AlexWortega/Sweetybot2/designs/sensor-v03/cad/src/README.md

# v03 native CAD parts

Quantities and masses are recorded in `../../reports/cad_parts.json` relative to this folder. Camera, sensor and servo envelopes are purchased-part keepouts; appearance-only screen graphics and pigment are not printed parts.

| Part | Quantity | Material |
|---|---:|---|
| deck | 1 | PETG |
| rail | 2 | PETG |
| body_shell | 1 | PETG |
| servo_cradle | 10 | PETG |
| servo_strap | 20 | PETG |
| roll_yoke | 4 | PETG |
| thigh_plate | 8 | PETG |
| shin_plate | 8 | PETG |
| hoof | 4 | PETG |
| head_shell | 1 | PETG |
| head_hatch | 1 | PETG |
| ear | 2 | PETG |
| mane | 1 | PETG |
| axle_adapter | 4 | PETG |
| knee_fork | 4 | PETG |
| head_yoke | 1 | PETG |
| tail | 1 | PETG |
| fit_coupon | 0 | PETG |
| horn | 1 | PETG |
| mane_stripe | 1 | PETG |
| neck_collar | 1 | PETG |
| thigh_fairing | 4 | PETG |
| shin_fairing | 4 | PETG |
| camera_carrier | 1 | PETG |
| sensor_tray | 1 | PETG |
| depth_pod | 1 | PETG |
| hoof_sole_plate | 4 | PETG |
| hoof_tpu_pad | 4 | TPU |
| hoof_actuator | 4 | TPU |
| eye_bezel | 2 | PETG |

Use `scripts.build_cad` from the candidate root to regenerate individual exports and assemblies. Vendor STS3250 geometry is retained under its existing notices. Print fits, strength and loaded sensor mechanisms remain unvalidated.
