AlexWortega/Sweetybot2/reports/legacy-v02/README.md

# Historical v02 engineering simulations

These files describe the old STS3250 chassis and controller, not the v04 hardware or policy. See ../v04_validation.json for current checks.
