AlexWortega/Sweetybot2/designs/sensor-v03/renders/studio/02-portrait.jpg

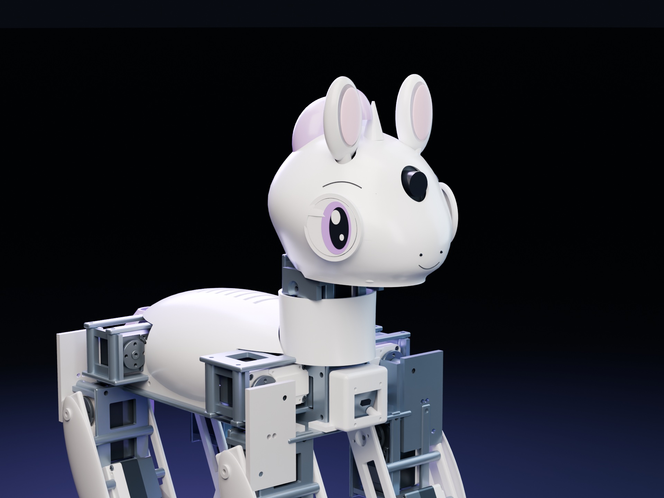
designs/sensor-v03/renders/studio/02-portrait.jpg
