AlexWortega/Sweetybot2/references/appearance/sweetie-official.jpg

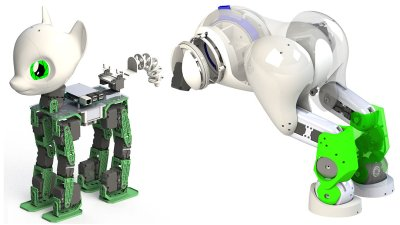
references/appearance/sweetie-official.jpg
