AlexWortega/Sweetybot2/references/appearance/sweetie-proto3-body.jpg

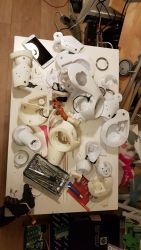
references/appearance/sweetie-proto3-body.jpg
