AlexWortega/Sweetybot2/renders/exploded.png

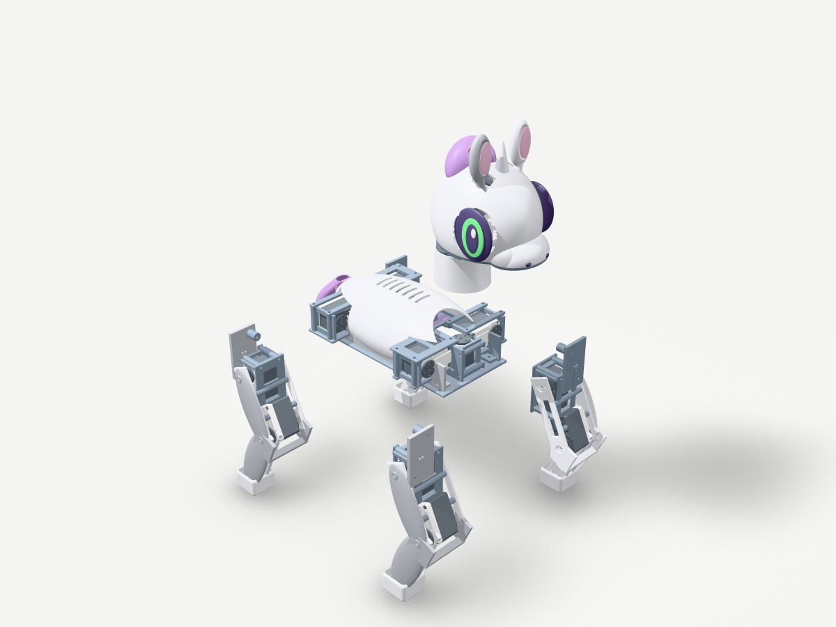
renders/exploded.png
