AlexWortega/Sweetybot2/renders/eyes_demo.gif

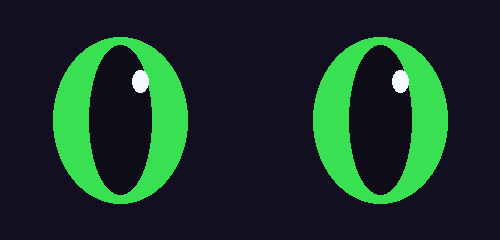
renders/eyes_demo.gif
