AlexWortega/Sweetybot2/renders/internal.png

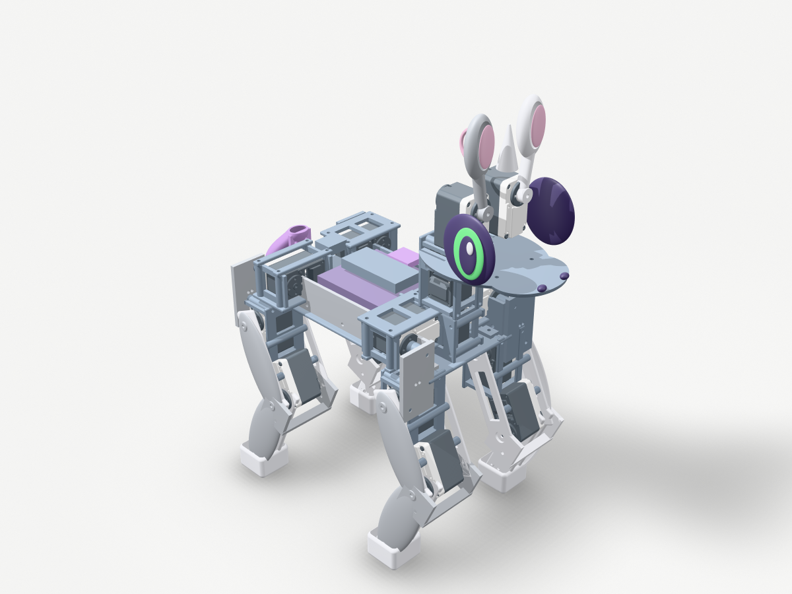
renders/internal.png
