AlexWortega/Sweetybot2/renders/v05/preview.png

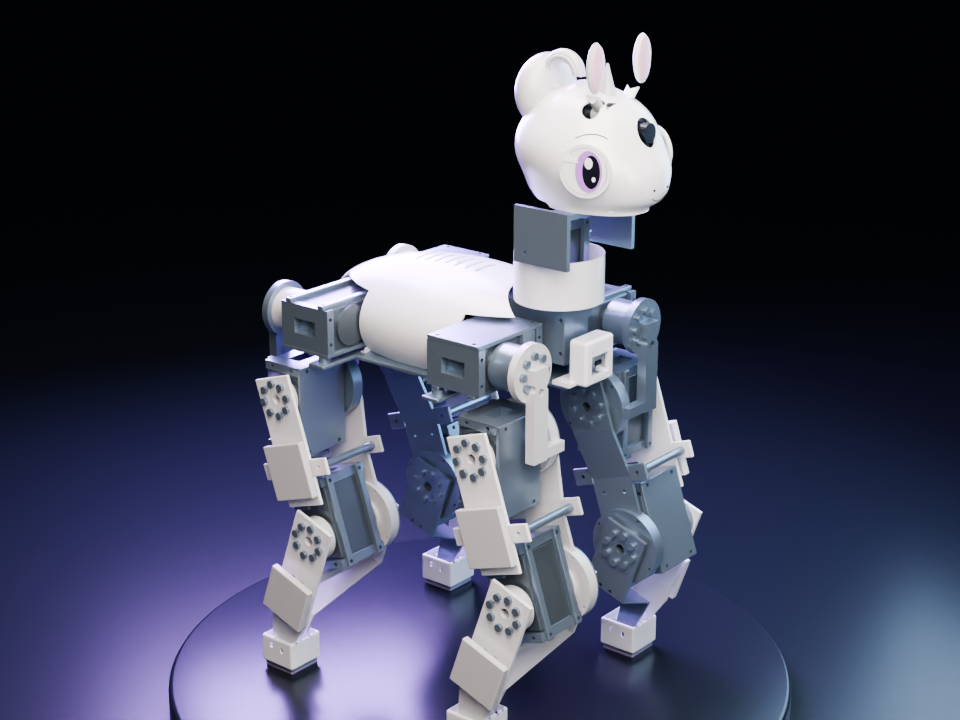
renders/v05/preview.png
