AlexWortega/Sweetybot2/renders/v05/turntable/001.png

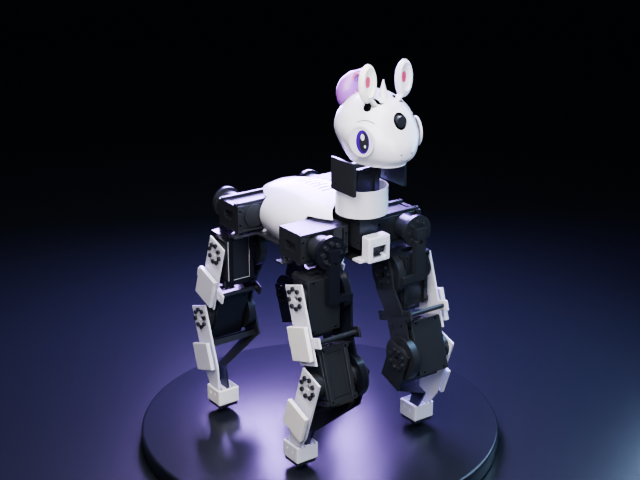
renders/v05/turntable/001.png
