AlexWortega/Sweetybot2/renders/v05/turntable/002.png

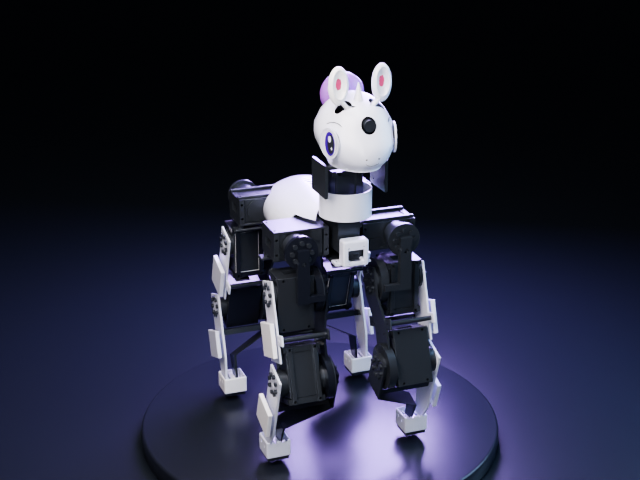
renders/v05/turntable/002.png
