AlexWortega/Sweetybot2/renders/v05/turntable/003.png

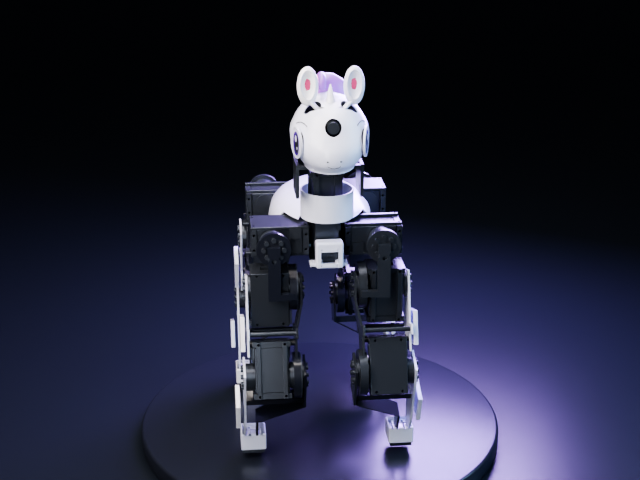
renders/v05/turntable/003.png
