AlexWortega/Sweetybot2/renders/v05/turntable/004.png

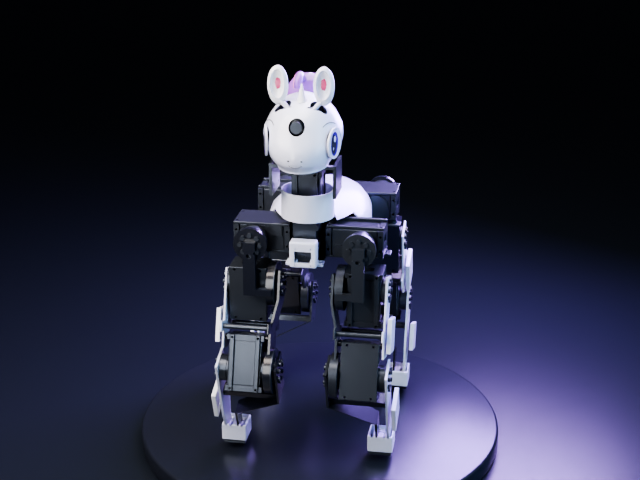
renders/v05/turntable/004.png
