AlexWortega/Sweetybot2/renders/v05/turntable/005.png

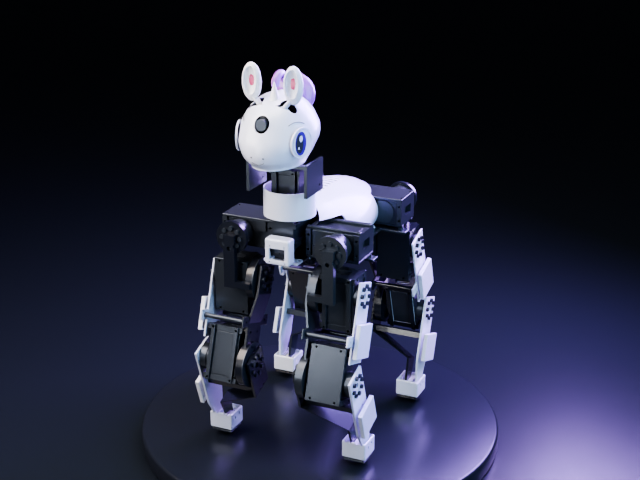
renders/v05/turntable/005.png
