AlexWortega/Sweetybot2/renders/v05/turntable/006.png

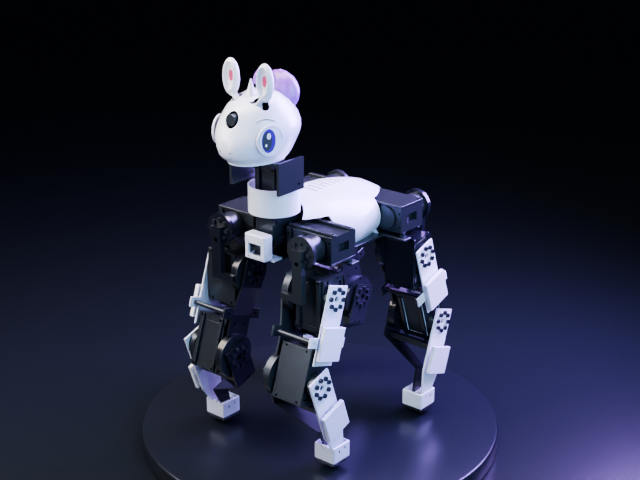
renders/v05/turntable/006.png
