AlexWortega/Sweetybot2/renders/v05/turntable/007.png

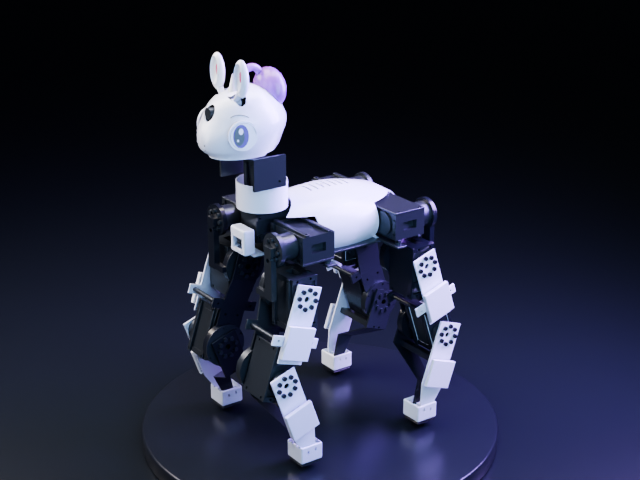
renders/v05/turntable/007.png
