AlexWortega/Sweetybot2/renders/v05/turntable/008.png

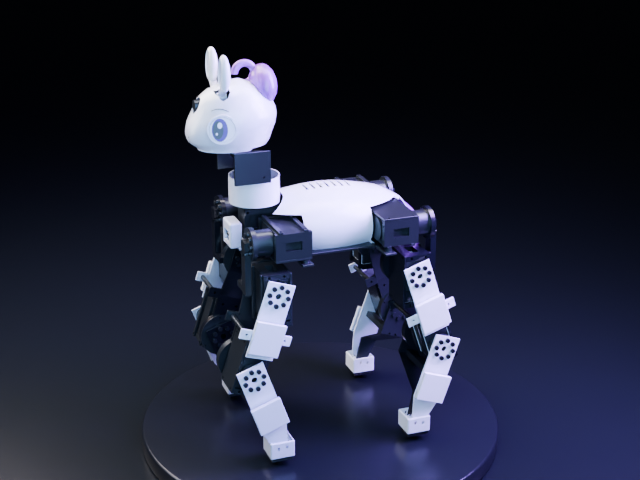
renders/v05/turntable/008.png
