AlexWortega/Sweetybot2/renders/v05/turntable/009.png

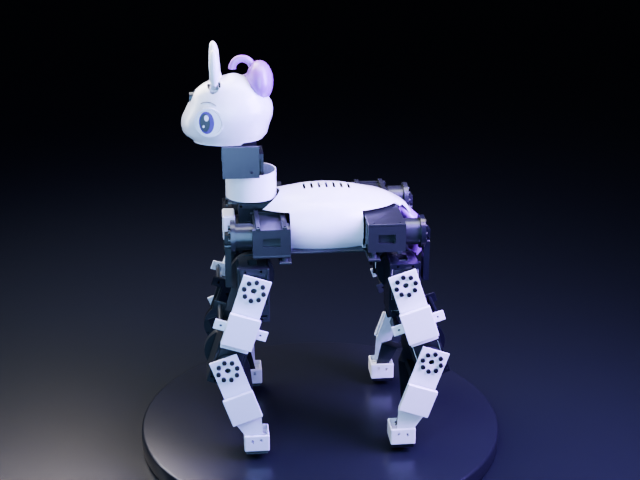
renders/v05/turntable/009.png
