AlexWortega/Sweetybot2/renders/v05/turntable/010.png

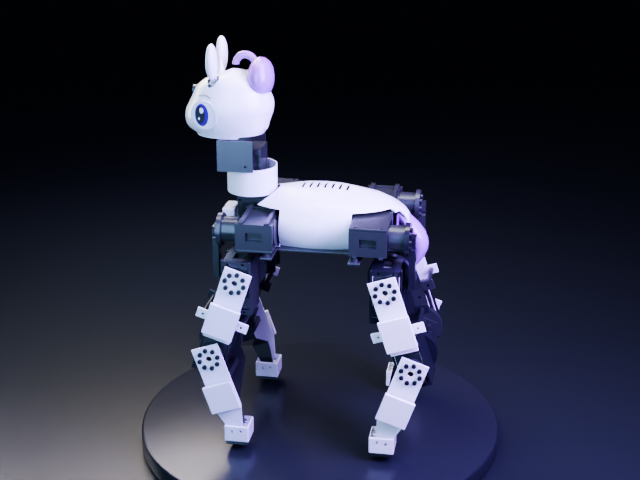
renders/v05/turntable/010.png
