AlexWortega/Sweetybot2/renders/v05/turntable/011.png

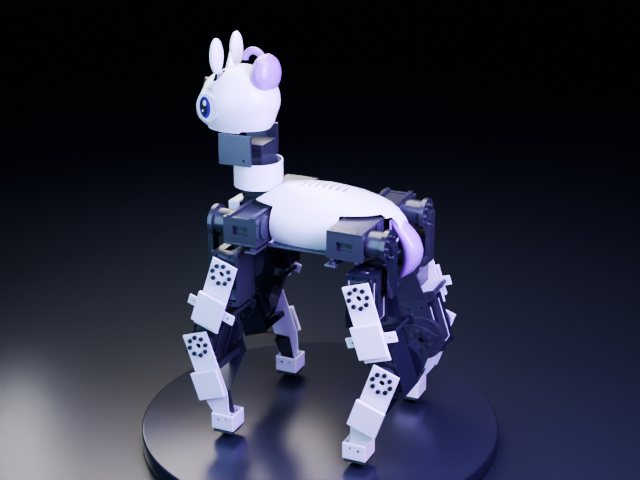
renders/v05/turntable/011.png
