AlexWortega/Sweetybot2/renders/v05/turntable/012.png

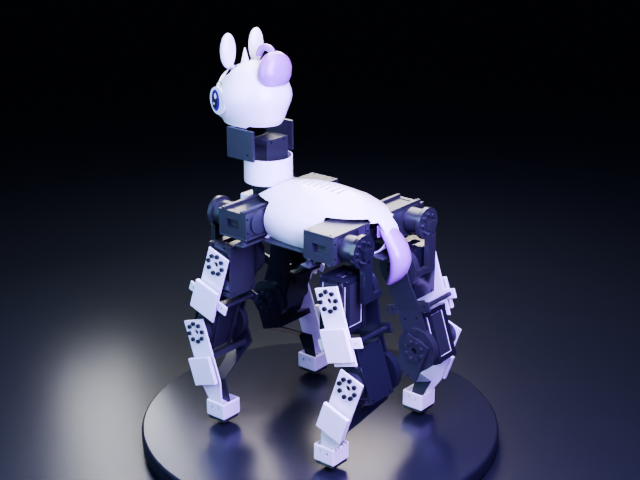
renders/v05/turntable/012.png
