AlexWortega/Sweetybot2/renders/v05/turntable/013.png

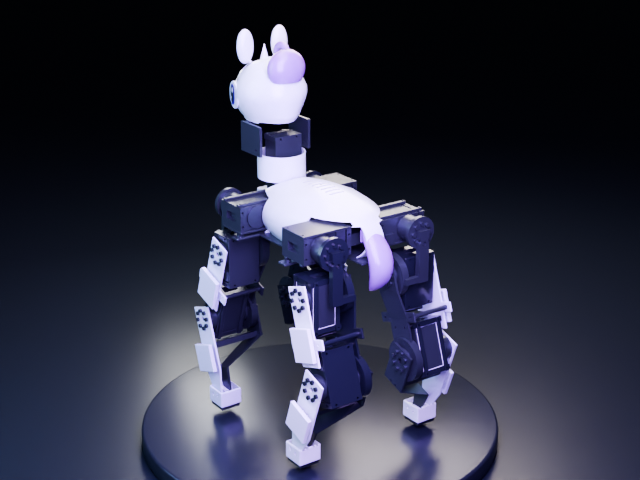
renders/v05/turntable/013.png
