AlexWortega/Sweetybot2/renders/v05/turntable/014.png

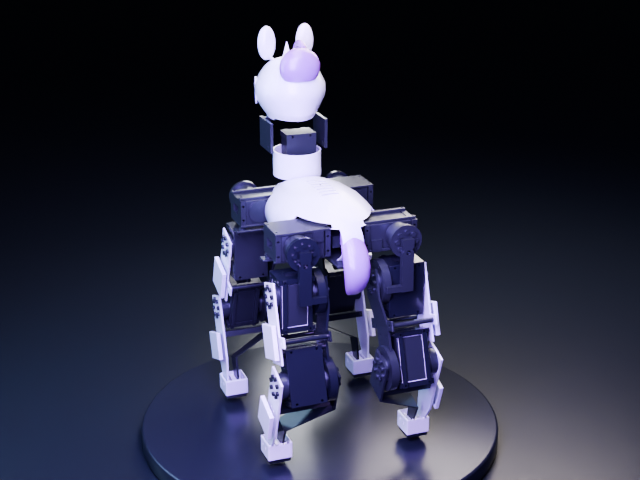
renders/v05/turntable/014.png
