AlexWortega/Sweetybot2/renders/v05/turntable/015.png

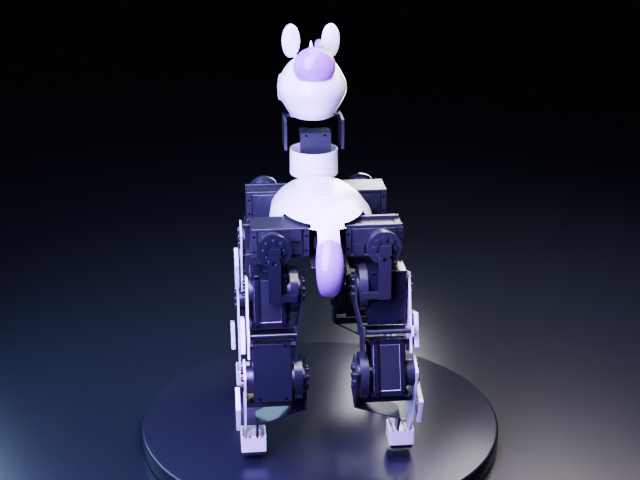
renders/v05/turntable/015.png
