AlexWortega/Sweetybot2/renders/v05/turntable/016.png

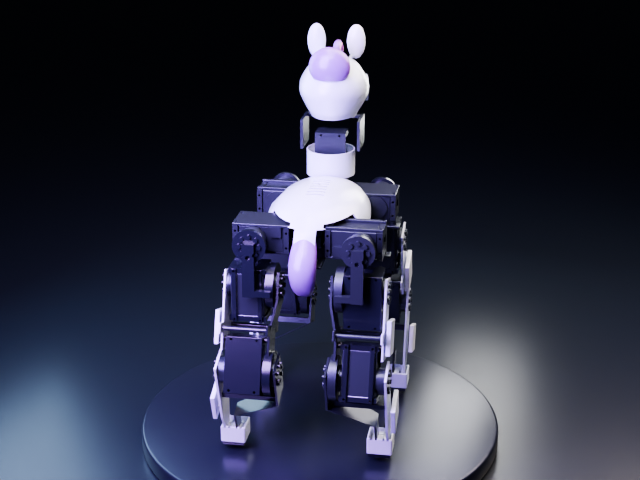
renders/v05/turntable/016.png
