AlexWortega/Sweetybot2/renders/v05/turntable/017.png

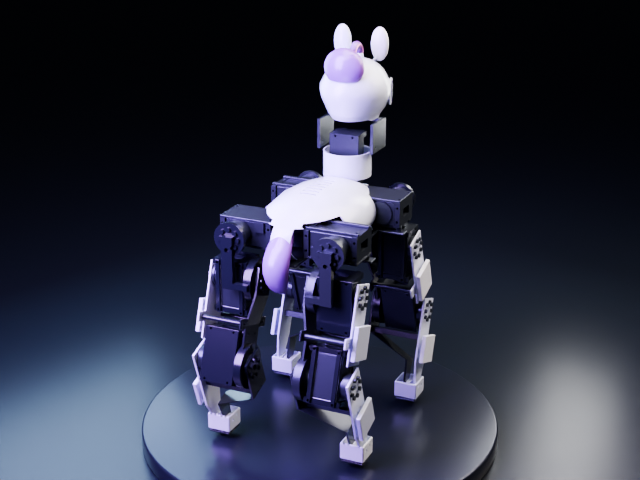
renders/v05/turntable/017.png
