AlexWortega/Sweetybot2/renders/v05/turntable/018.png

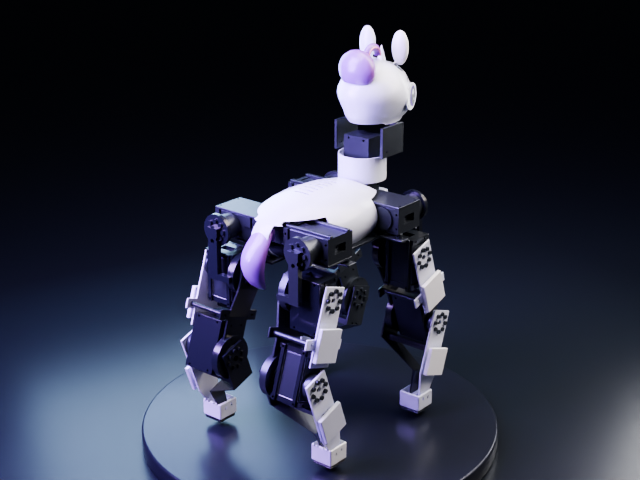
renders/v05/turntable/018.png
