AlexWortega/Sweetybot2/renders/v05/turntable/019.png

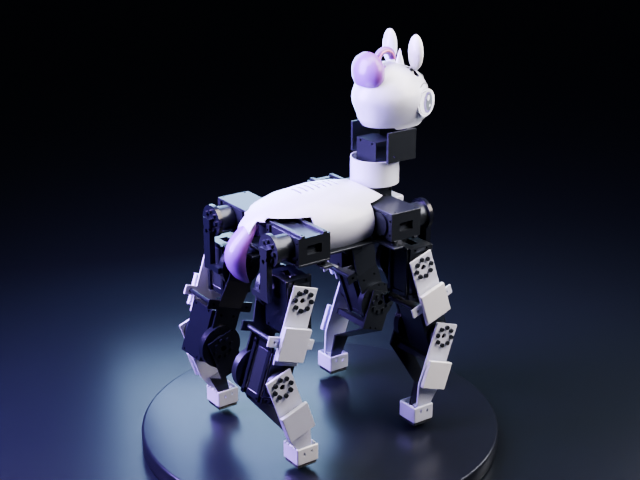
renders/v05/turntable/019.png
