AlexWortega/Sweetybot2/renders/v05/turntable/020.png

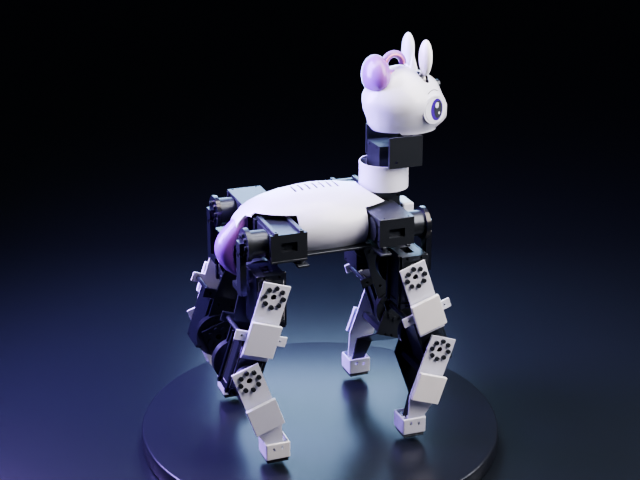
renders/v05/turntable/020.png
