AlexWortega/Sweetybot2/renders/v05/turntable/021.png

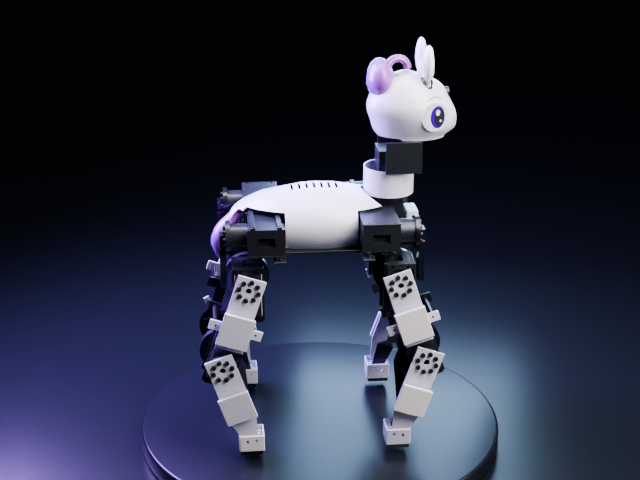
renders/v05/turntable/021.png
