AlexWortega/Sweetybot2/renders/v05/turntable/022.png

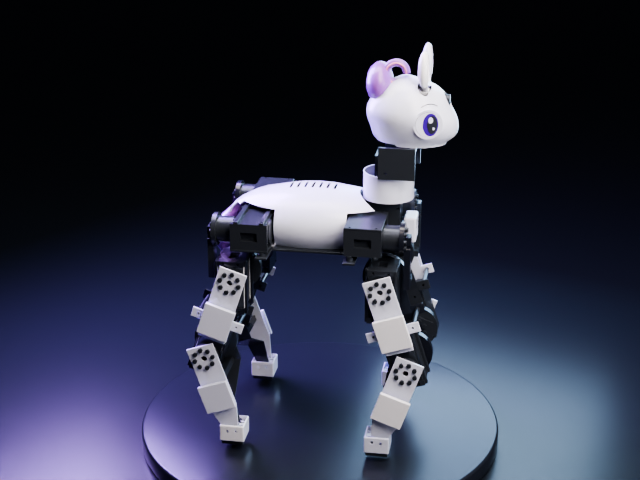
renders/v05/turntable/022.png
