AlexWortega/Sweetybot2/renders/v05/turntable/023.png

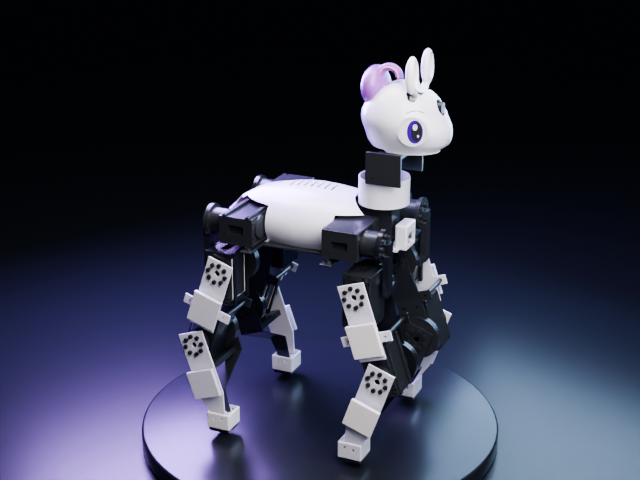
renders/v05/turntable/023.png
