AlexWortega/Sweetybot2/docs/bom-v05.csv

item | quantity | status | notes | url | unit_usd
SM105BL-C001 | 12 | candidate; not purchased | RS485 | https://ftservo.github.io/ftservo-wiki/products/models/sm-105b-c001/main/ | 120.0
STS3250-12V | 2 | candidate; not purchased | TTL SMS/STS; confirm firmware protocol | https://www.feetechrc.com/sts_ttl_series%20servo.html | 44.99
STS3032-C001-6V | 2 | candidate; not purchased | TTL SMS/STS; confirm firmware protocol | https://www.feetechrc.com/Data/feetechrc/upload/file/20200611/6372749220559698399729459.pdf | 12.0
Pololu D30V30F6 6V regulator | 1 | candidate | validate current and temperature at 3S LiFePO4 input
Dedicated 3V3 >=0.5A regulator | 1 | selection allowance | depth module supply; 13x10x5mm envelope provisional
Raspberry Pi Camera Module 3 Wide visible-light | 1 | candidate | 25x24 PCB and 12.4mm optical keepout
Pi Zero 22-pin to camera 15-pin CSI FPC | 1 | candidate | 300mm allowance; check motion loop and bending
SparkFun SEN-18642 VL53L5CX | 1 | candidate | chest 8x8 depth 15Hz target
SparkFun SEN-21325 LSM6DSV16X | 1 | candidate | rigid torso IMU
Seeed XIAO RP2040 | 1 | candidate | ADC contacts and IMU collector; firmware pending
Waveshare 1.28inch GC9A01 LCD Module | 2 | candidate | 240x240 round active area; exact module depth pending
Omron B3SE-1002P | 4 | candidate | contact switch only; no force measurement
Contact cassette PCB 12x12mm | 4 | proposed custom | layout not fabricated; include 10k EOL and series 1k
10k 1% pull-up resistor at collector | 4 | candidate | one per ADC contact signal
10k 1% EOL resistor at hoof | 4 | candidate | must sit beyond foot connector
1k 1% series contact resistor at hoof | 4 | candidate | switch branch parallel to EOL
M2 guide/shoulder hardware sets | 16 | fit selection pending | verify stroke and captive retention in single hoof prototype
Return spring OD3.5mm ID>=2.2mm free4mm | 16 | selection pending | low preload target <=0.1N per spring at installed length
Adjustable M2 actuator screw/shims | 4 | fit selection pending | compliant TPU tip and hard stop calibrated on bench
Strain relief and foot connectors | 4 sets | selection pending | seal exposed PCB and wire exits
Sensor tray | 1 | printed PETG | rigid IMU mounting
Chest depth pod | 1 | printed PETG | open optics aperture; protective window not specified
Camera carrier | 1 | printed PETG | edge clip fit coupon required
LCD bezel | 2 | printed PETG | cosmetic rim; positive PCB retention requires exact module revision
Contact hoof carrier | 4 | printed PETG | replace v02 hoof
Floating sole plate | 4 | printed PETG | hard stop carries load
Hoof tread | 4 | printed TPU | verify friction and fatigue
Actuator tip | 4 | printed TPU | verify switch actuation and overtravel
Raspberry Pi Zero 2 W + microSD | 1 | procurement specification | logic compute
USB RS485 adapter, 3.3V-safe USB logic, SMS protocol support | 1 | procurement specification | 12 leg motors only; differential A/B and common reference
Waveshare Bus Servo Adapter A (TTL only), 42x33mm | 1 | procurement specification | 2 neck and 2 ear motors; TTL signal bus separate from RS485
Adafruit CH334F USB hub 5999 + OTG and adapter cables | 1 | procurement specification | Pi Zero has one USB data port; envelope and cable routing provisional
3S LiFePO4 >=2.5Ah pack with >=40A continuous BMS | 1 | procurement specification | 9.9V nominal, 10.8V max, loaded cutoff 9.3V; real pack sag unmeasured
40A main fuse, four 10A leg, 5A head and 5A logic fuses | 1 | procurement specification | DC disconnect and fuse coordination require loaded tests
12AWG main, 16AWG leg branches, rated connectors | 1 | procurement specification | short feeds; fused parallel power; do not daisy-chain motor load current
5V >=3A logic buck + motor-only disconnect | 1 | procurement specification | logic survives motor emergency stop
6061 CNC load parts | 1 | procurement specification | deck, rails, clamps, yokes, cheek plates, forks, adapters and spacers; not FDM load parts
6807 bearings, 35x47x7mm | 8 | procurement specification | catalogue envelope; fits, retention and external load rating require bench checks
0.75 and 0.80mm rigid shim stock for 14 motor clamps | 70 | procurement specification | case and strap seating pads, gauge against purchased cases
M3 low socket heads, <=6mm diameter and <=3mm height | 160 | procurement specification | 8 per driven flange, heads included in CAD; confirm screw lengths and engagement
M2 bearing retainers and neck/ear horns | 1 | procurement specification | shaft spline datum, screw lengths, shoulder fits and loaded joints remain physical gates
