AlexWortega/Sweetybot2/renders/parts_review.jpg

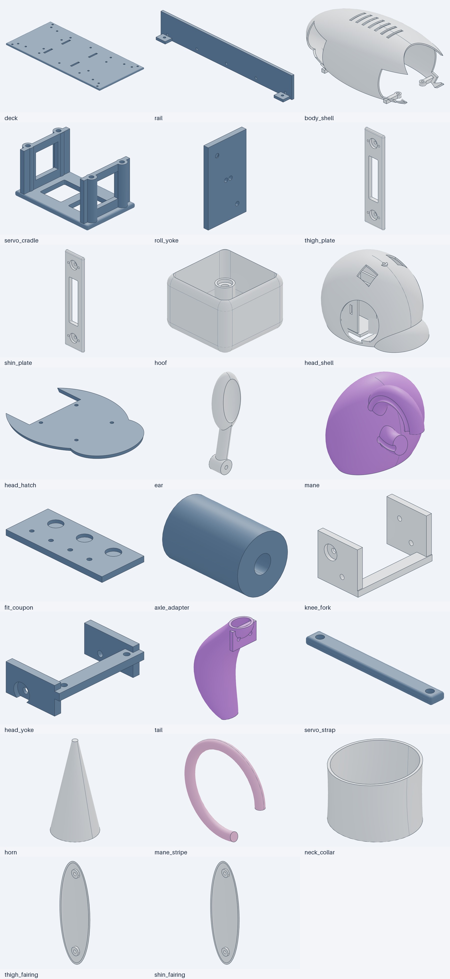
renders/parts_review.jpg
