AlexWortega/Sweetybot2/cad/collision/convex/torso__body_cowl__568.stl

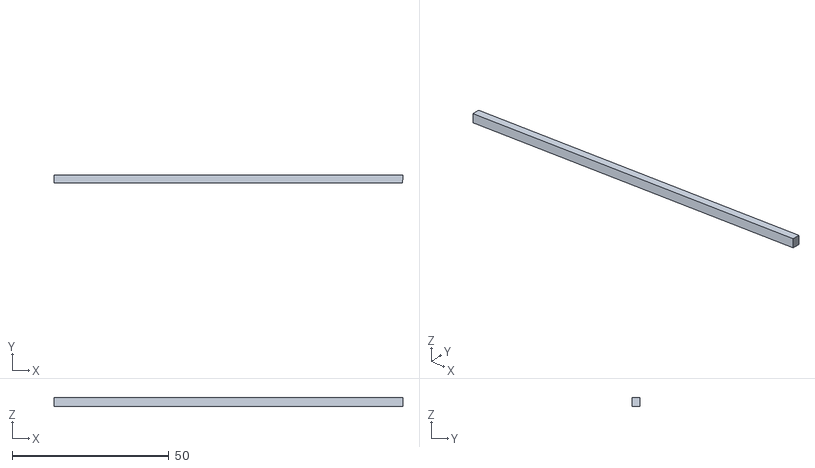
[picture p46: CAD file, 2026-10-18]
cad/collision/convex/torso__body_cowl__568.stl
111.4 x 2.44 x 2.88
