AlexWortega/Sweetybot2/cad/collision/source/ear_right__ear_output_adapter_-1.step

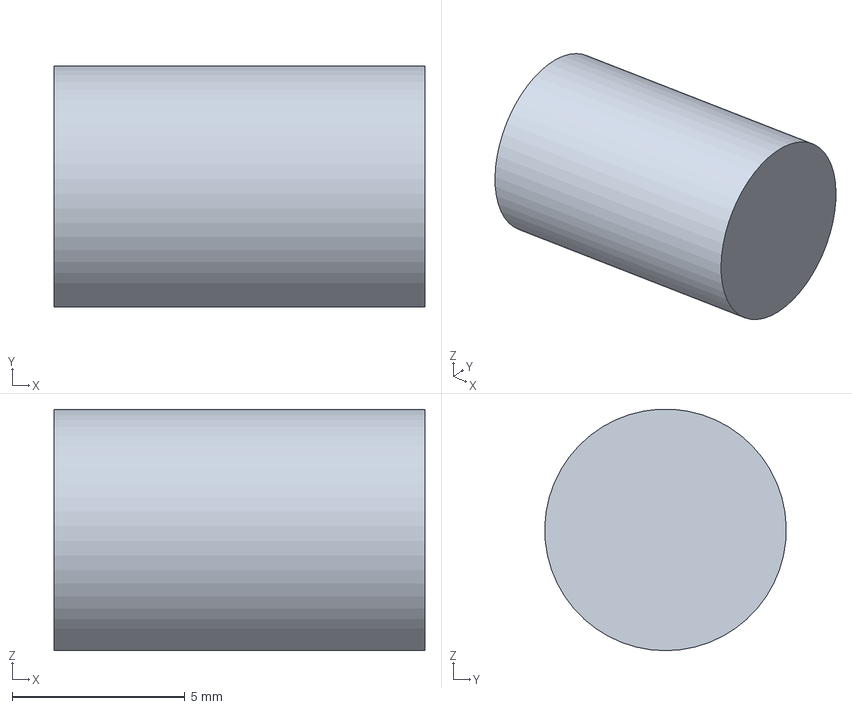
[picture p47: CAD file, 2026-10-21]
cad/collision/source/ear_right__ear_output_adapter_-1.step
10.8 x 7.00 x 6.99 mm
