AlexWortega/Sweetybot2/cad/manufacturing/torso__rl_roll_clamp_shims.step

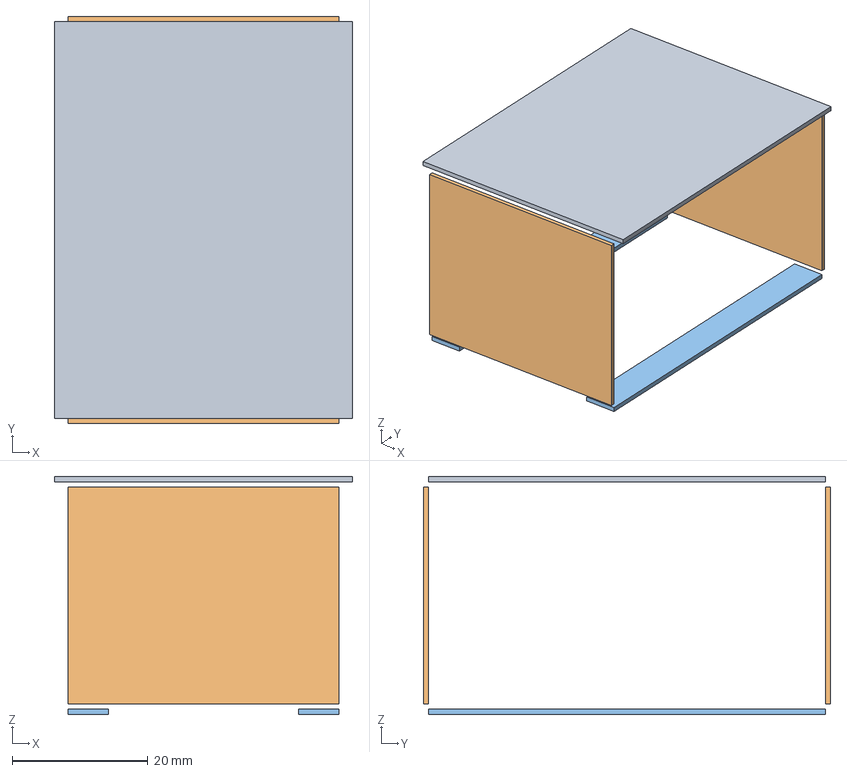
[picture p48: CAD file, 2026-10-21]
cad/manufacturing/torso__rl_roll_clamp_shims.step
44.0 x 60.0 x 35.1 mm
