AlexWortega/Sweetybot2/cad/STEP/exploded.step

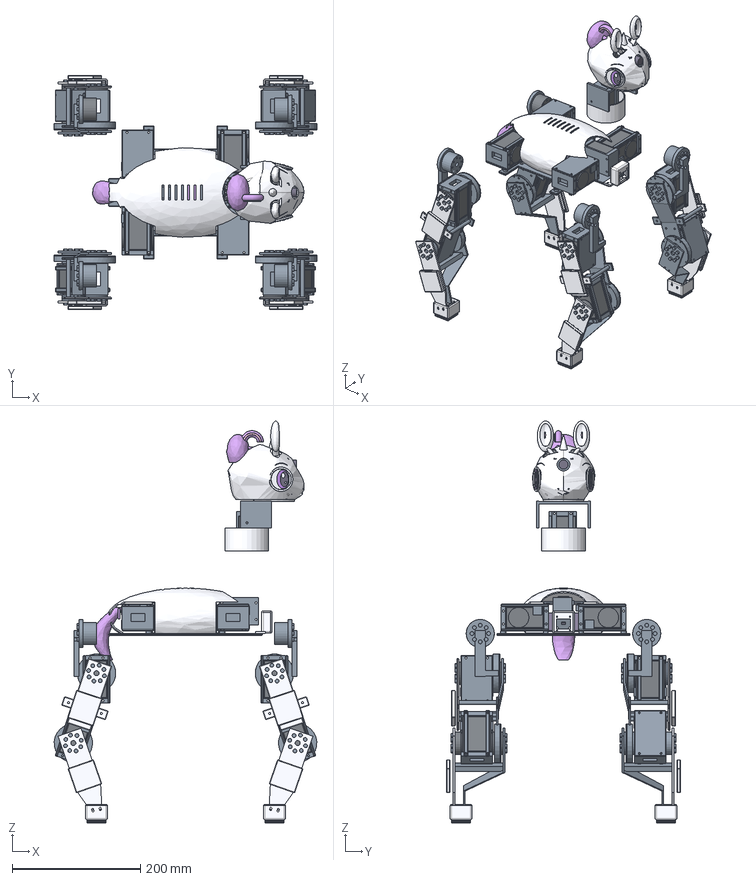
[picture p49: CAD file, 2026-10-21]
cad/STEP/exploded.step
410.3 x 366.0 x 628.0 mm
chassis_deck
rail_-1
rail_1
body_cowl
passive_tail
battery_envelope
compute_envelope
regulator_envelope
head_yaw_servo
head_yaw_cradle
head_yaw_cradle_strap_-7
head_yaw_cradle_strap_-33
sensor_tray
imu_board
collector
chest_tof_pod
depth_board
depth_optic
ear_6V_buck
depth_3V3_buck
adapter_envelope
fl_roll_servo
fl_roll_cradle
fl_roll_strap_-41_55
fl_roll_strap_-7_55
fr_roll_servo
fr_roll_cradle
fr_roll_strap_-41_55
fr_roll_strap_-7_55
rl_roll_servo
rl_roll_cradle
rl_roll_strap_-41_55
rl_roll_strap_-7_55
rr_roll_servo
rr_roll_cradle
rr_roll_strap_-41_55
rr_roll_strap_-7_55
rs485_adapter
usb_hub
fl_pitch_servo
fl_pitch_cradle
fl_pitch_strap_-41_55
fl_pitch_strap_-7_55
fl_roll_yoke
fl_roll_axle
fl_hip_passive_bearing
fl_hip_bearing_retainer
fl_pitch_mount_spacer_-10
fl_pitch_mount_spacer_10
fl_knee_servo
fl_knee_cradle
fl_knee_strap_-41_55
fl_knee_strap_-7_55
fl_thigh_cheek_front
fl_thigh_cheek_rear
fl_hip_front_rotor_spacer
fl_hip_rear_rotor_hub
fl_knee_passive_bearing
fl_knee_bearing_retainer
fl_thigh_spacer_-27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
