AlexWortega/Sweetybot2/cad/STEP/imported/feetech_sts3250.step

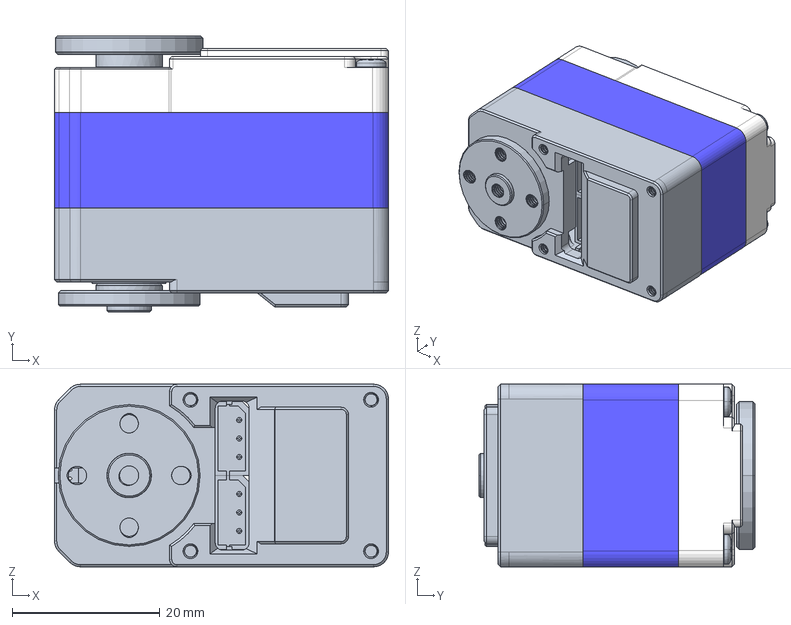
[picture p50: CAD file, 2026-10-17]
cad/STEP/imported/feetech_sts3250.step
45.2 x 37.4 x 24.7 mm
PRT0001
PRT0002
PRT0003
PRT0004 x 4
PRT0005 x 2
PRT0006
PRT0007
FK-AP-019-20210309
WJ-DP00-0002-FK-AP-020_1
