AlexWortega/Sweetybot2/cad/STL/links/fr_shin.stl

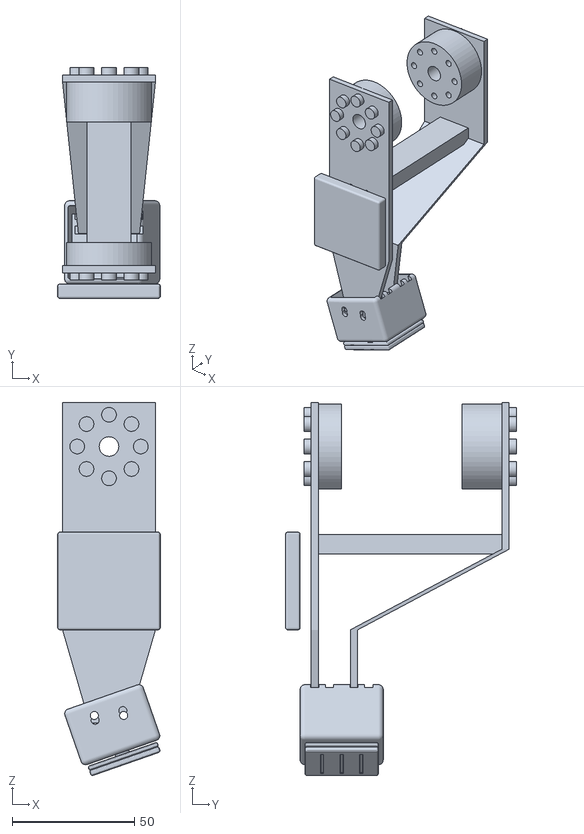
[picture p51: CAD file, 2026-10-18]
cad/STL/links/fr_shin.stl
42.0 x 94.5 x 152.6
