AlexWortega/Sweetybot2/cad/STL/tail.stl

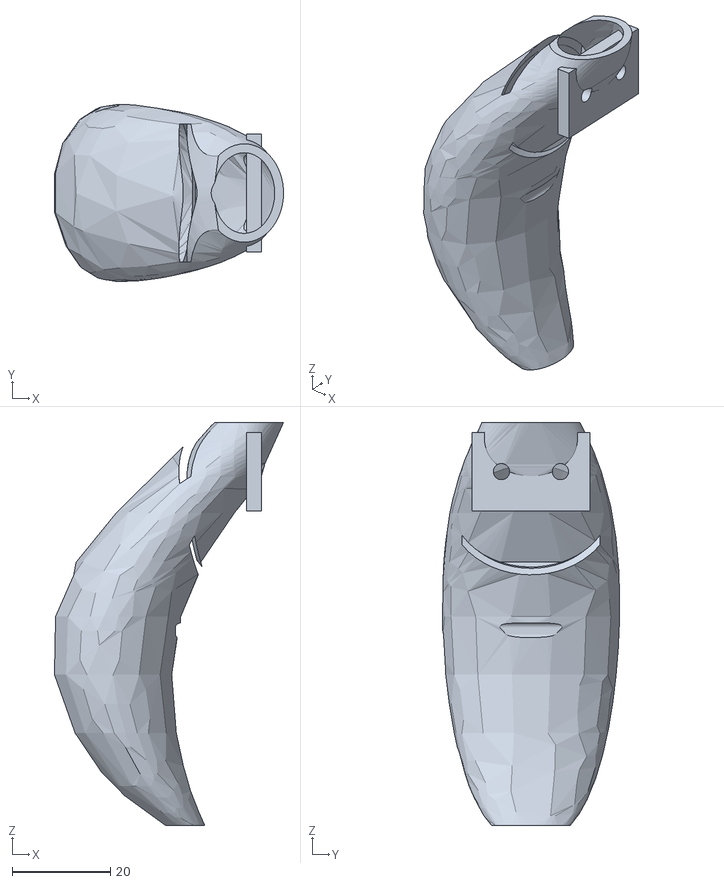
[picture p52: CAD file, 2026-10-18]
cad/STL/tail.stl
46.6 x 36.1 x 82.0
