AlexWortega/Sweetybot2/designs/sensor-v03/cad/STEP/imported/bearing_623zz.step

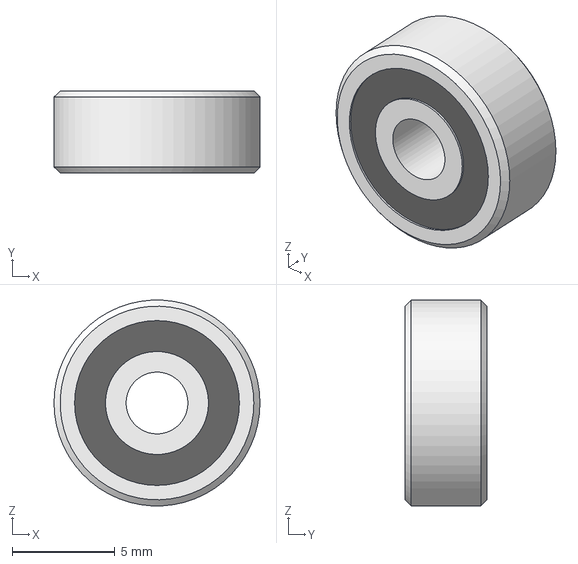
[picture p53: CAD file, 2026-10-17]
designs/sensor-v03/cad/STEP/imported/bearing_623zz.step
10.0 x 4.00 x 9.99 mm
