AlexWortega/Sweetybot2/designs/sensor-v03/cad/STEP/mane.step

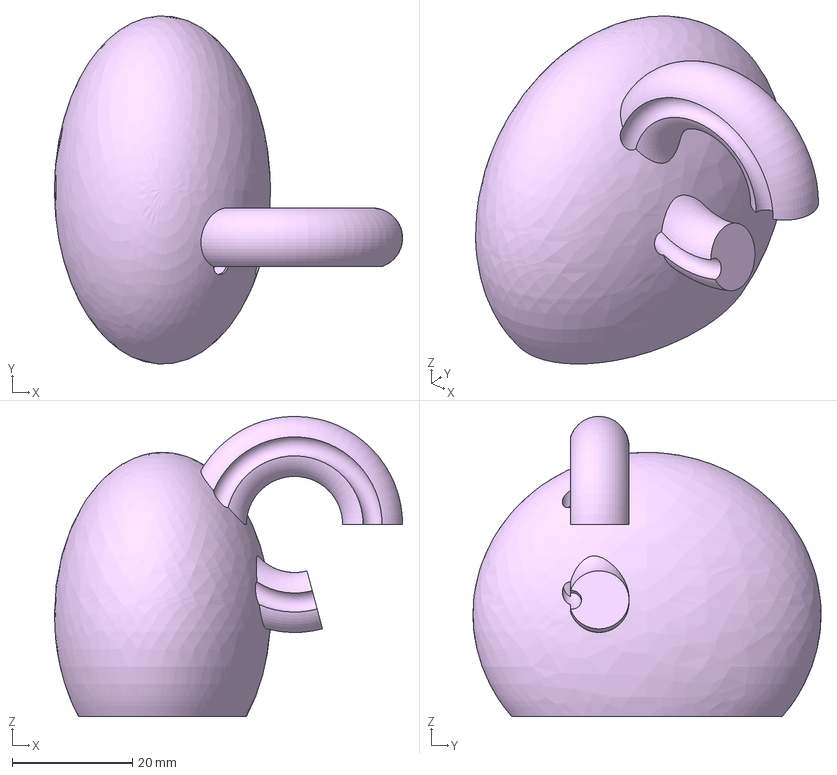
[picture p54: CAD file, 2026-10-17]
designs/sensor-v03/cad/STEP/mane.step
58.0 x 58.0 x 50.0 mm
