AlexWortega/Sweetybot2/designs/sensor-v03/cad/STL/thigh_plate.stl

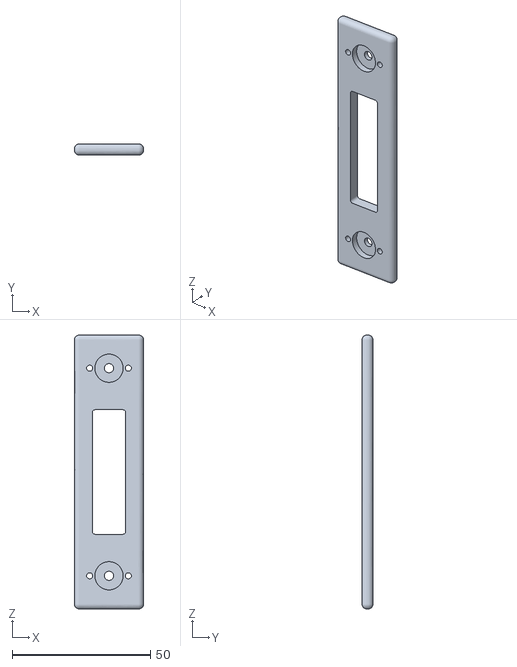
[picture p55: CAD file, 2026-10-17]
designs/sensor-v03/cad/STL/thigh_plate.stl
25.0 x 4.00 x 99.0
