AlexWortega/Sweetybot2/cad/collision/convex/head__pony_head_shell__190.stl

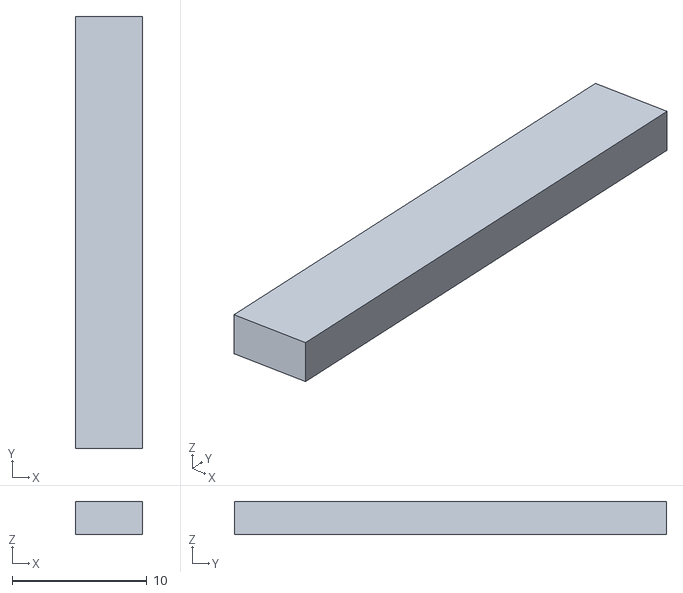
[picture p56: CAD file, 2026-10-18]
cad/collision/convex/head__pony_head_shell__190.stl
4.96 x 32.1 x 2.46
