AlexWortega/Sweetybot2/cad/collision/source/fl_thigh__fl_knee_strap_-41.55.step

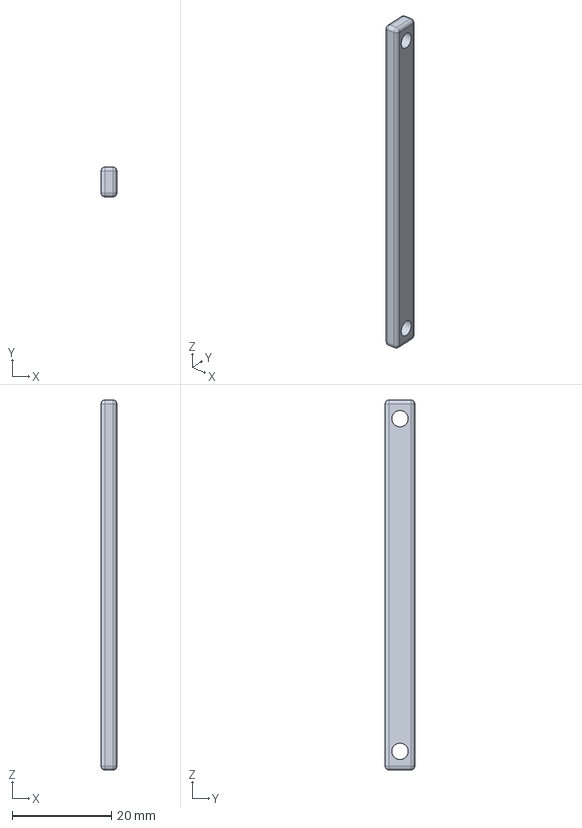
[picture p57: CAD file, 2026-10-21]
cad/collision/source/fl_thigh__fl_knee_strap_-41.55.step
3.20 x 6.00 x 74.5 mm
