AlexWortega/Sweetybot2/cad/manufacturing/rl_thigh__rl_knee_mount_spacer_-10_1.725.step

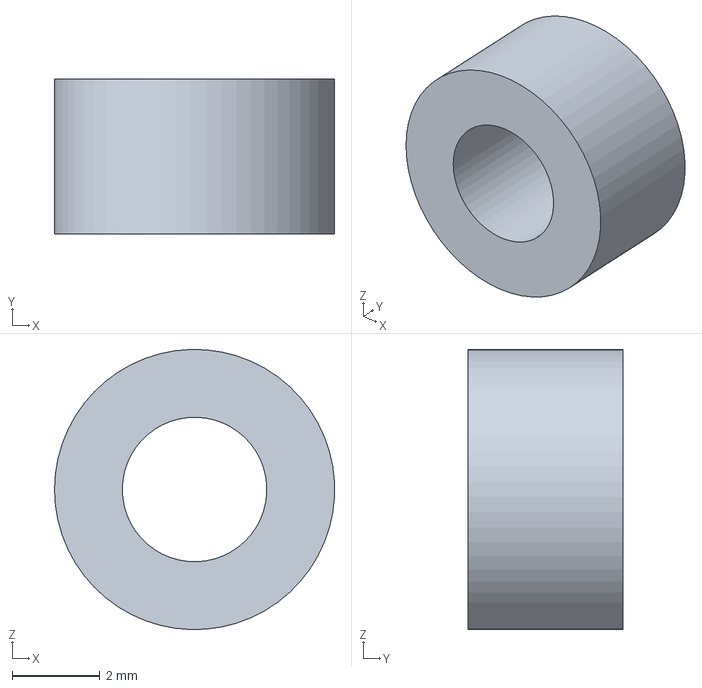
[picture p58: CAD file, 2026-10-21]
cad/manufacturing/rl_thigh__rl_knee_mount_spacer_-10_1.725.step
6.40 x 3.55 x 6.40 mm
