AlexWortega/Sweetybot2/cad/STEP/imported/waveshare_feetech_st3215_servo.step

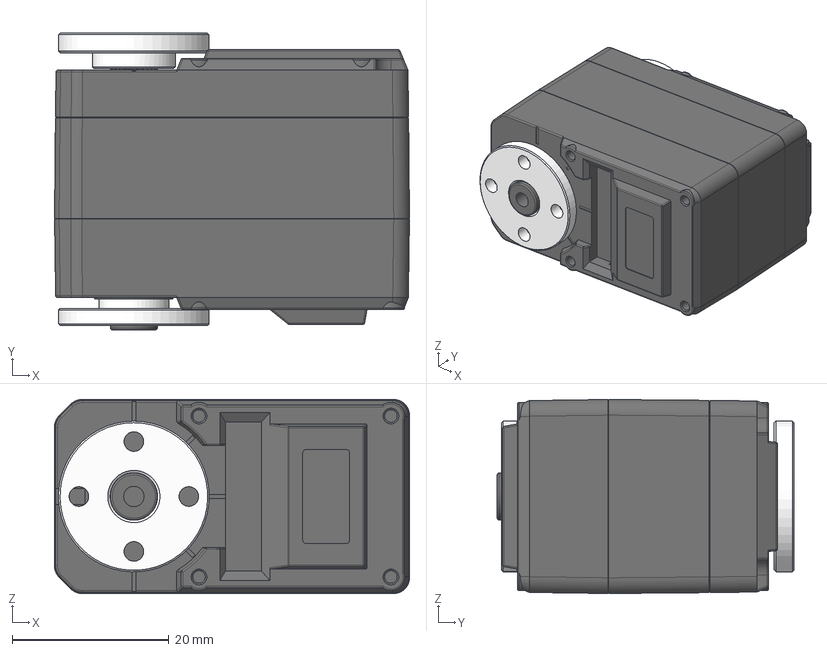
[picture p59: CAD file, 2026-10-17]
cad/STEP/imported/waveshare_feetech_st3215_servo.step
45.2 x 37.8 x 24.7 mm
ZK_122
SG-ZIJI_15
XG-ZIJI_16
MOTOR-1723_3
PCB-CHAZUO_92
GE_27
金属舵盘（驱动）
金属舵盘（从动）
