AlexWortega/Sweetybot2/cad/STL/fit_coupon.stl

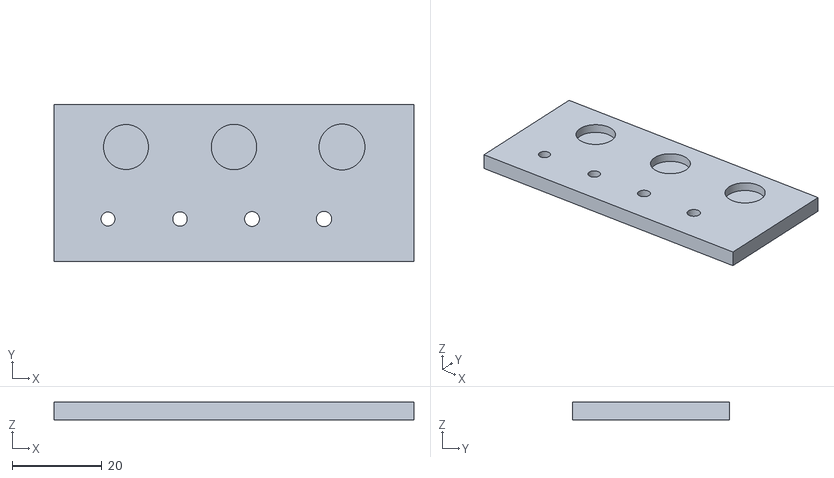
[picture p61: CAD file, 2026-10-17]
cad/STL/fit_coupon.stl
80.0 x 35.0 x 4.00
