AlexWortega/Sweetybot2/cad/STL/links/fr_roll.stl

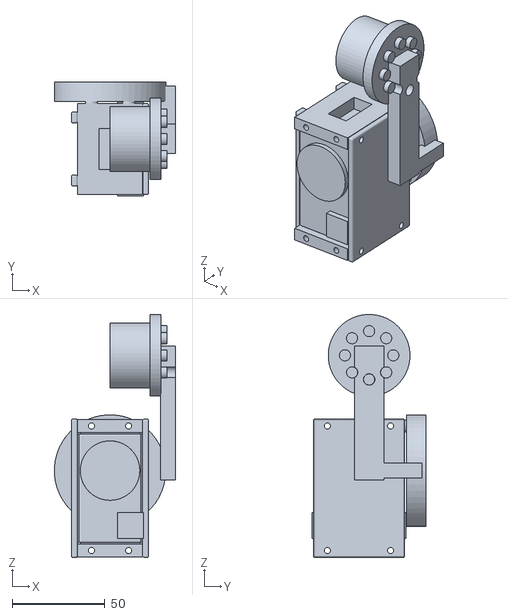
[picture p62: CAD file, 2026-10-18]
cad/STL/links/fr_roll.stl
65.2 x 61.1 x 130.7
