AlexWortega/Sweetybot2/designs/sensor-v03/cad/STEP/neck_collar.step

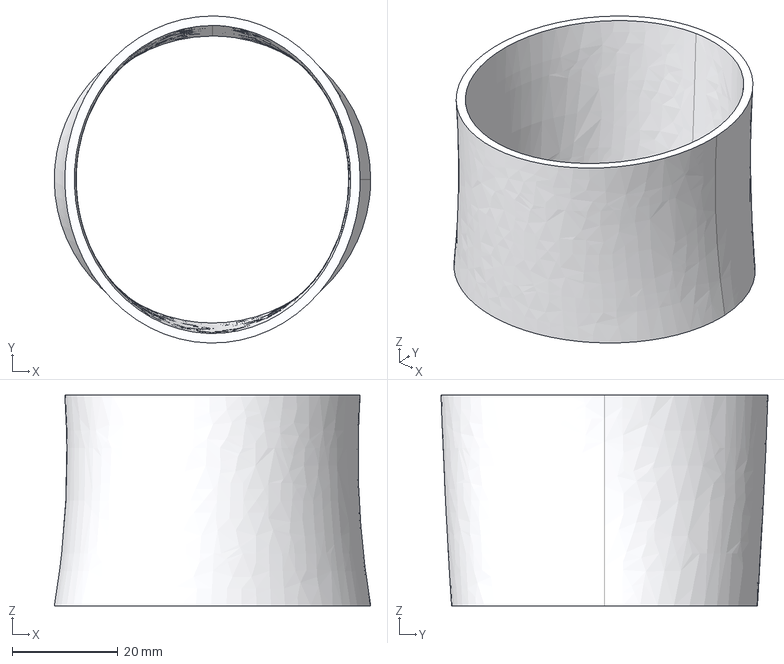
[picture p63: CAD file, 2026-10-17]
designs/sensor-v03/cad/STEP/neck_collar.step
60.0 x 62.0 x 40.0 mm
