AlexWortega/Sweetybot2/designs/sensor-v03/cad/STL/head_yoke.stl

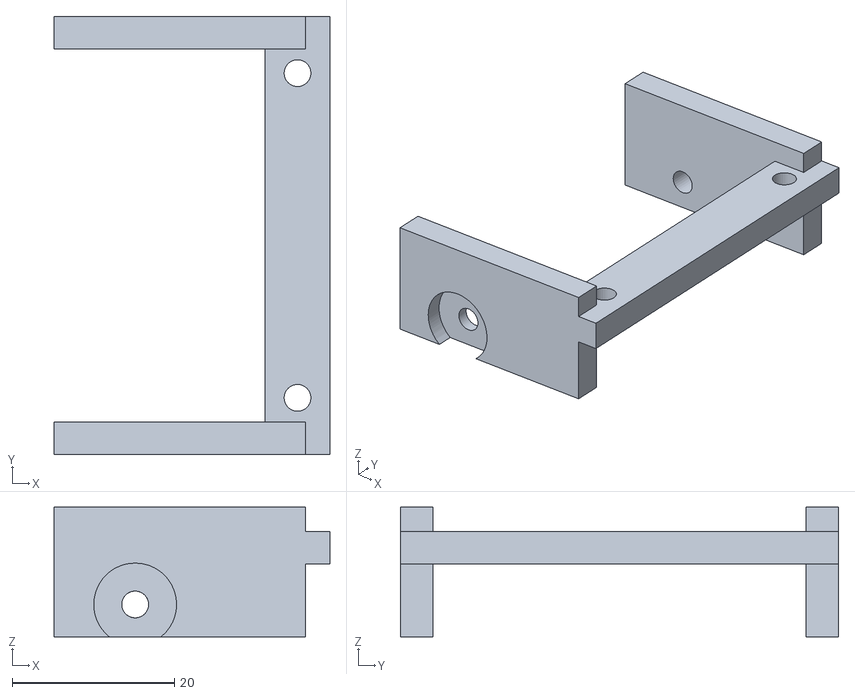
[picture p64: CAD file, 2026-10-17]
designs/sensor-v03/cad/STL/head_yoke.stl
34.0 x 54.0 x 16.0
