AlexWortega/Sweetybot2/cad/collision/convex/head__pony_head_shell__112.stl

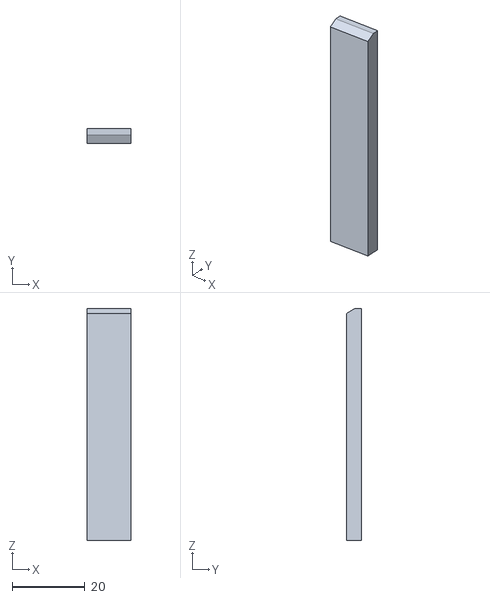
[picture p65: CAD file, 2026-10-18]
cad/collision/convex/head__pony_head_shell__112.stl
12.0 x 4.03 x 63.8
