AlexWortega/Sweetybot2/cad/collision/source/fr_thigh__fr_thigh_spacer_-27.step

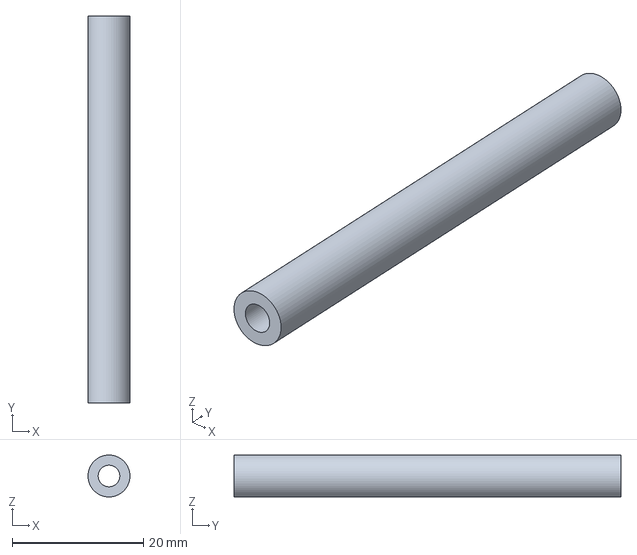
[picture p66: CAD file, 2026-10-21]
cad/collision/source/fr_thigh__fr_thigh_spacer_-27.step
6.39 x 59.0 x 6.40 mm
