AlexWortega/Sweetybot2/cad/manufacturing/rl_shin__rl_shin_fairing.step

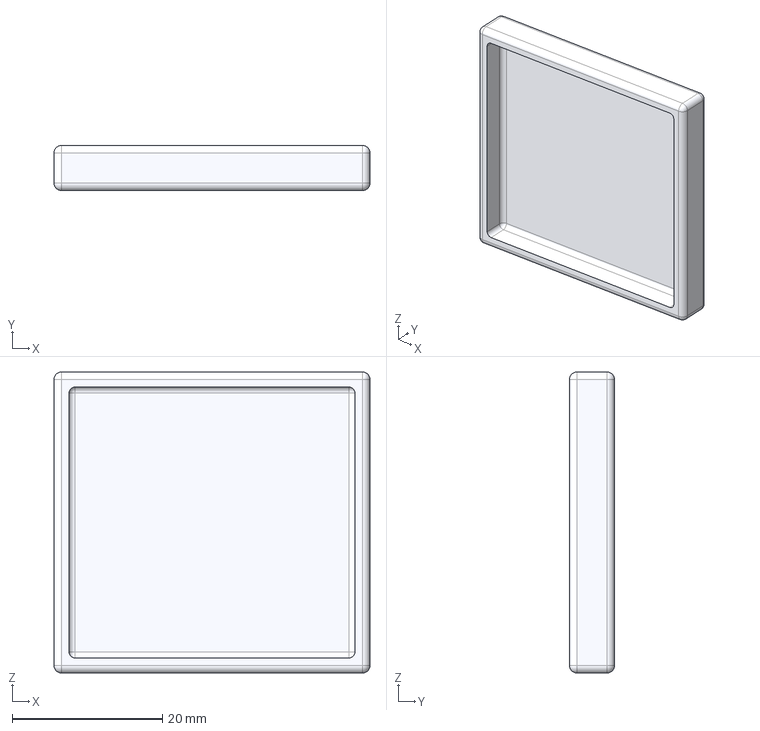
[picture p67: CAD file, 2026-10-21]
cad/manufacturing/rl_shin__rl_shin_fairing.step
42.0 x 6.00 x 40.0 mm
