AlexWortega/Sweetybot2/cad/STL/links/ear_right.stl

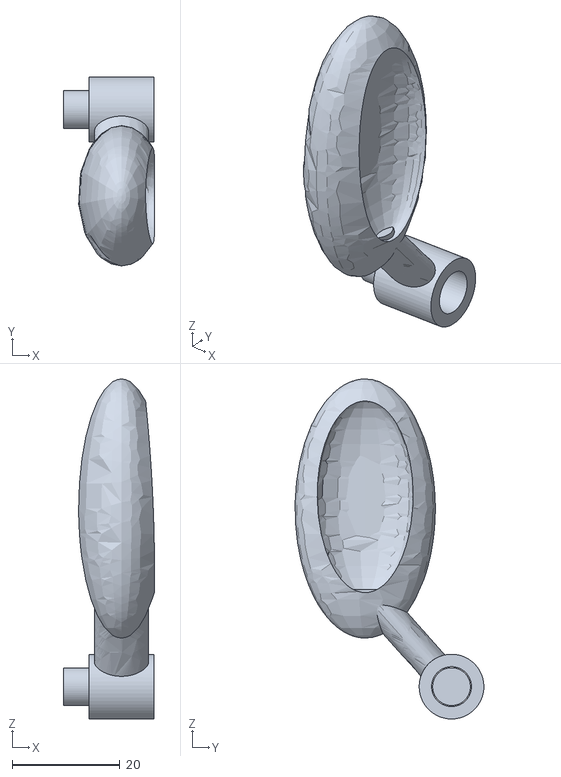
[picture p68: CAD file, 2026-10-18]
cad/STL/links/ear_right.stl
16.9 x 35.0 x 63.0
