AlexWortega/Sweetybot2/designs/sensor-v03/cad/STEP/camera_carrier.step

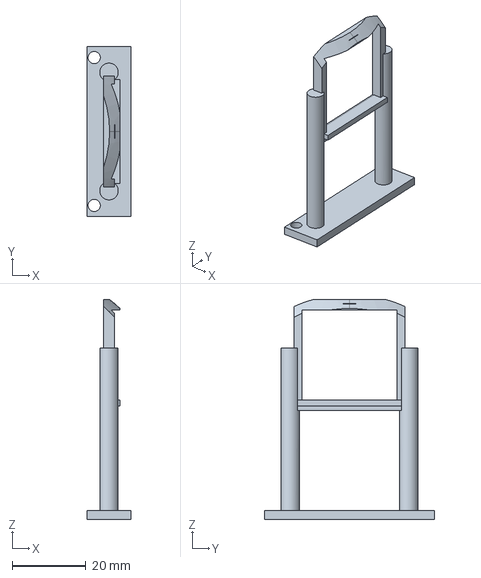
[picture p69: CAD file, 2026-10-17]
designs/sensor-v03/cad/STEP/camera_carrier.step
12.0 x 46.0 x 59.5 mm
