AlexWortega/Sweetybot2/designs/sensor-v03/cad/STL/knee_fork.stl

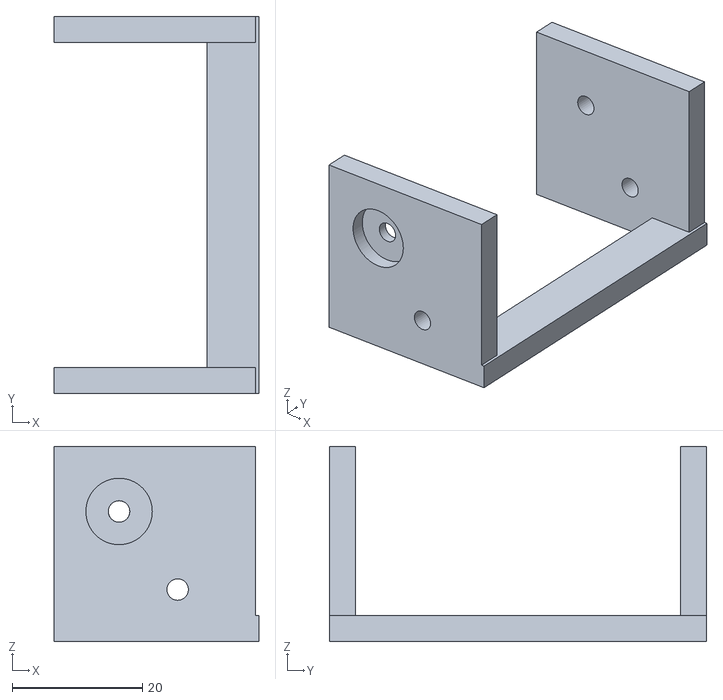
[picture p70: CAD file, 2026-10-17]
designs/sensor-v03/cad/STL/knee_fork.stl
31.5 x 58.0 x 30.0
