AlexWortega/Sweetybot2/cad/collision/convex/torso__body_cowl__240.stl

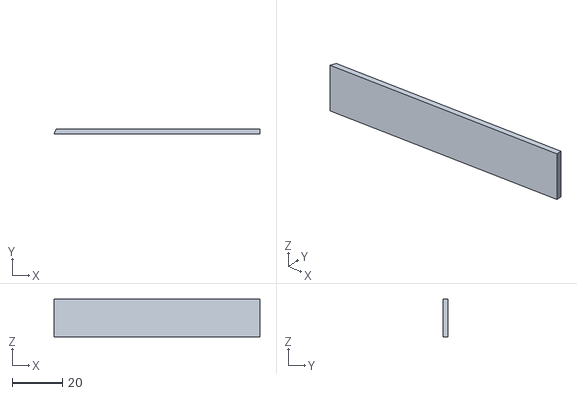
[picture p71: CAD file, 2026-10-18]
cad/collision/convex/torso__body_cowl__240.stl
81.6 x 1.89 x 14.9
