AlexWortega/Sweetybot2/cad/collision/source/head__display_sclera_-1.step

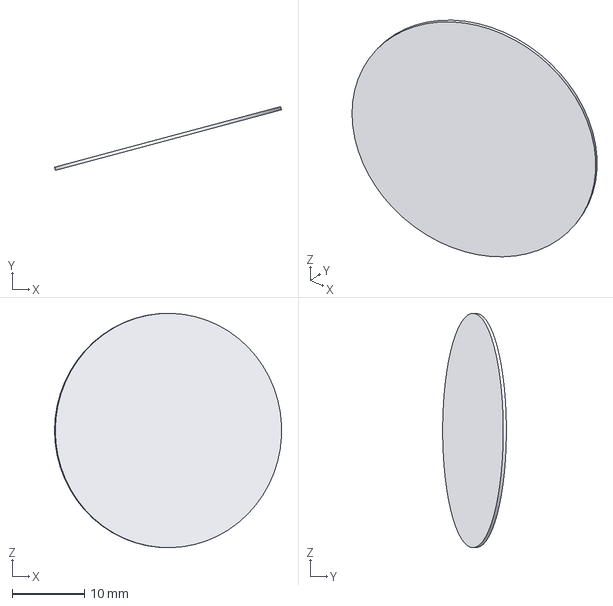
[picture p72: CAD file, 2026-10-21]
cad/collision/source/head__display_sclera_-1.step
31.4 x 8.81 x 32.4 mm
