AlexWortega/Sweetybot2/cad/manufacturing/rr_shin__rr_floating_sole.step

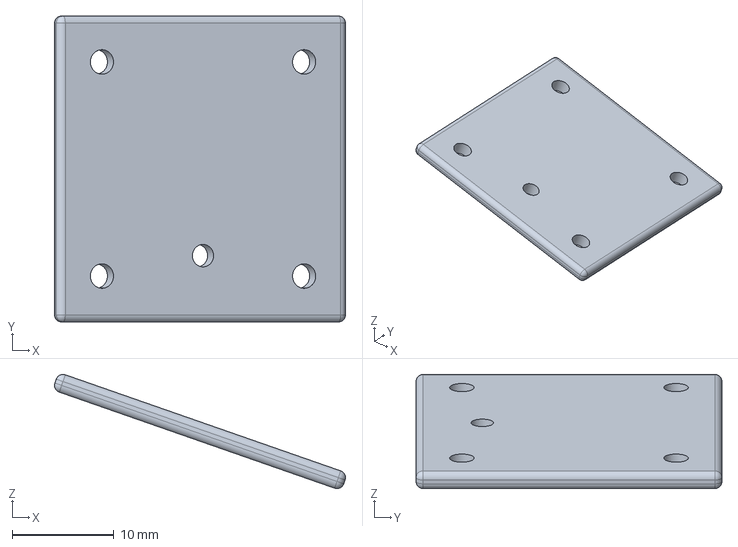
[picture p73: CAD file, 2026-10-21]
cad/manufacturing/rr_shin__rr_floating_sole.step
28.5 x 30.0 x 11.2 mm
