AlexWortega/Sweetybot2/cad/STEP/hoof.step

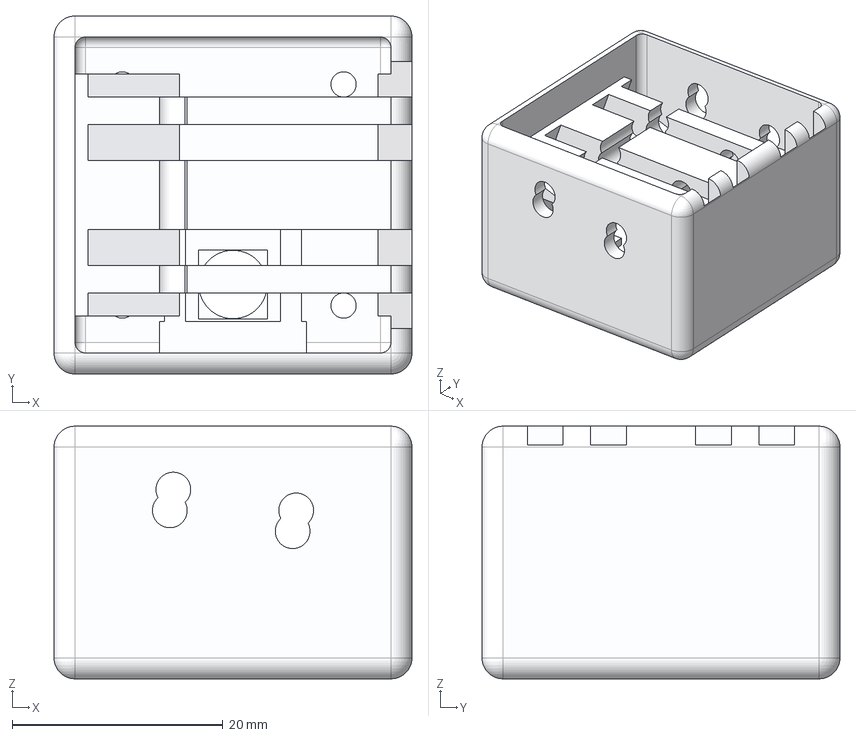
[picture p74: CAD file, 2026-10-18]
cad/STEP/hoof.step
34.0 x 34.0 x 24.0 mm
