AlexWortega/Sweetybot2/designs/sensor-v03/cad/STEP/servo_cradle.step

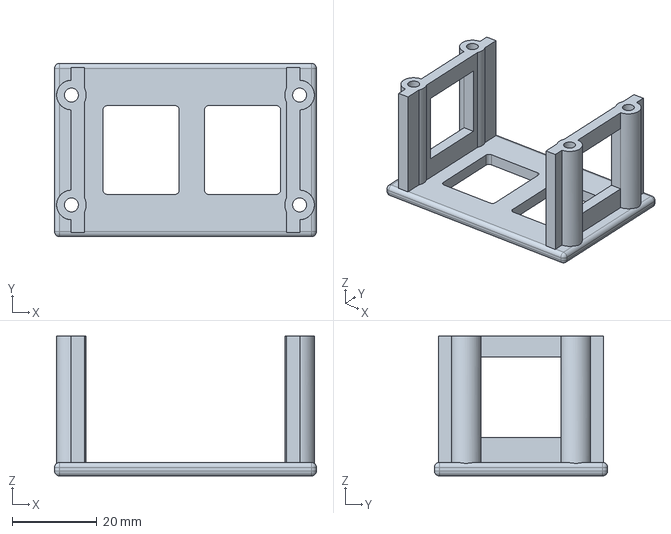
[picture p75: CAD file, 2026-10-17]
designs/sensor-v03/cad/STEP/servo_cradle.step
62.0 x 41.0 x 33.1 mm
