AlexWortega/Sweetybot2/cad/collision/convex/head__pony_head_shell__55.stl

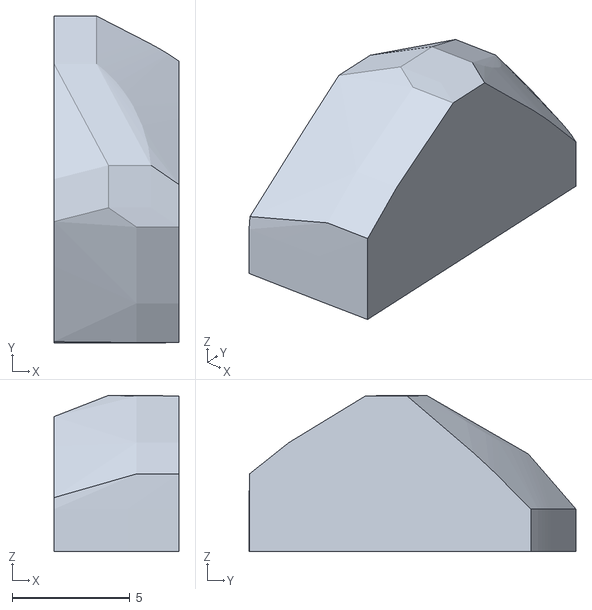
[picture p77: CAD file, 2026-10-18]
cad/collision/convex/head__pony_head_shell__55.stl
5.30 x 13.9 x 6.62
