AlexWortega/Sweetybot2/cad/collision/source/rl_shin__rl_knee_front_rotor_hub.step

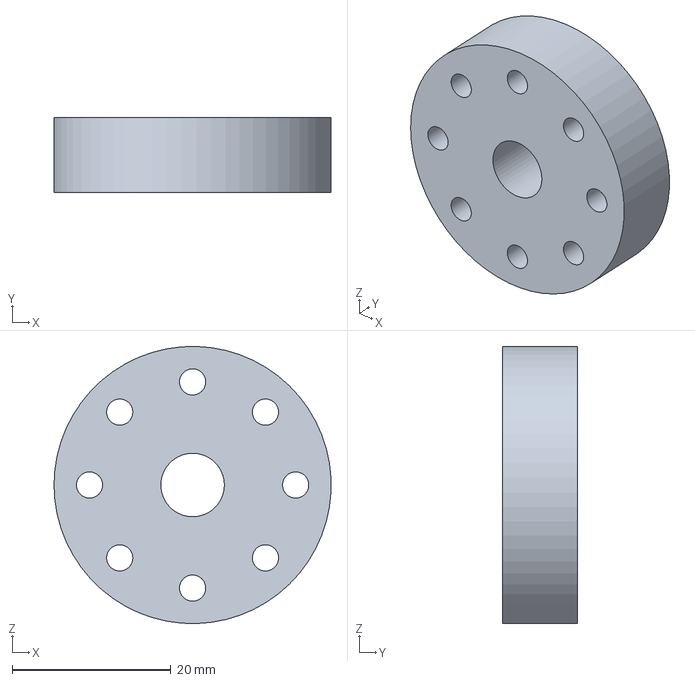
[picture p78: CAD file, 2026-10-21]
cad/collision/source/rl_shin__rl_knee_front_rotor_hub.step
34.9 x 9.50 x 34.9 mm
