AlexWortega/Sweetybot2/cad/manufacturing/fl_shin__fl_TPU_actuator.step

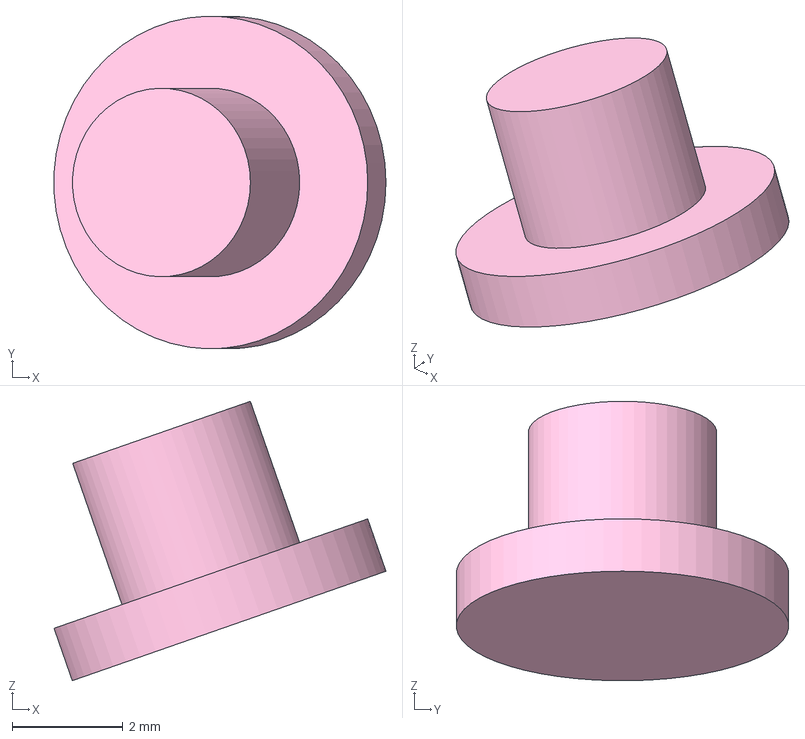
[picture p79: CAD file, 2026-10-21]
cad/manufacturing/fl_shin__fl_TPU_actuator.step
5.99 x 6.00 x 5.04 mm
