AlexWortega/Sweetybot2/cad/STEP/rear_hip_hub.step

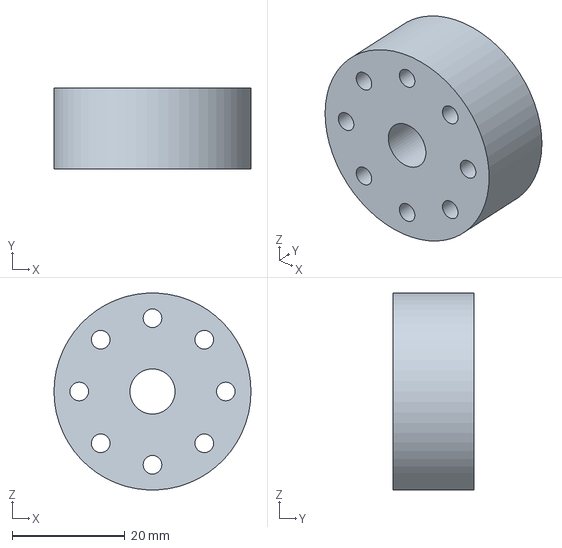
[picture p80: CAD file, 2026-10-18]
cad/STEP/rear_hip_hub.step
35.0 x 14.4 x 34.9 mm
