AlexWortega/Sweetybot2/designs/sensor-v03/cad/STEP/hoof_sole_plate.step

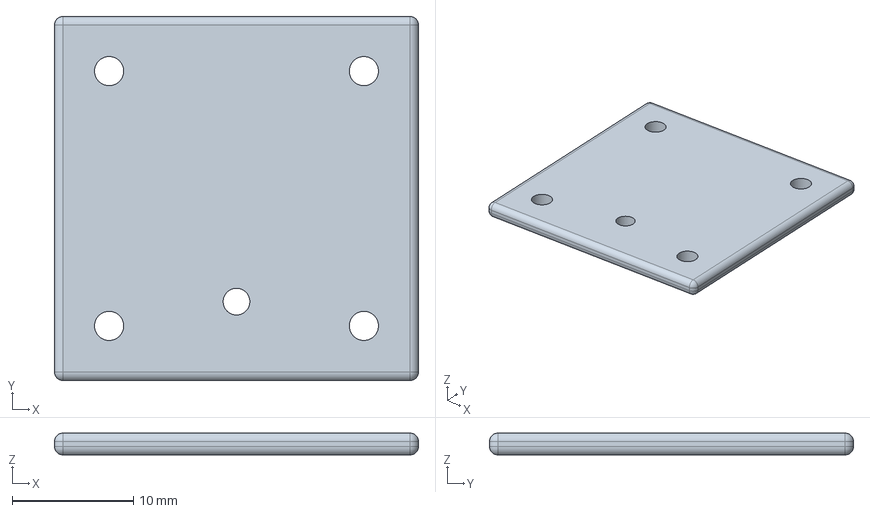
[picture p81: CAD file, 2026-10-17]
designs/sensor-v03/cad/STEP/hoof_sole_plate.step
30.0 x 30.0 x 1.80 mm
