AlexWortega/Sweetybot2/cad/collision/convex/torso__body_cowl__989.stl

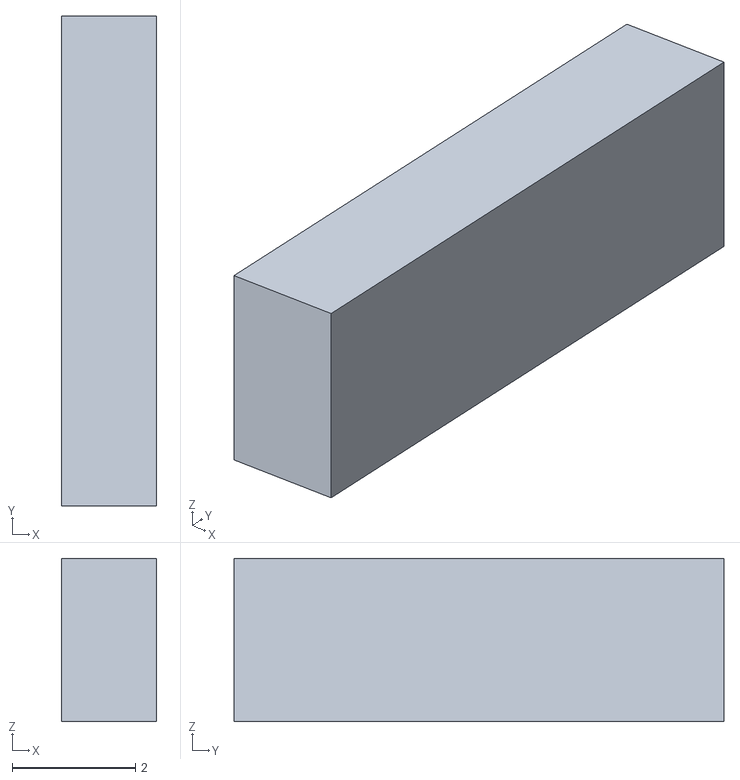
[picture p82: CAD file, 2026-10-18]
cad/collision/convex/torso__body_cowl__989.stl
1.53 x 7.94 x 2.65
