AlexWortega/Sweetybot2/cad/collision/source/rl_roll__rl_hip_passive_bearing.step

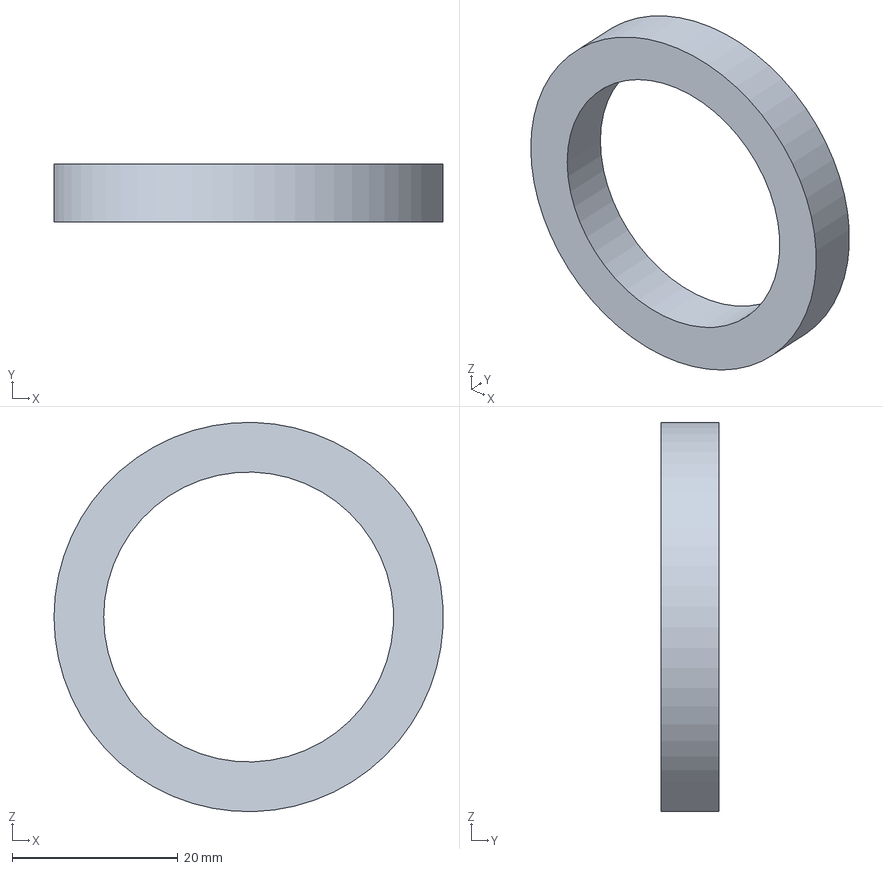
[picture p83: CAD file, 2026-10-21]
cad/collision/source/rl_roll__rl_hip_passive_bearing.step
47.0 x 7.00 x 47.0 mm
