AlexWortega/Sweetybot2/cad/STEP/deck.step

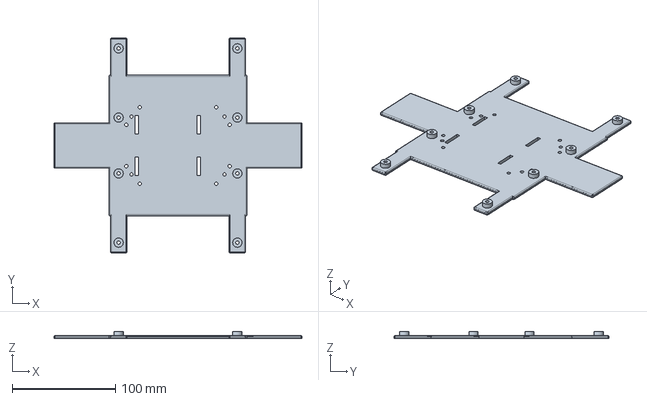
[picture p84: CAD file, 2026-10-18]
cad/STEP/deck.step
240.0 x 208.0 x 7.25 mm
