AlexWortega/Sweetybot2/cad/STL/links/head.stl

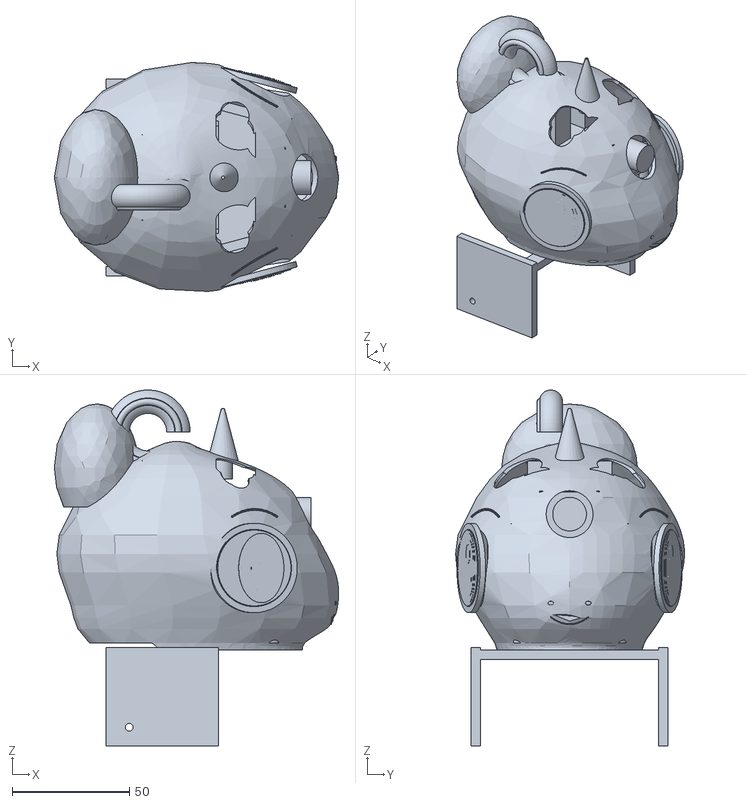
[picture p85: CAD file, 2026-10-18]
cad/STL/links/head.stl
121.4 x 97.7 x 152.0
