AlexWortega/Sweetybot2/designs/sensor-v03/cad/STEP/head_shell.step

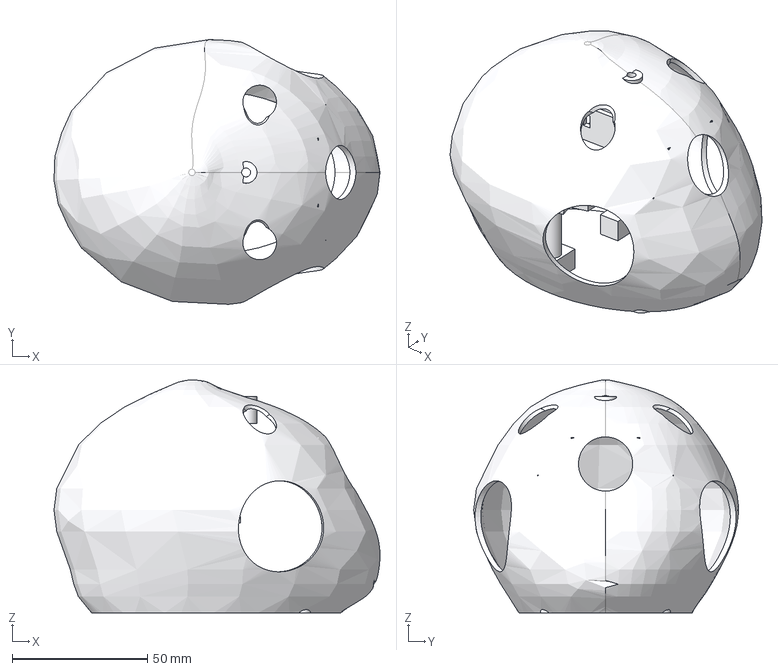
[picture p86: CAD file, 2026-10-17]
designs/sensor-v03/cad/STEP/head_shell.step
120.3 x 97.7 x 86.0 mm
