AlexWortega/Sweetybot2/cad/collision/convex/torso__body_cowl__805.stl

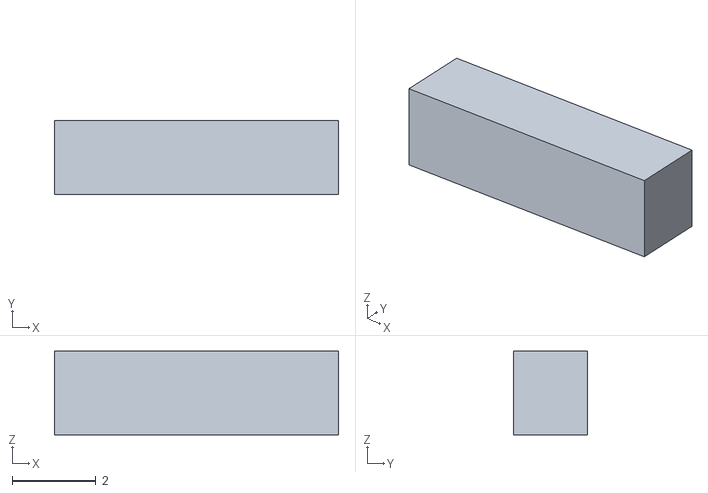
[picture p87: CAD file, 2026-10-18]
cad/collision/convex/torso__body_cowl__805.stl
6.80 x 1.76 x 2.00
