AlexWortega/Sweetybot2/cad/collision/source/head__camera_board.step

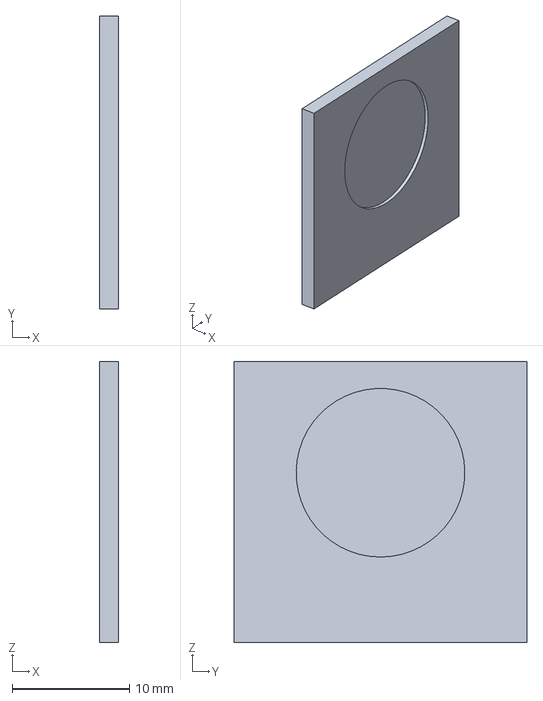
[picture p88: CAD file, 2026-10-21]
cad/collision/source/head__camera_board.step
1.60 x 25.0 x 24.0 mm
