AlexWortega/Sweetybot2/cad/STEP/shin_rear_plate.step

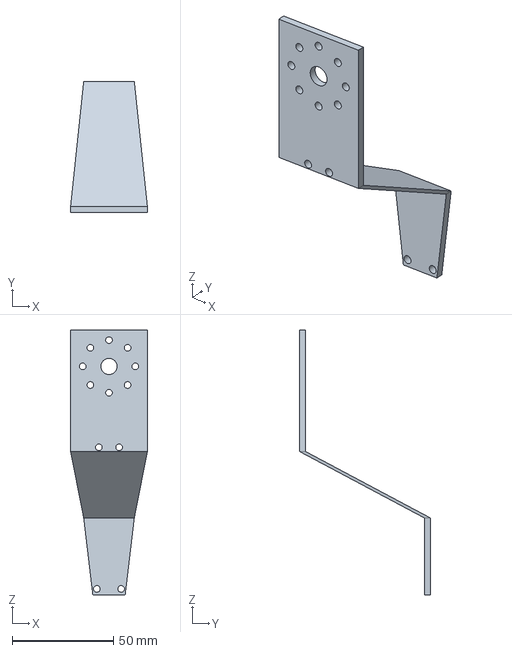
[picture p89: CAD file, 2026-10-18]
cad/STEP/shin_rear_plate.step
38.0 x 65.0 x 131.0 mm
