AlexWortega/Sweetybot2/designs/sensor-v03/cad/STEP/depth_pod.step

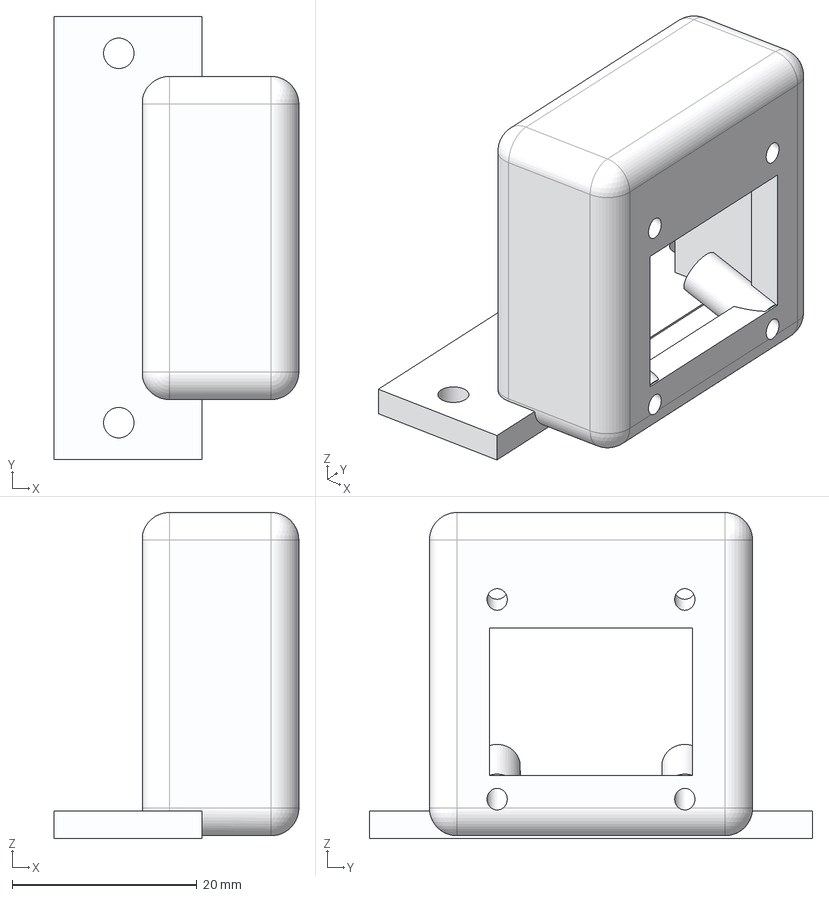
[picture p90: CAD file, 2026-10-17]
designs/sensor-v03/cad/STEP/depth_pod.step
26.5 x 48.0 x 35.3 mm
