AlexWortega/Sweetybot2/cad/collision/convex/torso__body_cowl__914.stl

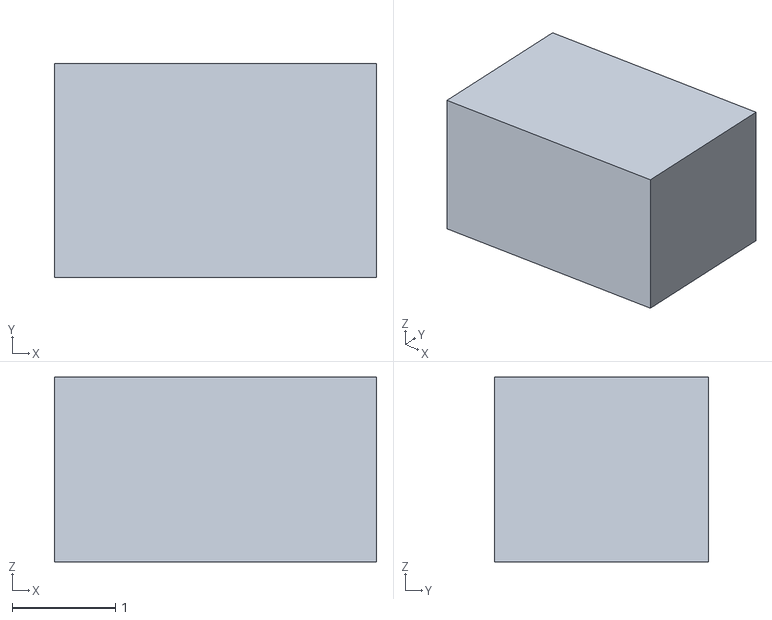
[picture p91: CAD file, 2026-10-18]
cad/collision/convex/torso__body_cowl__914.stl
3.12 x 2.07 x 1.79
