AlexWortega/Sweetybot2/cad/collision/source/fl_shin__fl_knee_M3_heads_-70.0.step

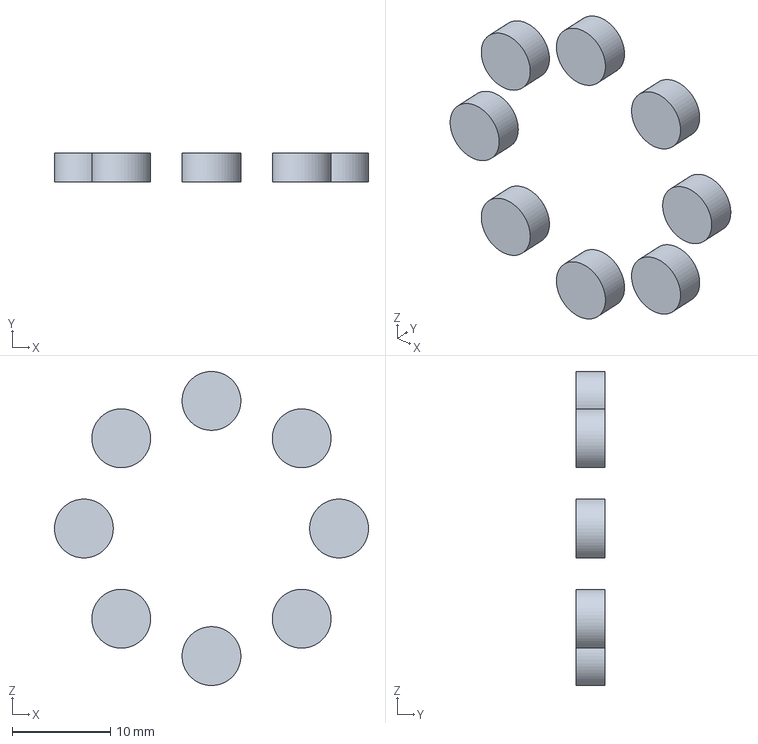
[picture p92: CAD file, 2026-10-21]
cad/collision/source/fl_shin__fl_knee_M3_heads_-70.0.step
32.0 x 3.00 x 32.0 mm
