AlexWortega/Sweetybot2/cad/manufacturing/torso__fr_roll_cradle.step

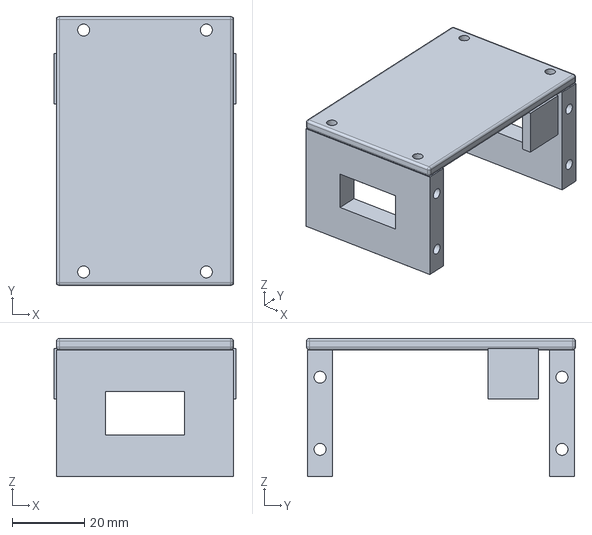
[picture p93: CAD file, 2026-10-21]
cad/manufacturing/torso__fr_roll_cradle.step
50.4 x 74.5 x 38.3 mm
