AlexWortega/Sweetybot2/cad/STEP/rotor_spacer.step

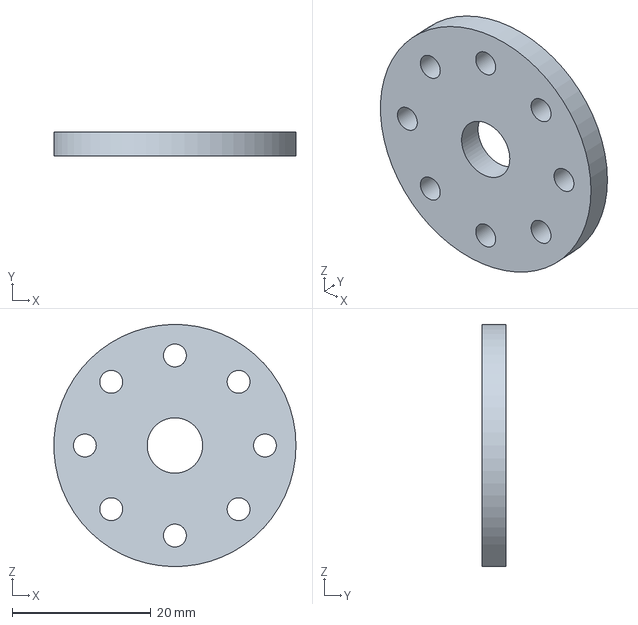
[picture p94: CAD file, 2026-10-18]
cad/STEP/rotor_spacer.step
34.9 x 3.50 x 34.9 mm
