AlexWortega/Sweetybot2/cad/STL/links/neck_yaw.stl

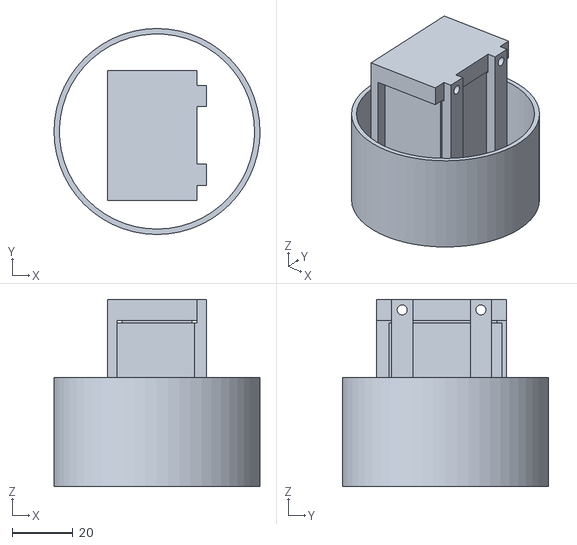
[picture p95: CAD file, 2026-10-18]
cad/STL/links/neck_yaw.stl
68.0 x 68.0 x 61.9
