AlexWortega/Sweetybot2/designs/sensor-v03/cad/STEP/rail.step

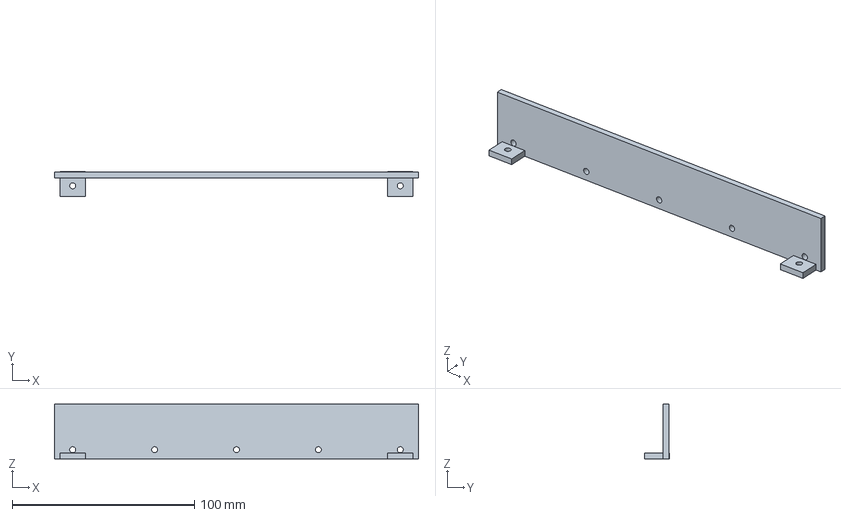
[picture p96: CAD file, 2026-10-17]
designs/sensor-v03/cad/STEP/rail.step
200.0 x 14.0 x 30.0 mm
