AlexWortega/Sweetybot2/cad/collision/convex/rr_roll__rr_roll_yoke__2.stl

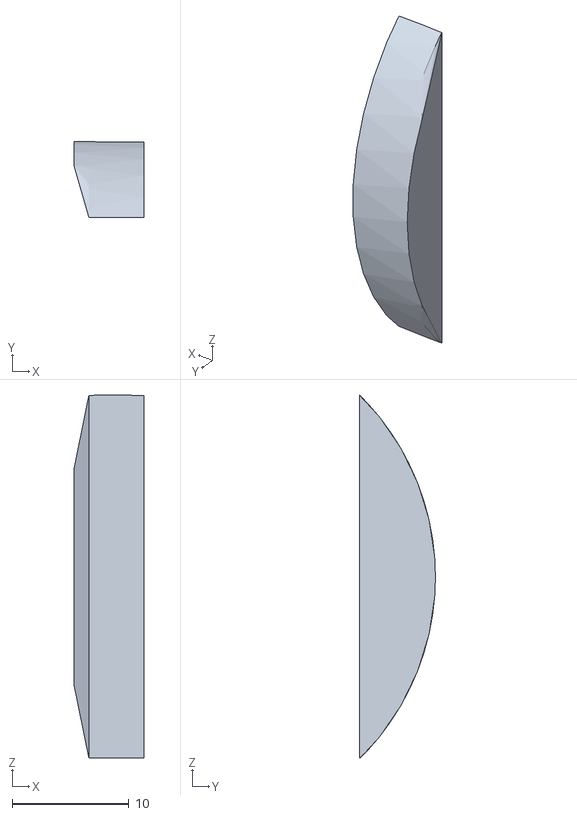
[picture p97: CAD file, 2026-10-18]
cad/collision/convex/rr_roll__rr_roll_yoke__2.stl
6.00 x 6.51 x 31.1
