AlexWortega/Sweetybot2/cad/collision/source/fl_shin__fl_knee_cross_spacer.step

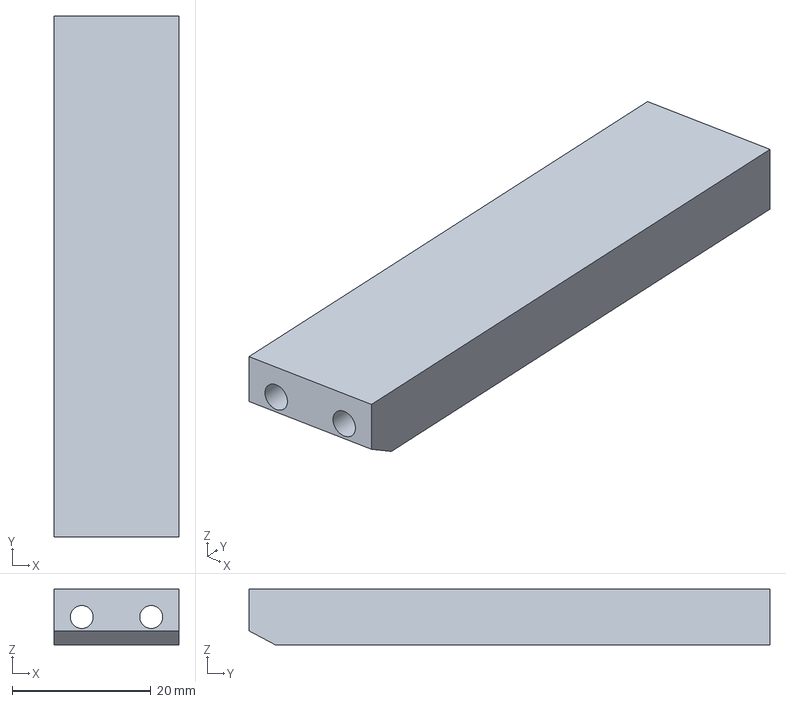
[picture p98: CAD file, 2026-10-21]
cad/collision/source/fl_shin__fl_knee_cross_spacer.step
18.0 x 75.0 x 8.00 mm
