AlexWortega/Sweetybot2/cad/STL/links/fr_thigh.stl

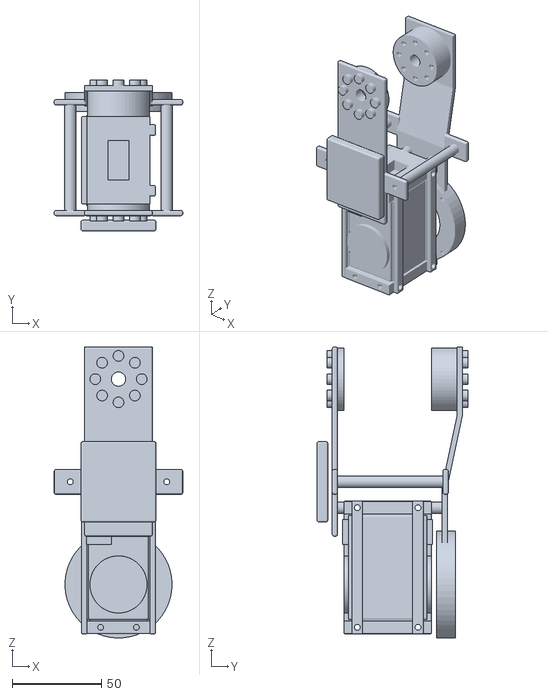
[picture p99: CAD file, 2026-10-18]
cad/STL/links/fr_thigh.stl
72.0 x 84.5 x 163.0
