AlexWortega/Sweetybot2/designs/sensor-v03/cad/STEP/shin_fairing.step

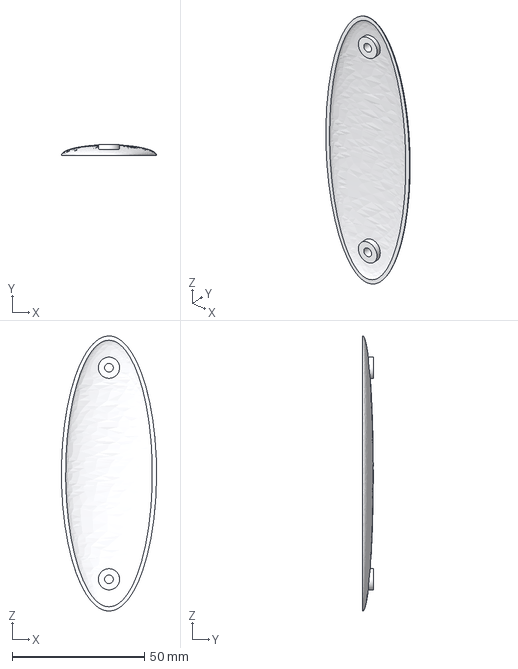
[picture p100: CAD file, 2026-10-17]
designs/sensor-v03/cad/STEP/shin_fairing.step
36.0 x 4.00 x 104.0 mm
