AlexWortega/Sweetybot2/cad/collision/convex/rl_thigh__rl_knee_bearing_retainer__1.stl

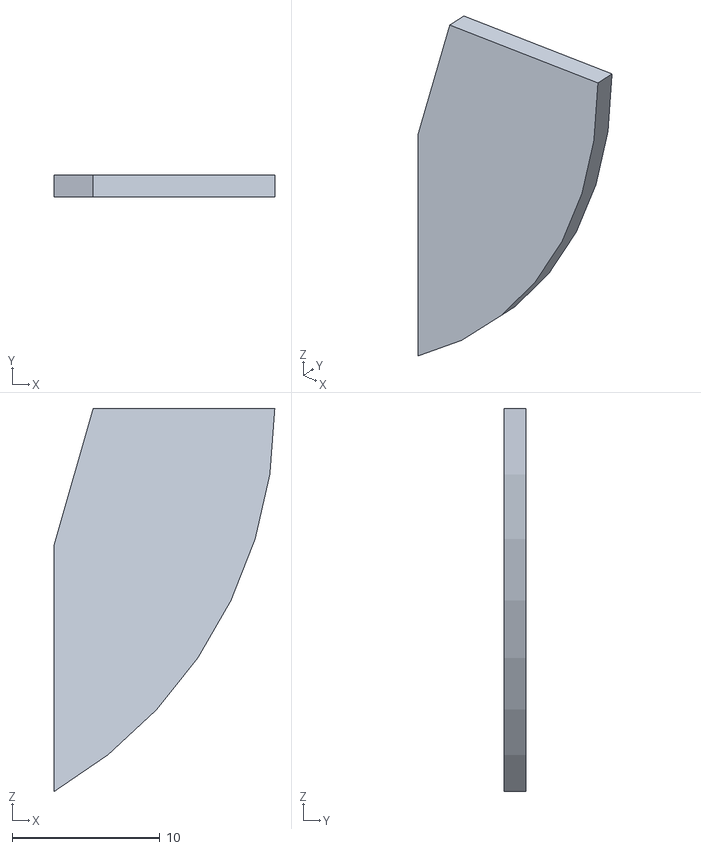
[picture p101: CAD file, 2026-10-18]
cad/collision/convex/rl_thigh__rl_knee_bearing_retainer__1.stl
14.9 x 1.50 x 25.9
