AlexWortega/Sweetybot2/cad/collision/source/rl_shin__rl_switch.step

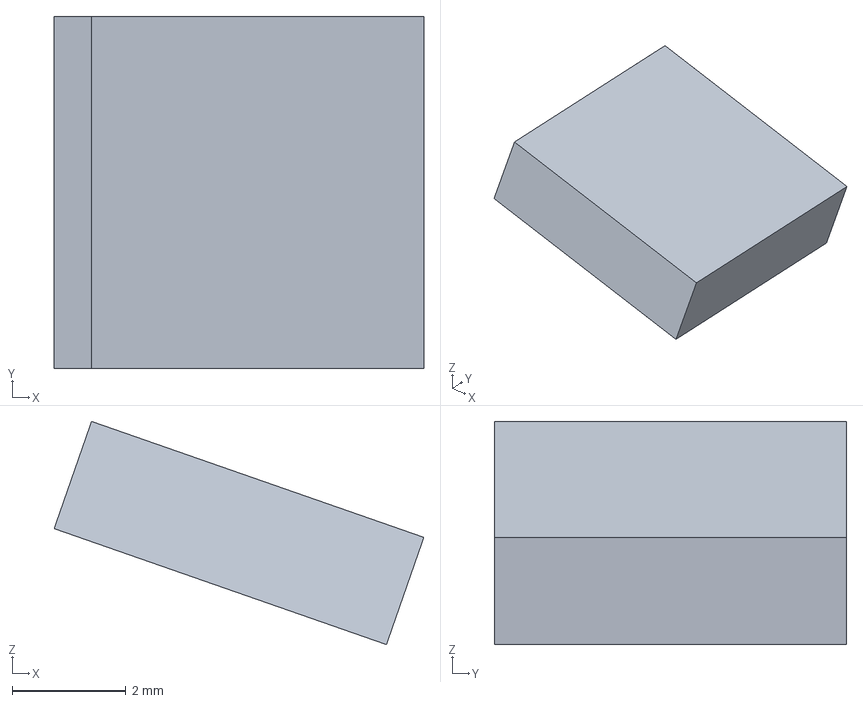
[picture p102: CAD file, 2026-10-21]
cad/collision/source/rl_shin__rl_switch.step
6.51 x 6.20 x 3.93 mm
