AlexWortega/Sweetybot2/cad/STL/links/torso.stl

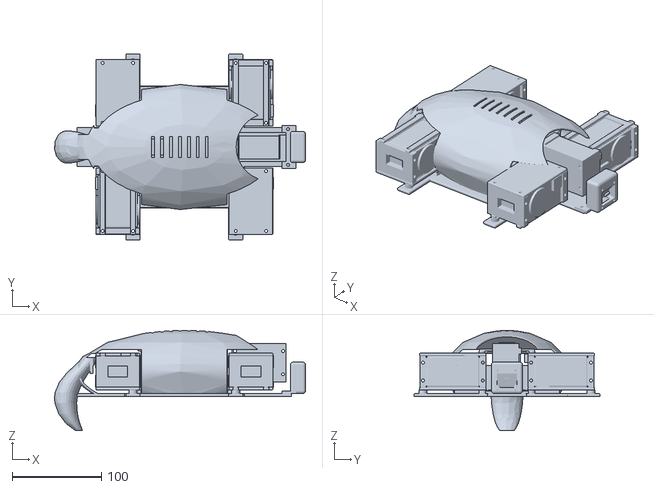
[picture p103: CAD file, 2026-10-18]
cad/STL/links/torso.stl
280.8 x 208.0 x 112.0
