AlexWortega/Sweetybot2/designs/sensor-v03/cad/STEP/horn.step

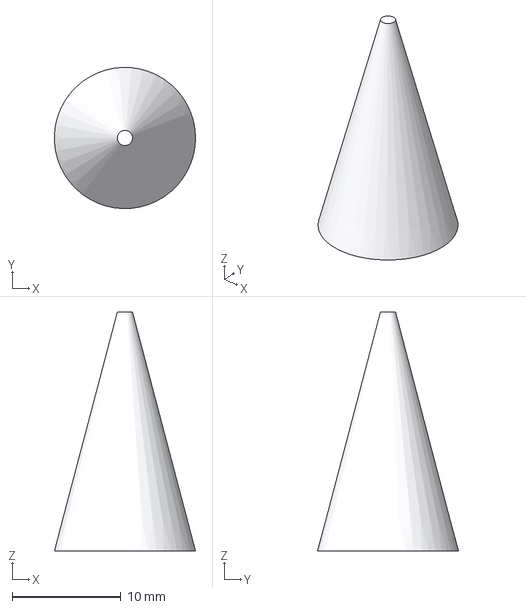
[picture p104: CAD file, 2026-10-17]
designs/sensor-v03/cad/STEP/horn.step
13.0 x 13.0 x 22.0 mm
