AlexWortega/Sweetybot2/cad/collision/convex/head__pony_head_shell__2.stl

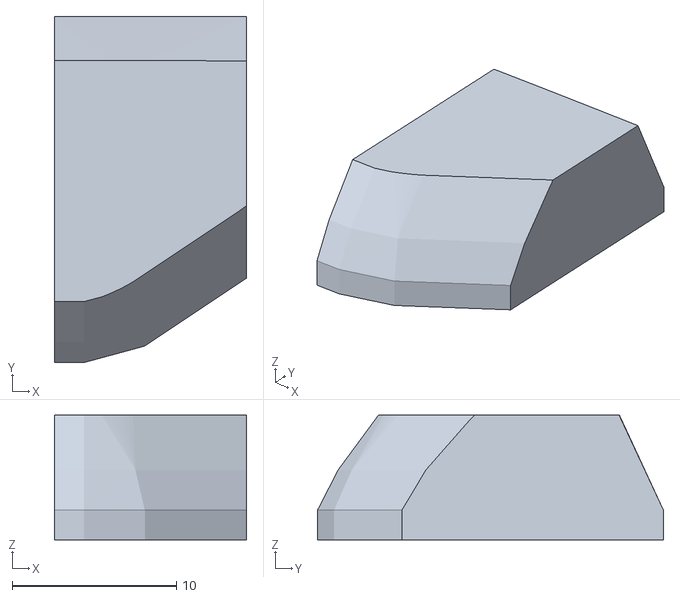
[picture p105: CAD file, 2026-10-18]
cad/collision/convex/head__pony_head_shell__2.stl
11.7 x 21.0 x 7.58
