AlexWortega/Sweetybot2/cad/manufacturing/rr_shin__rr_shin_cheek_front.step

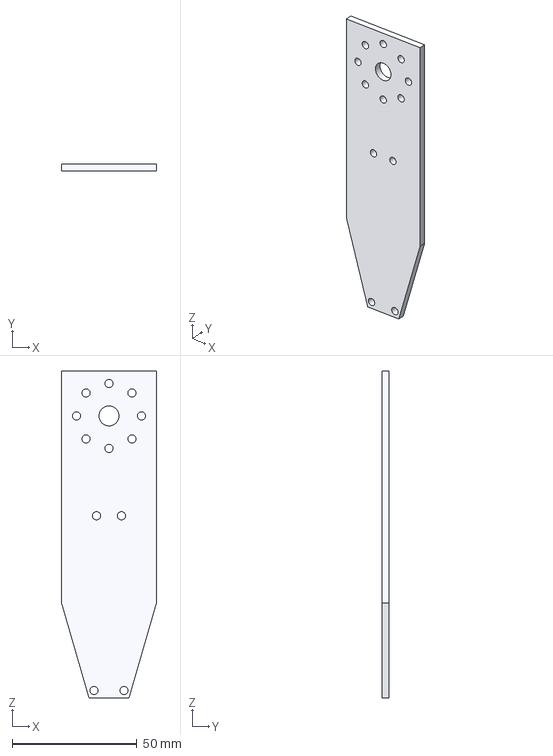
[picture p106: CAD file, 2026-10-21]
cad/manufacturing/rr_shin__rr_shin_cheek_front.step
38.0 x 3.00 x 131.0 mm
