AlexWortega/Sweetybot2/cad/STEP/roll_yoke.step

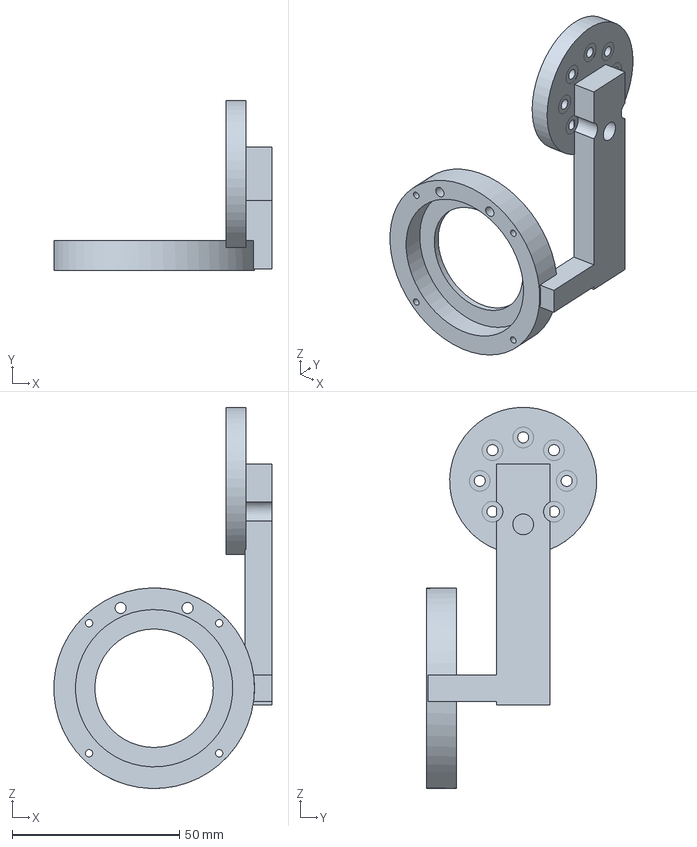
[picture p107: CAD file, 2026-10-18]
cad/STEP/roll_yoke.step
65.2 x 51.0 x 113.9 mm
