AlexWortega/Sweetybot2/designs/sensor-v03/cad/STEP/roll_yoke.step

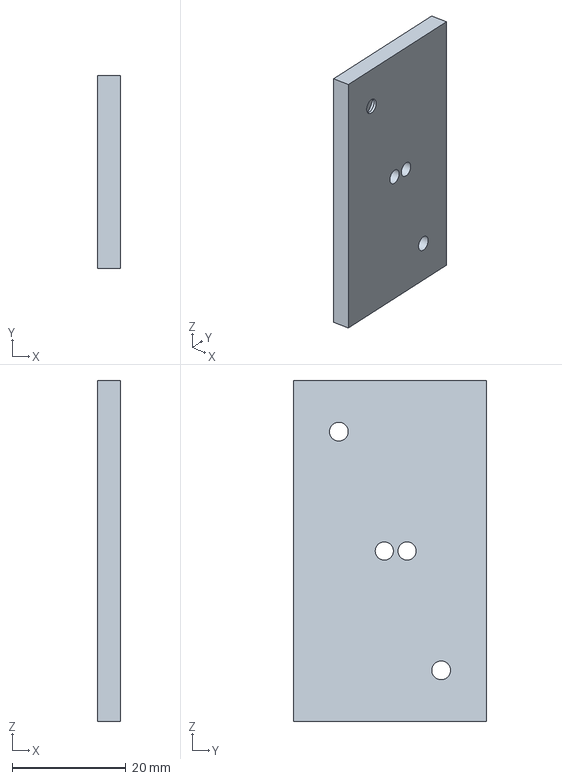
[picture p108: CAD file, 2026-10-17]
designs/sensor-v03/cad/STEP/roll_yoke.step
4.00 x 34.0 x 60.0 mm
