AlexWortega/Sweetybot2/cad/collision/convex/head__pony_head_shell__297.stl

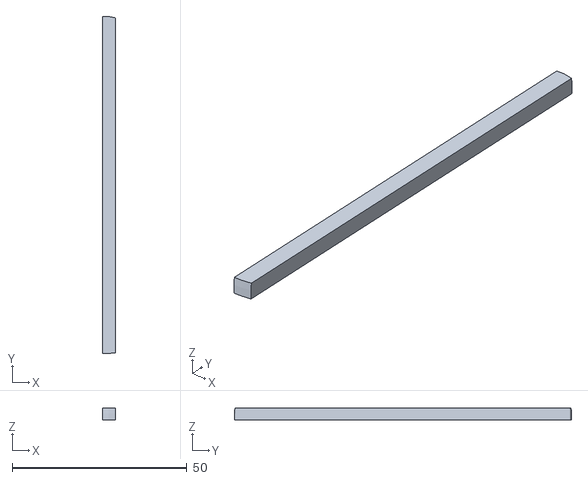
[picture p109: CAD file, 2026-10-18]
cad/collision/convex/head__pony_head_shell__297.stl
3.80 x 96.5 x 3.30
