AlexWortega/Sweetybot2/cad/STEP/sensor_tray.step

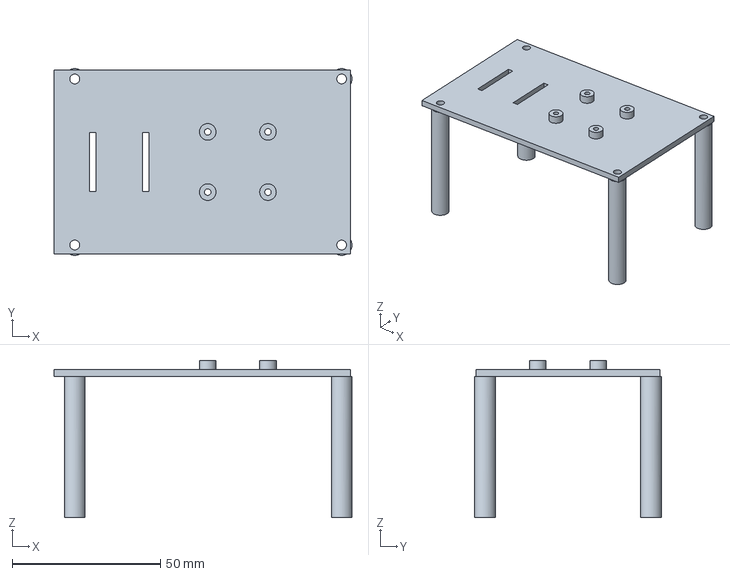
[picture p110: CAD file, 2026-10-18]
cad/STEP/sensor_tray.step
100.5 x 63.0 x 53.0 mm
