AlexWortega/Sweetybot2/designs/sensor-v03/cad/STEP/head_hatch.step

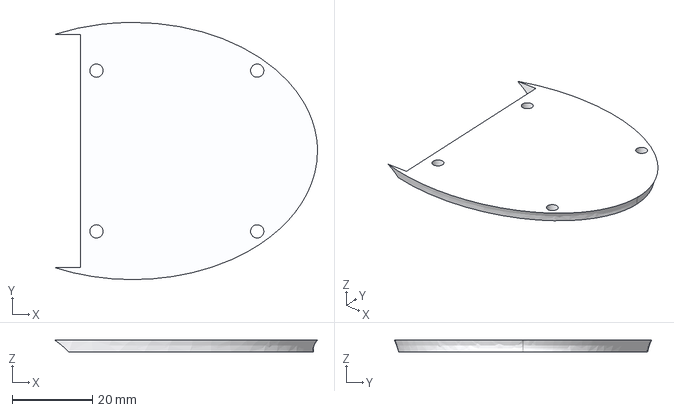
[picture p111: CAD file, 2026-10-17]
designs/sensor-v03/cad/STEP/head_hatch.step
65.4 x 64.0 x 3.00 mm
