AlexWortega/Sweetybot2/cad/collision/convex/head__pony_head_shell__495.stl

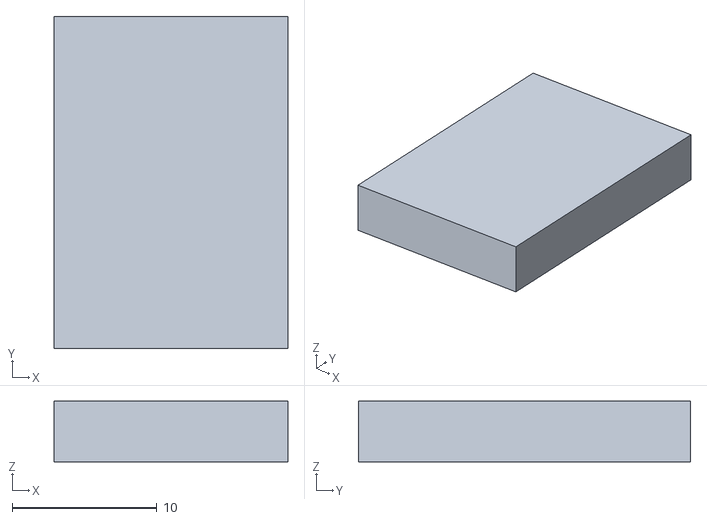
[picture p112: CAD file, 2026-10-18]
cad/collision/convex/head__pony_head_shell__495.stl
16.2 x 23.0 x 4.20
