AlexWortega/Sweetybot2/cad/STEP/axle_adapter.step

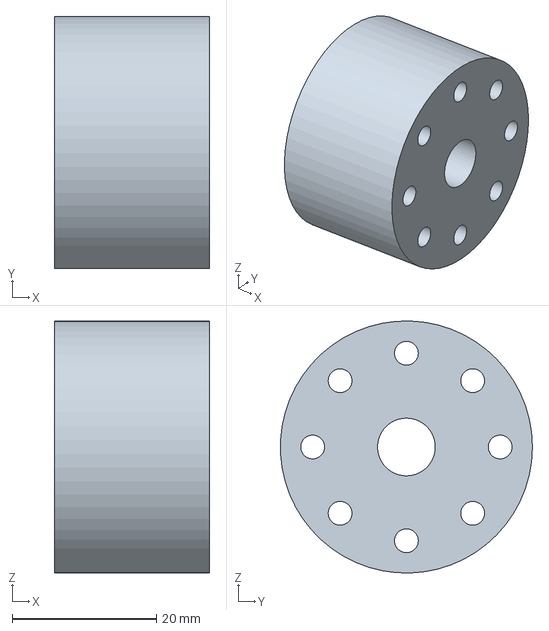
[picture p113: CAD file, 2026-10-18]
cad/STEP/axle_adapter.step
21.5 x 34.9 x 34.9 mm
