AlexWortega/Sweetybot2/cad/collision/convex/fr_shin__fr_shin_cheek_rear__0.stl

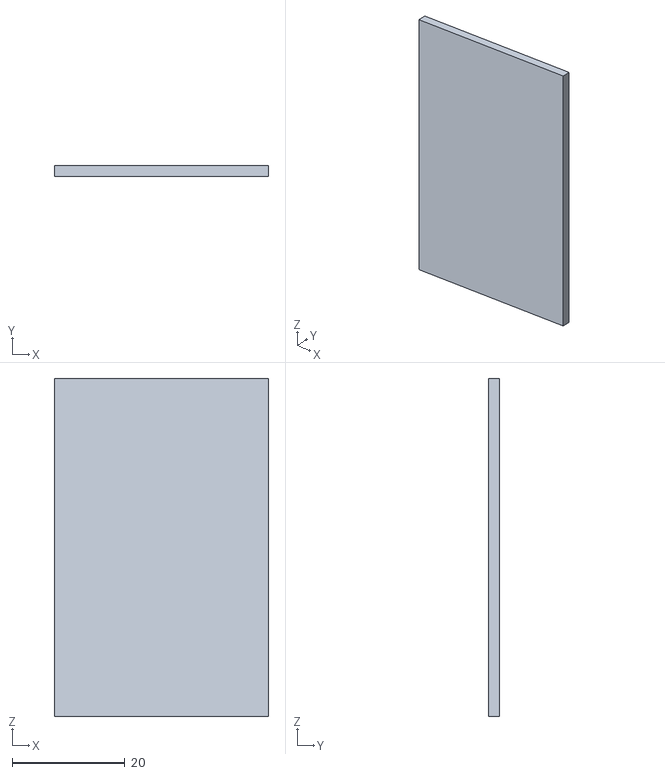
[picture p114: CAD file, 2026-10-18]
cad/collision/convex/fr_shin__fr_shin_cheek_rear__0.stl
38.0 x 1.95 x 59.9
