AlexWortega/Sweetybot2/cad/STEP/mane_stripe.step

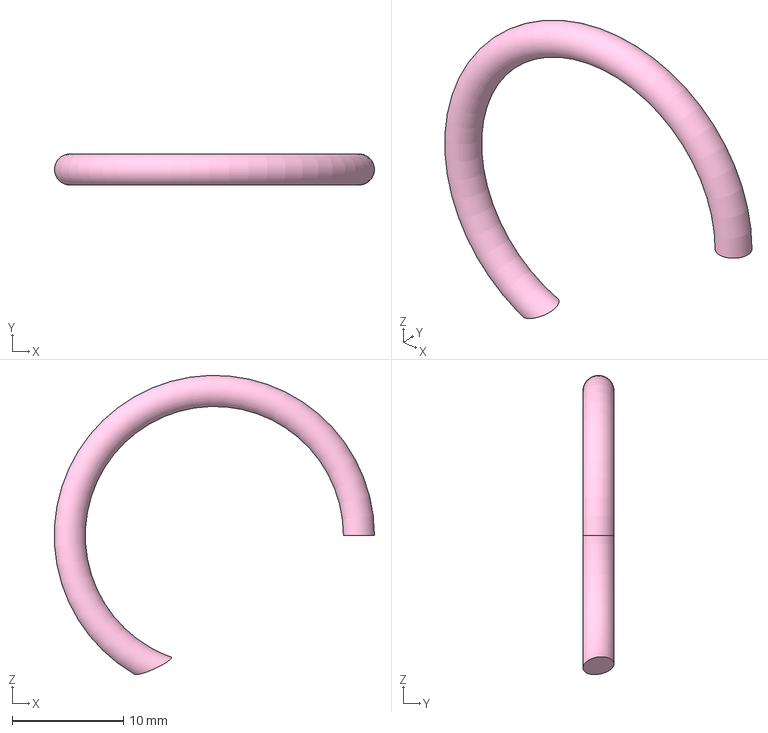
[picture p115: CAD file, 2026-10-18]
cad/STEP/mane_stripe.step
28.8 x 2.80 x 26.9 mm
