AlexWortega/Sweetybot2/designs/sensor-v03/cad/STEP/axle_adapter.step

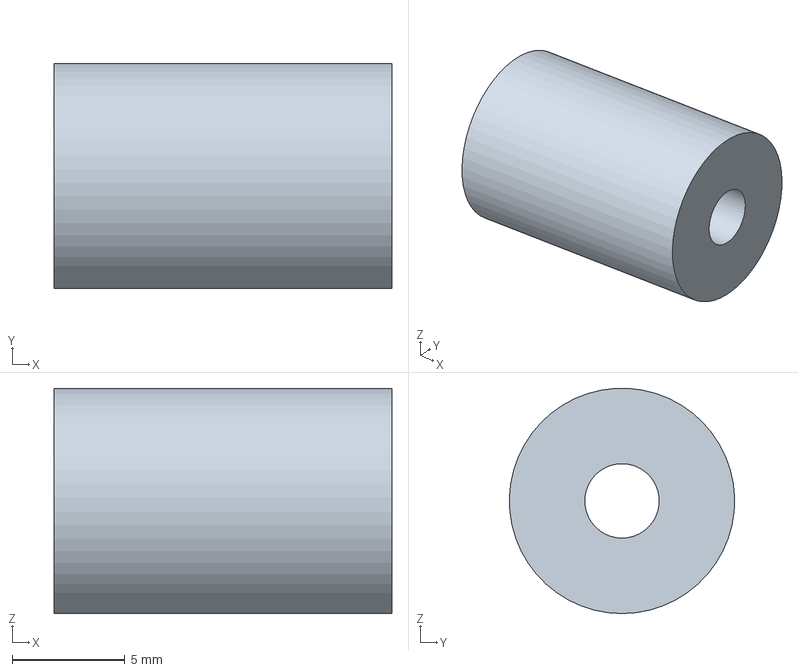
[picture p116: CAD file, 2026-10-17]
designs/sensor-v03/cad/STEP/axle_adapter.step
15.0 x 10.00 x 9.99 mm
