AlexWortega/Sweetybot2/cad/collision/convex/torso__fr_roll_cradle__8.stl

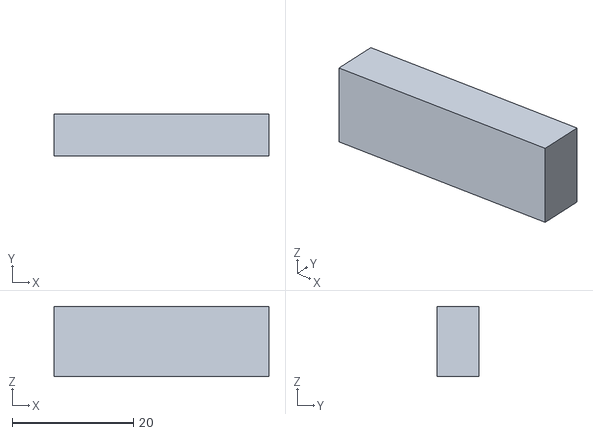
[picture p117: CAD file, 2026-10-18]
cad/collision/convex/torso__fr_roll_cradle__8.stl
35.4 x 7.00 x 11.6
