AlexWortega/Sweetybot2/designs/sensor-v03/cad/STEP/hoof.step

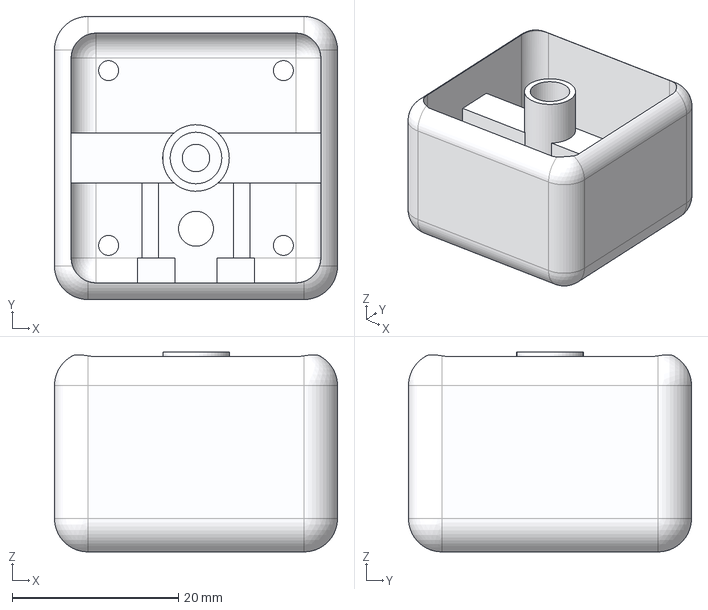
[picture p118: CAD file, 2026-10-17]
designs/sensor-v03/cad/STEP/hoof.step
34.0 x 34.0 x 24.0 mm
