AlexWortega/Sweetybot2/cad/collision/convex/rr_shin__rr_shin_fairing__2.stl

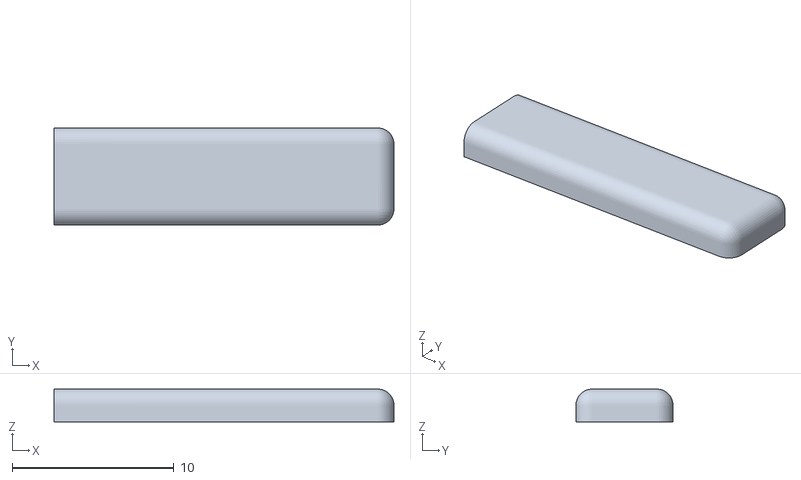
[picture p119: CAD file, 2026-10-18]
cad/collision/convex/rr_shin__rr_shin_fairing__2.stl
21.0 x 6.00 x 2.03
