AlexWortega/Sweetybot2/cad/collision/source/ear_left__ear_inner_1.step

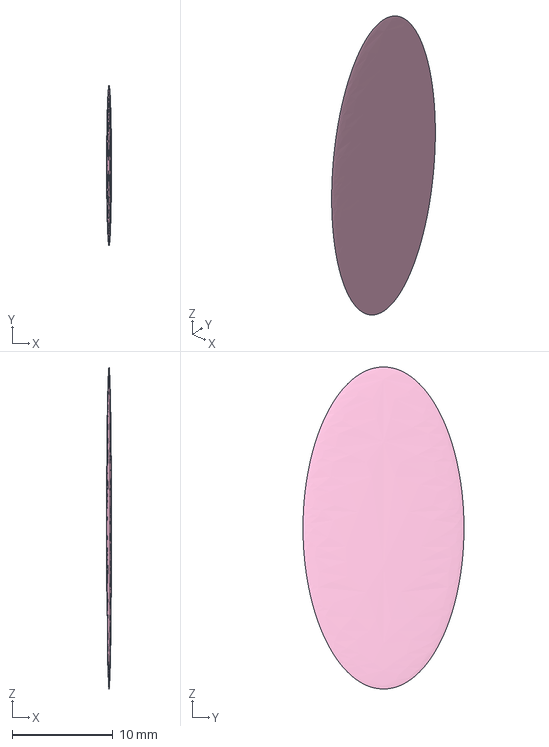
[picture p120: CAD file, 2026-10-21]
cad/collision/source/ear_left__ear_inner_1.step
0.493 x 16.0 x 32.0 mm
