AlexWortega/Sweetybot2/cad/STEP/thigh_fairing.step

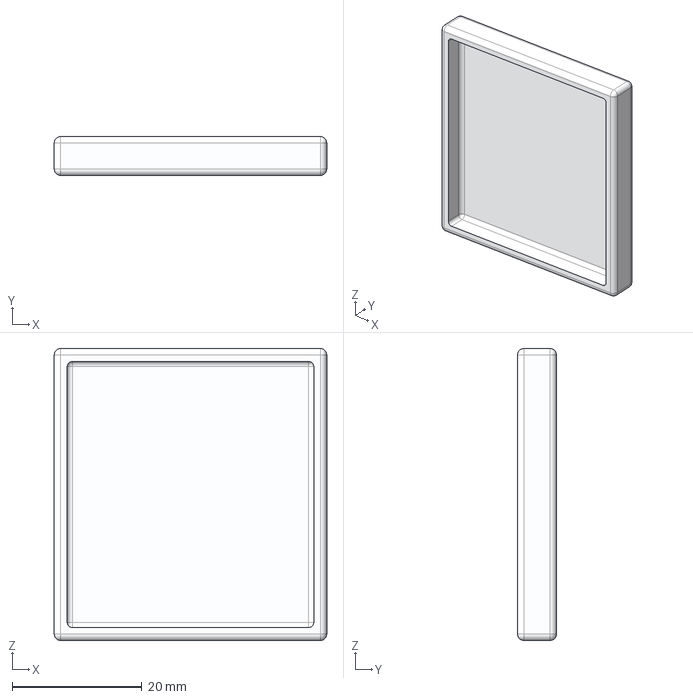
[picture p121: CAD file, 2026-10-18]
cad/STEP/thigh_fairing.step
42.0 x 6.00 x 45.0 mm
