AlexWortega/Sweetybot2/designs/sensor-v03/cad/STEP/ear.step

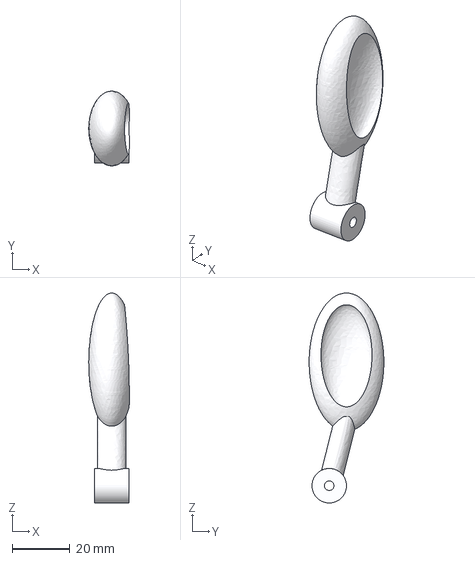
[picture p122: CAD file, 2026-10-17]
designs/sensor-v03/cad/STEP/ear.step
14.1 x 26.0 x 73.0 mm
