AlexWortega/Sweetybot2/cad/collision/convex/torso__body_cowl__630.stl

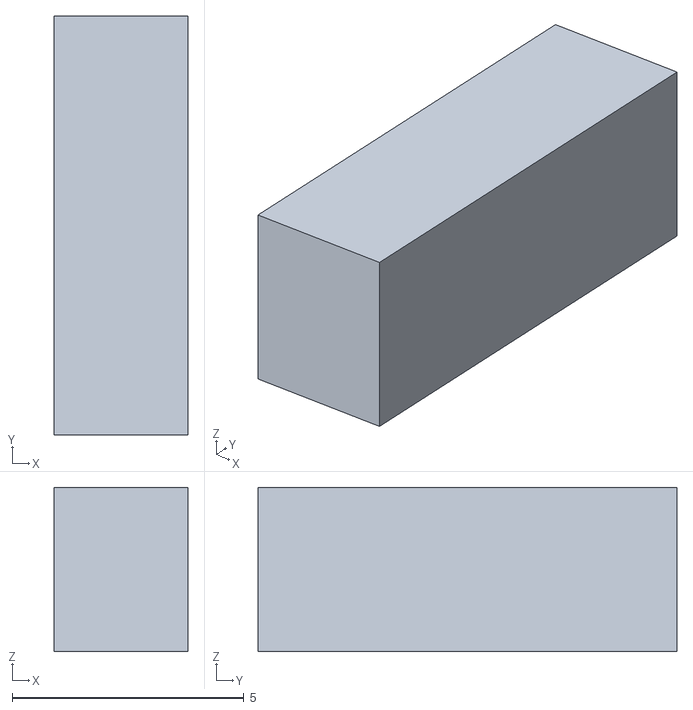
[picture p123: CAD file, 2026-10-18]
cad/collision/convex/torso__body_cowl__630.stl
2.88 x 9.03 x 3.54
