AlexWortega/Sweetybot2/cad/collision/source/fl_roll__fl_pitch_mount_spacer_-10.step

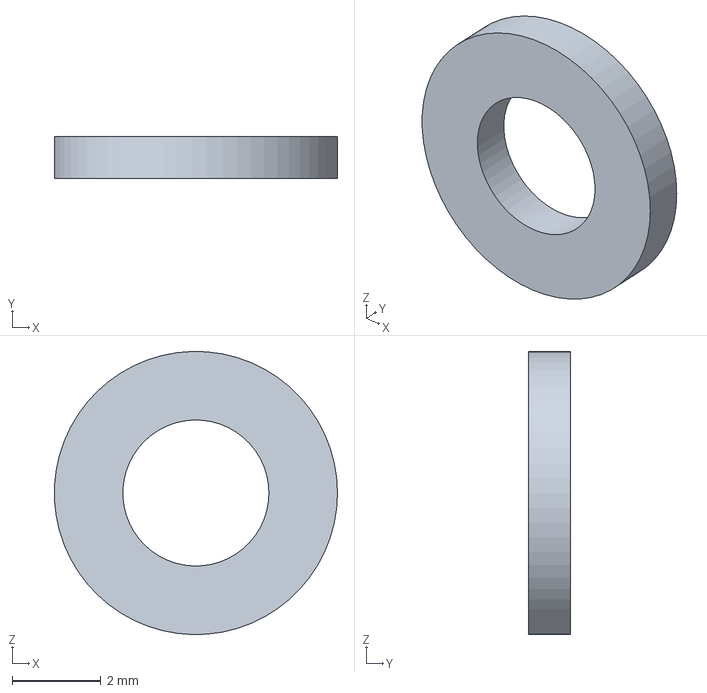
[picture p124: CAD file, 2026-10-21]
cad/collision/source/fl_roll__fl_pitch_mount_spacer_-10.step
6.40 x 0.95 x 6.40 mm
