AlexWortega/Sweetybot2/cad/STEP/bearing_retainer.step

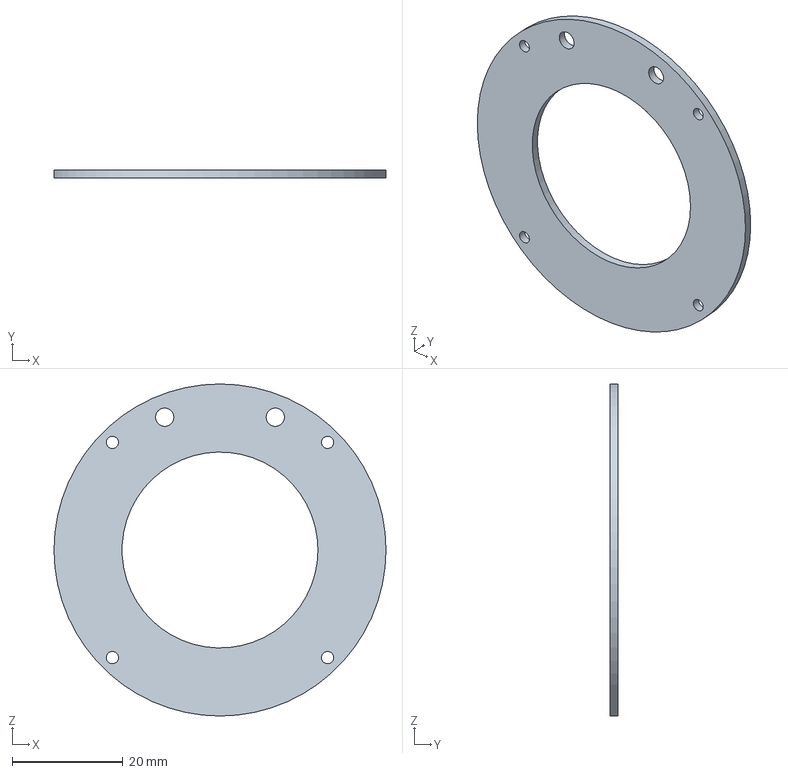
[picture p125: CAD file, 2026-10-18]
cad/STEP/bearing_retainer.step
60.0 x 1.50 x 60.0 mm
