AlexWortega/Sweetybot2/designs/sensor-v03/cad/STEP/hoof_tpu_pad.step

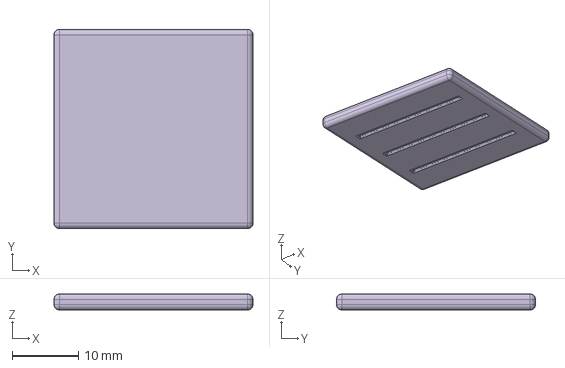
[picture p126: CAD file, 2026-10-17]
designs/sensor-v03/cad/STEP/hoof_tpu_pad.step
30.0 x 30.0 x 2.40 mm
