AlexWortega/Sweetybot2/cad/collision/convex/fr_thigh__fr_knee_servo__0.stl

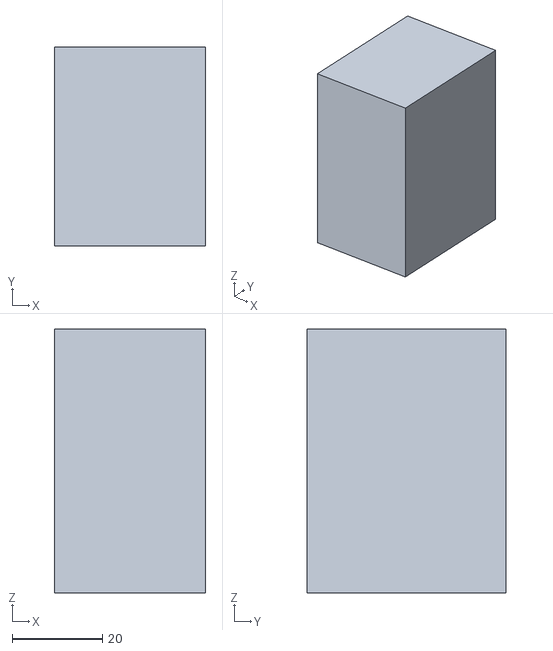
[picture p127: CAD file, 2026-10-18]
cad/collision/convex/fr_thigh__fr_knee_servo__0.stl
33.5 x 44.0 x 58.5
