AlexWortega/Sweetybot2/cad/STEP/body_shell.step

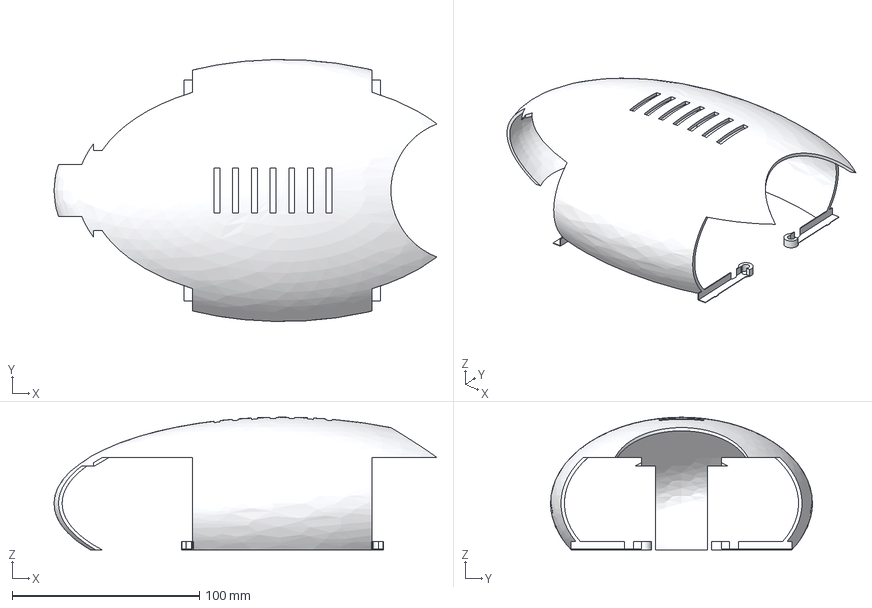
[picture p128: CAD file, 2026-10-18]
cad/STEP/body_shell.step
204.6 x 139.9 x 70.8 mm
