AlexWortega/Sweetybot2/cad/manufacturing/head__head_support_yoke.step

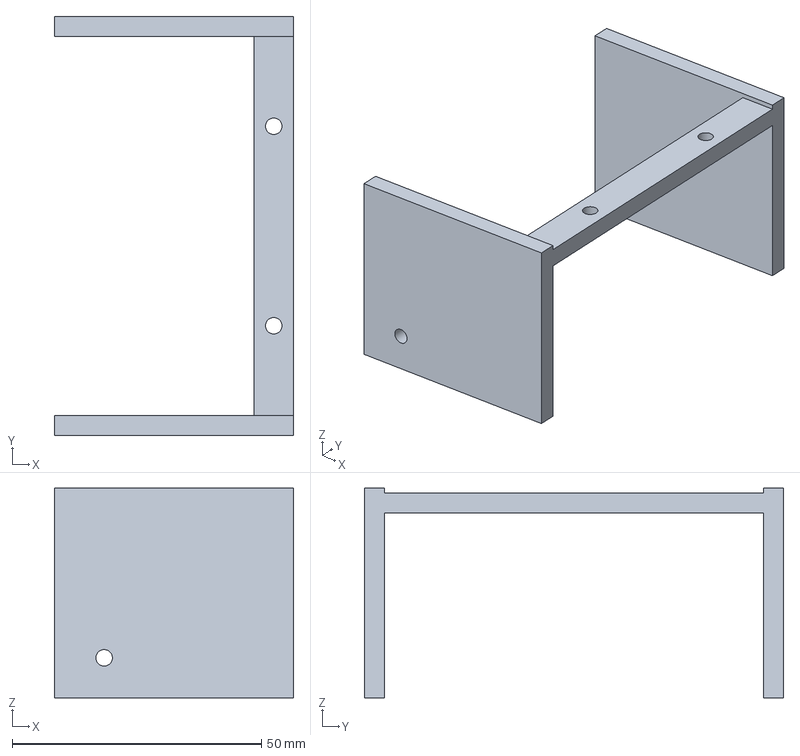
[picture p129: CAD file, 2026-10-21]
cad/manufacturing/head__head_support_yoke.step
48.0 x 84.0 x 42.0 mm
