AlexWortega/Sweetybot2/cad/collision/convex/fl_thigh__fl_knee_passive_bearing__3.stl

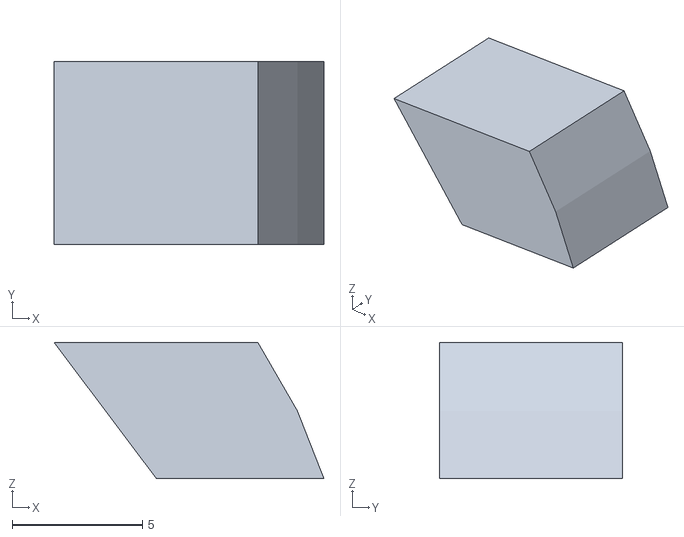
[picture p130: CAD file, 2026-10-18]
cad/collision/convex/fl_thigh__fl_knee_passive_bearing__3.stl
10.4 x 7.00 x 5.23
