AlexWortega/Sweetybot2/cad/STEP/neck_collar.step

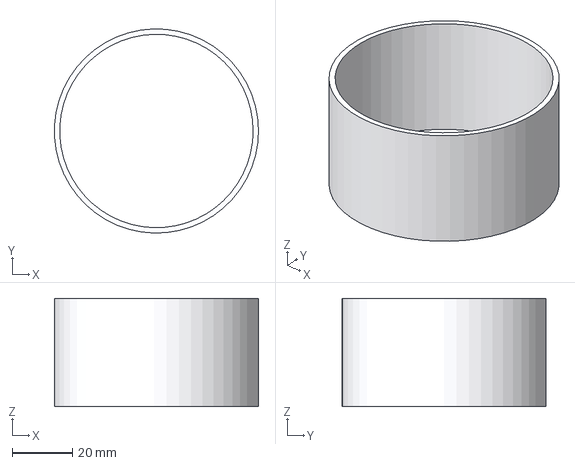
[picture p131: CAD file, 2026-10-18]
cad/STEP/neck_collar.step
67.9 x 68.0 x 36.0 mm
