AlexWortega/Sweetybot2/cad/collision/convex/rr_roll__rr_hip_bearing_retainer__6.stl

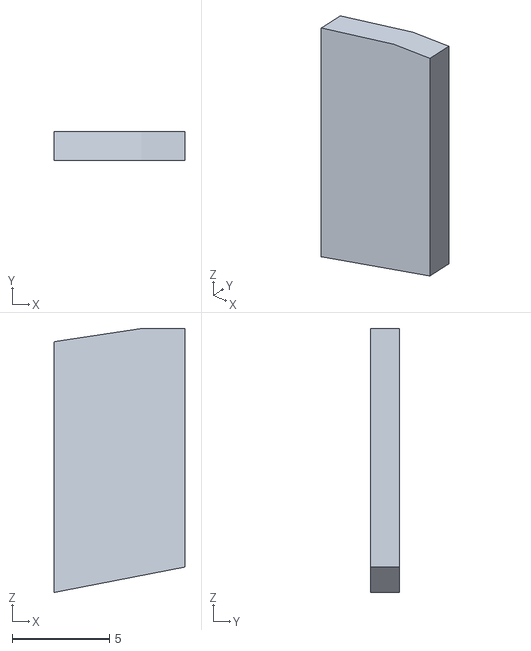
[picture p132: CAD file, 2026-10-18]
cad/collision/convex/rr_roll__rr_hip_bearing_retainer__6.stl
6.73 x 1.50 x 13.6
