AlexWortega/Sweetybot2/cad/collision/source/rr_shin__rr_switch_PCB.step

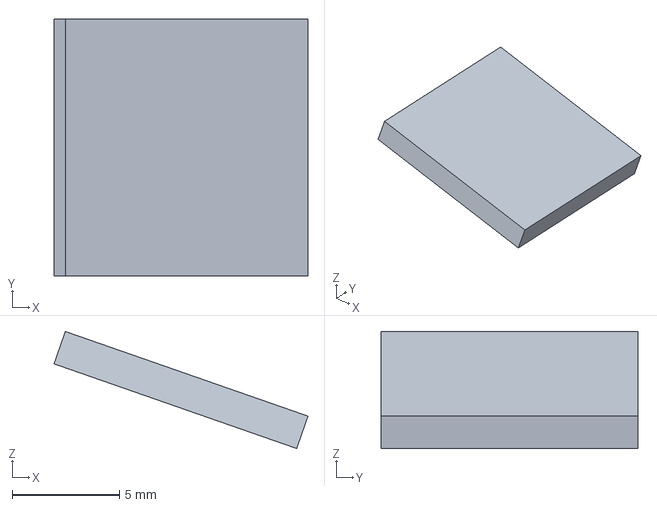
[picture p133: CAD file, 2026-10-21]
cad/collision/source/rr_shin__rr_switch_PCB.step
11.9 x 12.0 x 5.46 mm
