AlexWortega/Sweetybot2/cad/STEP/servo_strap.step

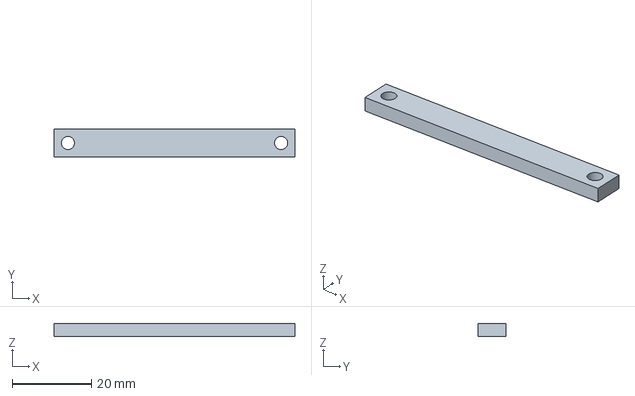
[picture p134: CAD file, 2026-10-18]
cad/STEP/servo_strap.step
60.7 x 7.00 x 3.20 mm
