AlexWortega/Sweetybot2/cad/collision/convex/torso__body_cowl__473.stl

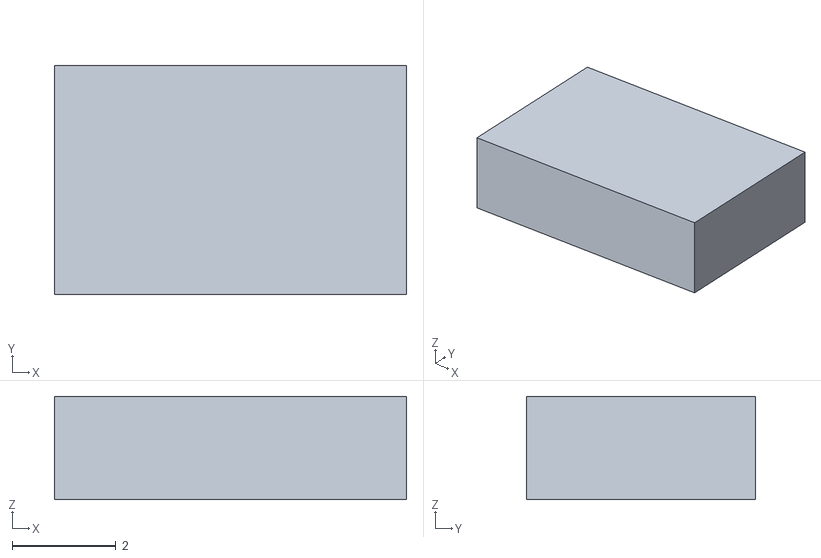
[picture p135: CAD file, 2026-10-18]
cad/collision/convex/torso__body_cowl__473.stl
6.80 x 4.41 x 1.99
