AlexWortega/Sweetybot2/cad/STEP/rail.step

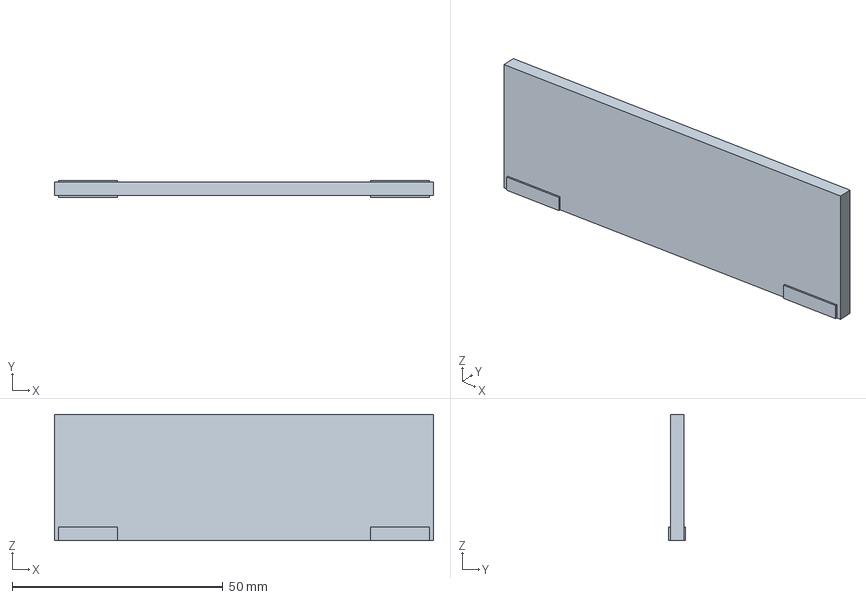
[picture p136: CAD file, 2026-10-18]
cad/STEP/rail.step
90.0 x 4.02 x 30.0 mm
