AlexWortega/Sweetybot2/cad/collision/convex/head__pony_head_shell__307.stl

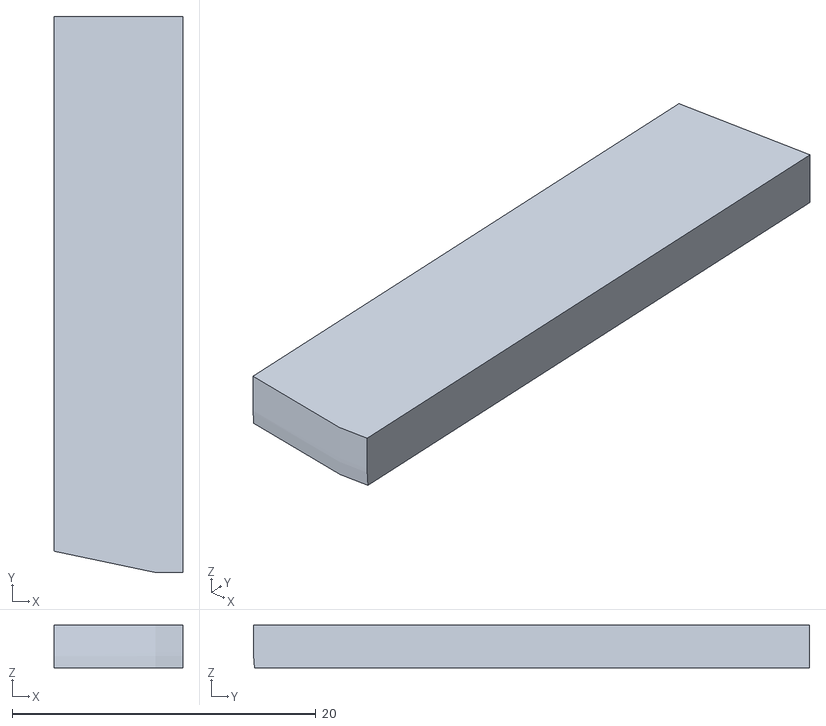
[picture p137: CAD file, 2026-10-18]
cad/collision/convex/head__pony_head_shell__307.stl
8.47 x 36.6 x 2.80
