AlexWortega/Sweetybot2/cad/collision/convex/torso__body_cowl__274.stl

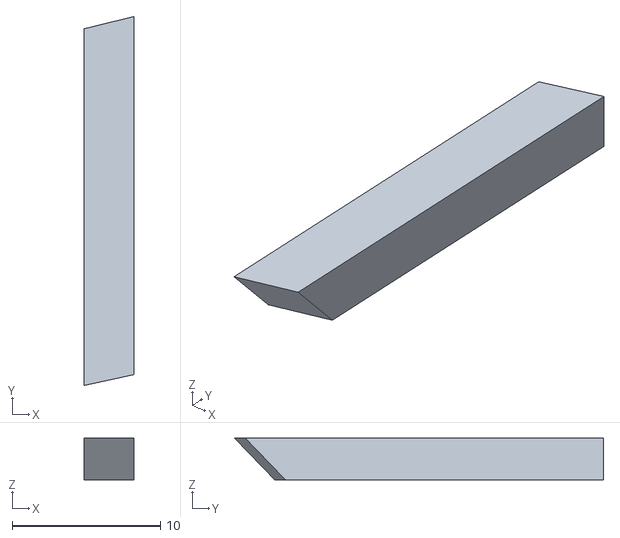
[picture p138: CAD file, 2026-10-18]
cad/collision/convex/torso__body_cowl__274.stl
3.38 x 24.9 x 2.80
