AlexWortega/Sweetybot2/cad/collision/convex/rl_thigh__rl_knee_mount_spacer_-10_-52.025__0.stl

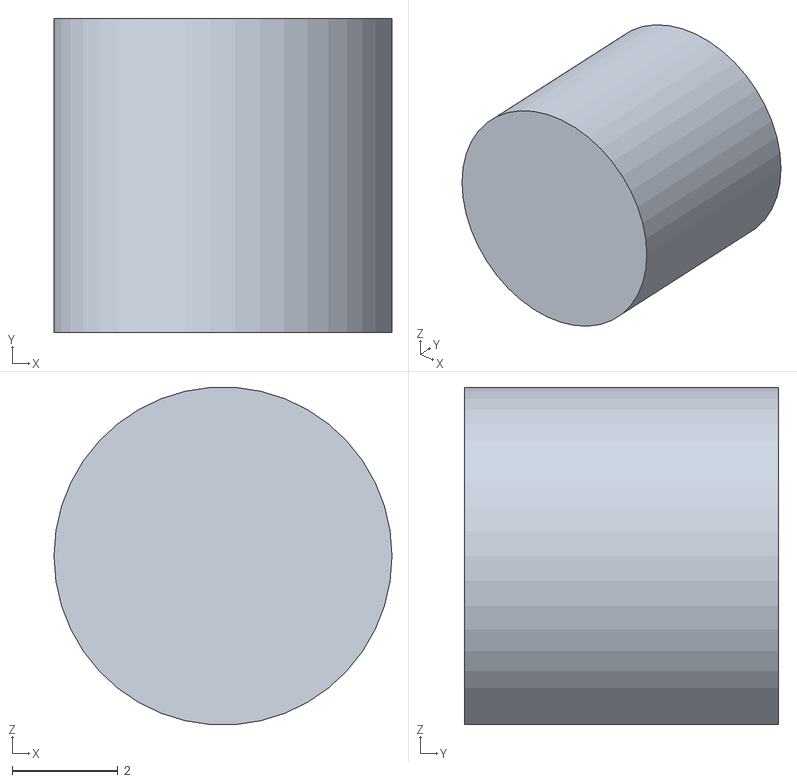
[picture p139: CAD file, 2026-10-18]
cad/collision/convex/rl_thigh__rl_knee_mount_spacer_-10_-52.025__0.stl
6.40 x 5.95 x 6.38
