AlexWortega/Sweetybot2/cad/collision/source/head__eye_bezel_1.step

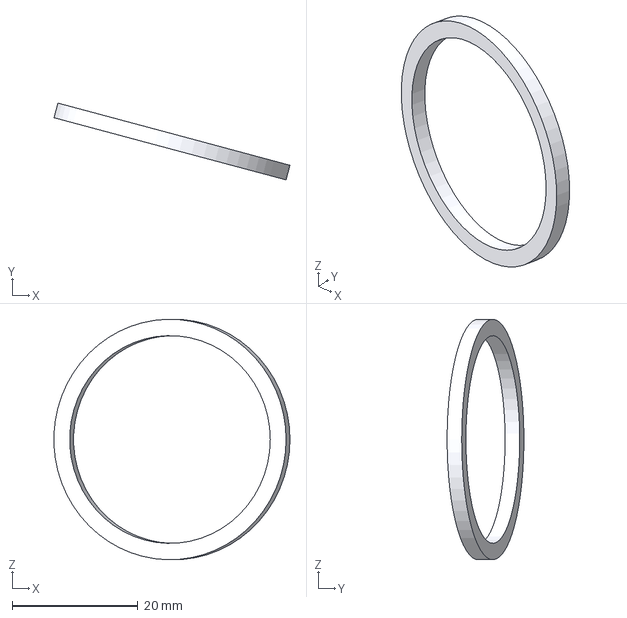
[picture p140: CAD file, 2026-10-21]
cad/collision/source/head__eye_bezel_1.step
37.5 x 12.2 x 38.2 mm
