AlexWortega/Sweetybot2/cad/manufacturing/rl_thigh__rl_knee_mount_spacer_10_-52.025.step

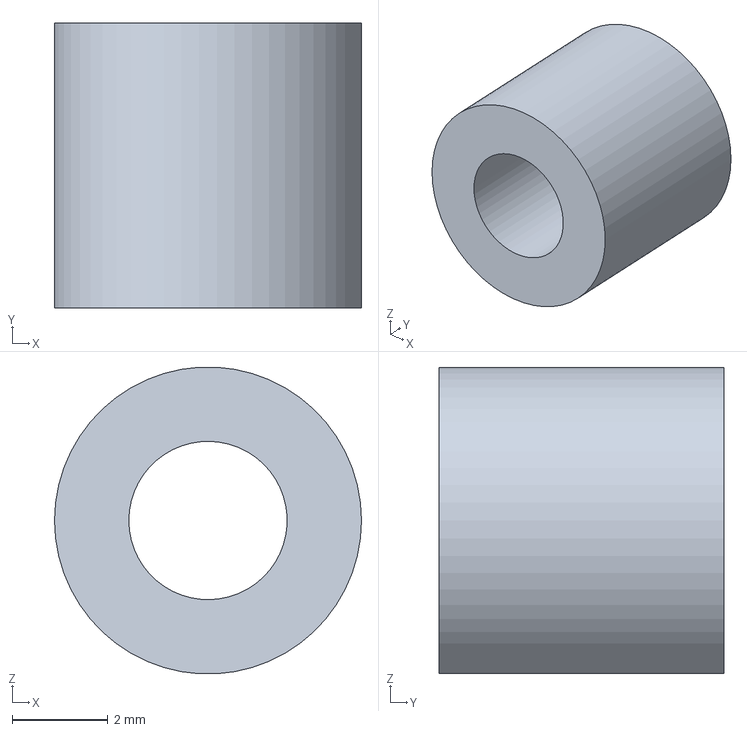
[picture p141: CAD file, 2026-10-21]
cad/manufacturing/rl_thigh__rl_knee_mount_spacer_10_-52.025.step
6.40 x 5.95 x 6.39 mm
