AlexWortega/Sweetybot2/cad/STEP/rear_knee_hub.step

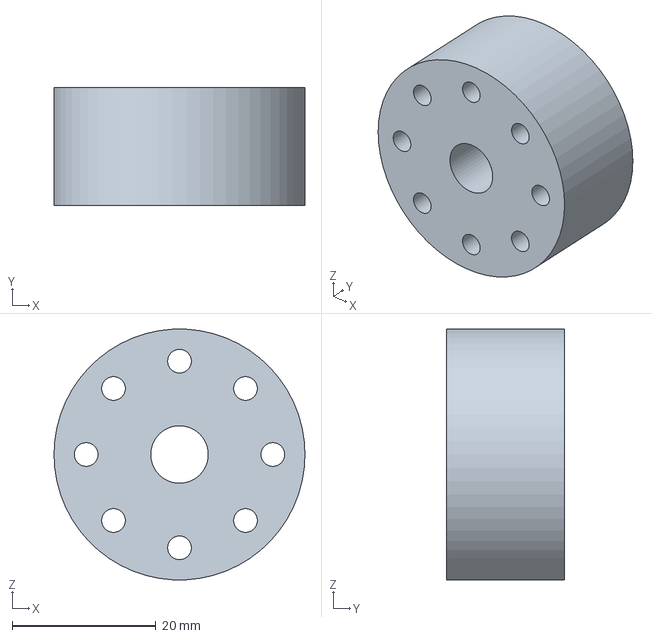
[picture p142: CAD file, 2026-10-18]
cad/STEP/rear_knee_hub.step
35.0 x 16.4 x 34.9 mm
