AlexWortega/Sweetybot2/cad/collision/convex/head__head_service_hatch__10.stl

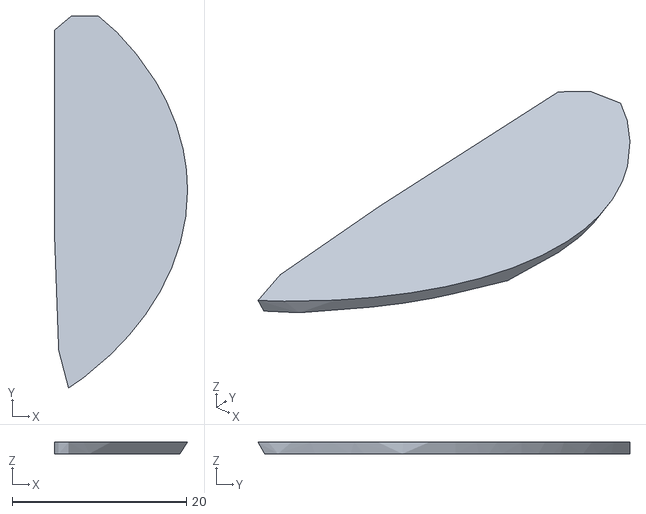
[picture p143: CAD file, 2026-10-18]
cad/collision/convex/head__head_service_hatch__10.stl
15.3 x 42.7 x 1.33
