AlexWortega/Sweetybot2/cad/collision/convex/head__pony_head_shell__595.stl

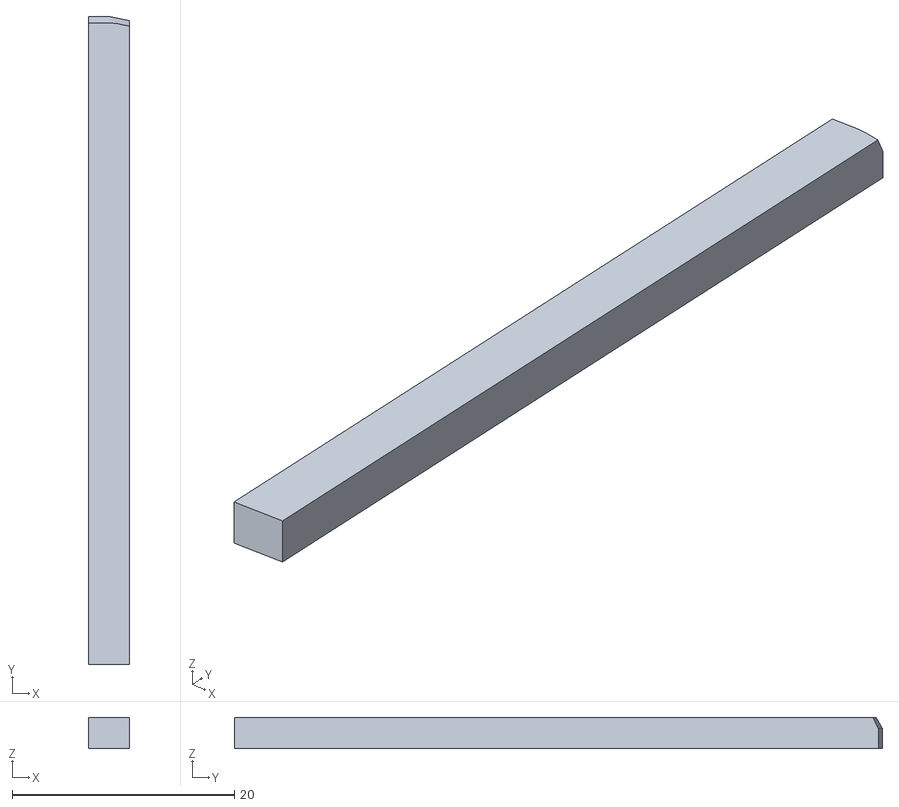
[picture p144: CAD file, 2026-10-18]
cad/collision/convex/head__pony_head_shell__595.stl
3.66 x 58.4 x 2.82
