AlexWortega/Sweetybot2/(list of files, cad)

Other CAD files:
cad/STL/mane.stl
cad/STL/links/ear_left.stl
cad/STL/links/fl_shin.stl
cad/manufacturing/fr_thigh__fr_knee_strap_-41.55.step
cad/manufacturing/rr_roll__rr_pitch_strap_-7.55.step
cad/STL/links/rl_shin.stl
cad/manufacturing/torso__fr_roll_strap_-41.55.step
cad/STEP/knee_fork.step
cad/manufacturing/rr_thigh__rr_hip_rear_rotor_hub.step
cad/STEP/knee_front_hub.step
cad/collision/source/torso__fr_roll_clamp_shims.step
cad/STL/links/rl_roll.stl
cad/collision/source/rr_thigh__rr_knee_strap_-7.55.step
cad/manufacturing/fl_shin__fl_knee_front_rotor_hub.step
cad/STL/links/rr_roll.stl
cad/collision/source/rl_roll__rl_roll_M3_heads.step
cad/manufacturing/rr_shin__rr_shin_fairing.step
cad/STL/links/rl_thigh.stl
designs/sensor-v03/cad/STEP/fit_coupon.step
cad/collision/source/fr_thigh__fr_hip_M3_heads_-8.0.step
cad/manufacturing/fr_shin__fr_floating_sole.step
cad/STL/links/rr_thigh.stl
cad/collision/source/fr_shin__fr_knee_front_rotor_hub.step
cad/manufacturing/fr_thigh__fr_hip_front_rotor_spacer.step
cad/STEP/shin_plate.step
cad/STL/links/rr_shin.stl
cad/manufacturing/rr_roll__rr_roll_yoke.step
cad/STL/links/fl_thigh.stl
cad/manufacturing/fr_shin__fr_knee_cross_spacer.step
cad/STL/links/fl_roll.stl
cad/collision/source/torso__rr_roll_strap_-7.55.step
cad/manufacturing/rl_roll__rl_pitch_strap_-41.55.step
designs/sensor-v03/cad/STEP/tail.step
cad/collision/convex/torso__body_cowl__669.stl
cad/collision/source/fr_shin__fr_switch.step
cad/STEP/shin_fairing.step
cad/collision/source/fr_thigh__fr_hip_M3_heads_68.0.step
cad/manufacturing/rl_roll__rl_pitch_clamp_shims.step
cad/manufacturing/fl_thigh__fl_knee_cradle.step
cad/collision/source/rr_thigh__rr_knee_bearing_retainer.step
cad/manufacturing/rl_roll__rl_pitch_mount_spacer_10.step
cad/collision/source/rr_shin__rr_switch.step
cad/manufacturing/fl_roll__fl_pitch_strap_-7.55.step
cad/STEP/head_yoke.step
cad/collision/source/rr_thigh__rr_knee_passive_bearing.step
cad/manufacturing/rr_thigh__rr_knee_mount_spacer_-10_1.725.step
cad/STEP/head_hatch.step
cad/collision/source/rl_thigh__rl_knee_strap_-41.55.step
cad/manufacturing/fr_shin__fr_TPU_actuator.step
cad/STEP/servo_cradle_sm105.step
cad/STEP/depth_pod.step
cad/STEP/ear.step
cad/STEP/eye_bezel.step
cad/STEP/head_shell.step
cad/STEP/hoof_actuator.step
cad/STEP/horn.step
cad/STEP/servo_cradle.step
cad/STEP/servo_cradle_sm80.step
cad/STEP/servo_strap_sm105.step
cad/STEP/servo_strap_sm80.step
cad/STEP/thigh_plate.step
cad/STEP/thigh_rear_plate.step
cad/STL/axle_adapter.stl
cad/STL/bearing_retainer.stl
cad/STL/body_shell.stl
cad/STL/deck.stl
cad/STL/depth_pod.stl
cad/STL/ear.stl
cad/STL/eye_bezel.stl
cad/STL/head_hatch.stl
cad/STL/head_shell.stl
cad/STL/head_yoke.stl
cad/STL/hoof.stl
cad/STL/hoof_actuator.stl
cad/STL/horn.stl
cad/STL/knee_fork.stl
cad/STL/knee_front_hub.stl
cad/STL/mane_stripe.stl
cad/STL/neck_collar.stl
cad/STL/rail.stl
cad/STL/rear_hip_hub.stl
cad/STL/rear_knee_hub.stl
cad/STL/roll_yoke.stl
cad/STL/rotor_spacer.stl
cad/STL/sensor_tray.stl
cad/STL/servo_cradle.stl
cad/STL/servo_cradle_sm105.stl
cad/STL/servo_cradle_sm80.stl
cad/STL/servo_strap.stl
cad/STL/servo_strap_sm105.stl
cad/STL/servo_strap_sm80.stl
cad/STL/shin_fairing.stl
cad/STL/shin_plate.stl
cad/STL/shin_rear_plate.stl
cad/STL/thigh_fairing.stl
cad/STL/thigh_plate.stl
cad/STL/thigh_rear_plate.stl
cad/collision/convex/ear_left__ear_shell_1__0.stl
cad/collision/convex/ear_left__ear_shell_1__1.stl
cad/collision/convex/ear_left__ear_shell_1__2.stl
cad/collision/convex/ear_right__ear_output_adapter_-1__0.stl
cad/collision/convex/ear_right__ear_shell_-1__0.stl
cad/collision/convex/ear_right__ear_shell_-1__1.stl
cad/collision/convex/fl_roll__fl_hip_bearing_retainer__0.stl
cad/collision/convex/fl_roll__fl_hip_bearing_retainer__1.stl
cad/collision/convex/fl_roll__fl_hip_bearing_retainer__10.stl
cad/collision/convex/fl_roll__fl_hip_bearing_retainer__11.stl
cad/collision/convex/fl_roll__fl_hip_bearing_retainer__2.stl
cad/collision/convex/fl_roll__fl_hip_bearing_retainer__3.stl
cad/collision/convex/fl_roll__fl_hip_bearing_retainer__4.stl
cad/collision/convex/fl_roll__fl_hip_bearing_retainer__5.stl
cad/collision/convex/fl_roll__fl_hip_bearing_retainer__6.stl
cad/collision/convex/fl_roll__fl_hip_bearing_retainer__7.stl
cad/collision/convex/fl_roll__fl_hip_bearing_retainer__8.stl
cad/collision/convex/fl_roll__fl_hip_bearing_retainer__9.stl
cad/collision/convex/fl_roll__fl_hip_passive_bearing__0.stl
cad/collision/convex/fl_roll__fl_hip_passive_bearing__1.stl
cad/collision/convex/fl_roll__fl_hip_passive_bearing__10.stl
cad/collision/convex/fl_roll__fl_hip_passive_bearing__11.stl
cad/collision/convex/fl_roll__fl_hip_passive_bearing__12.stl
cad/collision/convex/fl_roll__fl_hip_passive_bearing__13.stl
cad/collision/convex/fl_roll__fl_hip_passive_bearing__14.stl
cad/collision/convex/fl_roll__fl_hip_passive_bearing__2.stl
cad/collision/convex/fl_roll__fl_hip_passive_bearing__3.stl
cad/collision/convex/fl_roll__fl_hip_passive_bearing__4.stl
cad/collision/convex/fl_roll__fl_hip_passive_bearing__5.stl
cad/collision/convex/fl_roll__fl_hip_passive_bearing__6.stl
cad/collision/convex/fl_roll__fl_hip_passive_bearing__7.stl
cad/collision/convex/fl_roll__fl_hip_passive_bearing__8.stl
cad/collision/convex/fl_roll__fl_hip_passive_bearing__9.stl
cad/collision/convex/fl_roll__fl_pitch_clamp_shims__0.stl
cad/collision/convex/fl_roll__fl_pitch_clamp_shims__1.stl
cad/collision/convex/fl_roll__fl_pitch_clamp_shims__2.stl
cad/collision/convex/fl_roll__fl_pitch_clamp_shims__3.stl
cad/collision/convex/fl_roll__fl_pitch_clamp_shims__4.stl
cad/collision/convex/fl_roll__fl_pitch_cradle__0.stl
cad/collision/convex/fl_roll__fl_pitch_cradle__1.stl
cad/collision/convex/fl_roll__fl_pitch_cradle__10.stl
cad/collision/convex/fl_roll__fl_pitch_cradle__11.stl
cad/collision/convex/fl_roll__fl_pitch_cradle__12.stl
cad/collision/convex/fl_roll__fl_pitch_cradle__2.stl
cad/collision/convex/fl_roll__fl_pitch_cradle__3.stl
cad/collision/convex/fl_roll__fl_pitch_cradle__4.stl
cad/collision/convex/fl_roll__fl_pitch_cradle__5.stl
cad/collision/convex/fl_roll__fl_pitch_cradle__6.stl
cad/collision/convex/fl_roll__fl_pitch_cradle__7.stl
cad/collision/convex/fl_roll__fl_pitch_cradle__8.stl
cad/collision/convex/fl_roll__fl_pitch_cradle__9.stl
cad/collision/convex/fl_roll__fl_pitch_mount_spacer_-10__0.stl
cad/collision/convex/fl_roll__fl_pitch_mount_spacer_10__0.stl
cad/collision/convex/fl_roll__fl_pitch_servo__0.stl
cad/collision/convex/fl_roll__fl_pitch_servo__1.stl
cad/collision/convex/fl_roll__fl_pitch_servo__2.stl
cad/collision/convex/fl_roll__fl_pitch_strap_-41.55__0.stl
cad/collision/convex/fl_roll__fl_pitch_strap_-7.55__0.stl
cad/collision/convex/fl_roll__fl_roll_M3_heads__1.stl
cad/collision/convex/fl_roll__fl_roll_M3_heads__2.stl
cad/collision/convex/fl_roll__fl_roll_M3_heads__5.stl
cad/collision/convex/fl_roll__fl_roll_M3_heads__6.stl
cad/collision/convex/fl_roll__fl_roll_yoke__0.stl
cad/collision/convex/fl_roll__fl_roll_yoke__1.stl
cad/collision/convex/fl_roll__fl_roll_yoke__10.stl
cad/collision/convex/fl_roll__fl_roll_yoke__11.stl
cad/collision/convex/fl_roll__fl_roll_yoke__12.stl
cad/collision/convex/fl_roll__fl_roll_yoke__13.stl
cad/collision/convex/fl_roll__fl_roll_yoke__14.stl
cad/collision/convex/fl_roll__fl_roll_yoke__15.stl
cad/collision/convex/fl_roll__fl_roll_yoke__16.stl
cad/collision/convex/fl_roll__fl_roll_yoke__17.stl
cad/collision/convex/fl_roll__fl_roll_yoke__18.stl
cad/collision/convex/fl_roll__fl_roll_yoke__19.stl
cad/collision/convex/fl_roll__fl_roll_yoke__2.stl
cad/collision/convex/fl_roll__fl_roll_yoke__20.stl
cad/collision/convex/fl_roll__fl_roll_yoke__21.stl
cad/collision/convex/fl_roll__fl_roll_yoke__22.stl
cad/collision/convex/fl_roll__fl_roll_yoke__23.stl
cad/collision/convex/fl_roll__fl_roll_yoke__24.stl
cad/collision/convex/fl_roll__fl_roll_yoke__25.stl
cad/collision/convex/fl_roll__fl_roll_yoke__26.stl
cad/collision/convex/fl_roll__fl_roll_yoke__27.stl
cad/collision/convex/fl_roll__fl_roll_yoke__28.stl
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
