AlexWortega/Sweetybot2/cad/manufacturing/README.md

# Handed custom parts for design review

Use the exact per-instance geometry here when checking left/right and front/hind parts. The hind legs fold rearward; their hoof seats and motor carriers are handed. Generic part previews are insufficient to select four identical pieces.

Fabrication approval is outstanding: actual servo spline/horn and screw fits, bearings, fasteners, cable routing, strength, thermal/power tests and device commissioning remain required. See docs/v05.md and reports/mechanical_gate.json.
