AlexWortega/Sweetybot2/renders/assembly_front.png

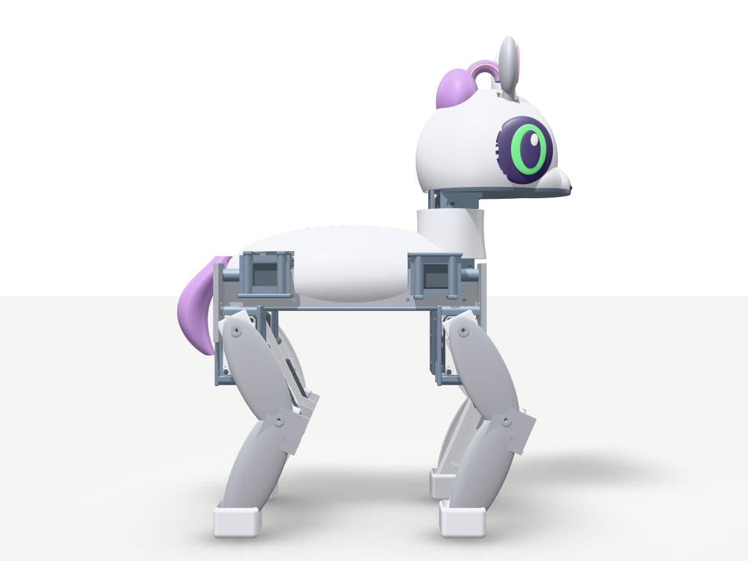
renders/assembly_front.png
