AlexWortega/Sweetybot2/renders/assembly_left.png

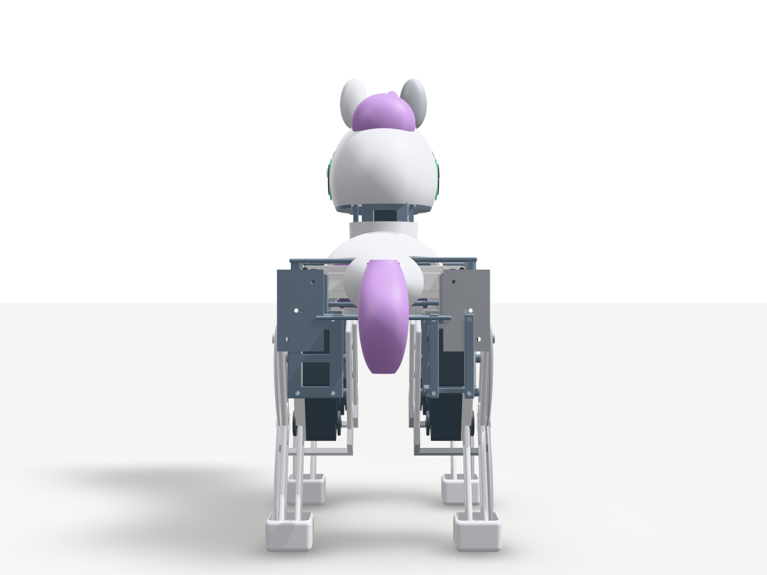
renders/assembly_left.png
