AlexWortega/Sweetybot2/docs/results.md

# Digital results and limits

Current evidence: [v05 physics](../reports/v05_validation.json), [mechanical gate](../reports/mechanical_gate.json), [source STEP round trips](../reports/cad_snapshot.json), [assembly exports](../reports/assembly_exports.json), [collision coverage](../reports/collision_coverage.json) and [software verification](../reports/verification.json).

Four terrain types each use four identical deterministic replicas for 20s of neutral-target standing, not independent statistical trials. The actual collision model passes 140 declared operational poses. Freefall checks accelerometer specific force. These checks establish digital plumbing and neutral support, not learned walking/running/recovery or physical endurance. CPU optimizer/replay smoke results are diagnostic only. V04 is withdrawn; v02 controller/policy previews remain historical.
