AlexWortega/Sweetybot2/simulation/generated/sweetie_mini.urdf

<?xml version='1.0' encoding='utf-8'?>
<robot name="sweetie_mini">
  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
  <link name="torso_link">
    <inertial>
      <origin xyz="0.004778390617 -0.0001366712221 -0.002007668506" rpy="0 0 0" />
      <mass value="2.23178963651774" />
      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
    </inertial>
    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
  </link>
  <link name="fl_roll_link">
    <inertial>
      <origin xyz="0.00285964076 -6.969887005e-05 -0.05586058649" rpy="0 0 0" />
      <mass value="0.474059733811006" />
      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
    </inertial>
    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
  </link>
  <joint name="fl_hip_roll" type="revolute">
    <parent link="torso_link" />
    <child link="fl_roll_link" />
    <origin xyz="0.099 0.07 0" rpy="0 0 0" />
    <axis xyz="1 0 0" />
    <limit lower="-0.10471975511965978" upper="0.7853981633974483" effort="6.270126843750001" velocity="4.869468613064179" />
    <dynamics damping="0.015" friction="0.018" />
  </joint>
  <link name="fl_thigh_link">
    <inertial>
      <origin xyz="0.001121229198 -0.0299438095 -0.08610924871" rpy="0 0 0" />
      <mass value="0.5016475672239777" />
      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
    </inertial>
    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
  </link>
  <joint name="fl_hip_pitch" type="revolute">
    <parent link="fl_roll_link" />
    <child link="fl_thigh_link" />
    <origin xyz="0 0.03 -0.062" rpy="0 0 0" />
    <axis xyz="0 1 0" />
    <limit lower="-1.5" upper="0.1" effort="6.270126843750001" velocity="4.869468613064179" />
    <dynamics damping="0.015" friction="0.018" />
  </joint>
  <link name="fl_shin_link">
    <inertial>
      <origin xyz="0.0003512824803 -0.01971797885 -0.03812178854" rpy="0 0 0" />
      <mass value="0.19139004832181278" />
      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
    </inertial>
    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
  </link>
  <joint name="fl_knee" type="revolute">
    <parent link="fl_thigh_link" />
    <child link="fl_shin_link" />
    <origin xyz="0 0 -0.115" rpy="0 0 0" />
    <axis xyz="0 1 0" />
    <limit lower="0.1" upper="2.1" effort="6.270126843750001" velocity="4.869468613064179" />
    <dynamics damping="0.015" friction="0.018" />
  </joint>
  <link name="fr_roll_link">
    <inertial>
      <origin xyz="0.005232598678 6.969887005e-05 -0.05586058649" rpy="0 0 0" />
      <mass value="0.4740597338110091" />
      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
    </inertial>
    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
  </link>
  <joint name="fr_hip_roll" type="revolute">
    <parent link="torso_link" />
    <child link="fr_roll_link" />
    <origin xyz="0.099 -0.07 0" rpy="0 0 0" />
    <axis xyz="1 0 0" />
    <limit lower="-0.7853981633974483" upper="0.10471975511965978" effort="6.270126843750001" velocity="4.869468613064179" />
    <dynamics damping="0.015" friction="0.018" />
  </joint>
  <link name="fr_thigh_link">
    <inertial>
      <origin xyz="-0.001121229198 0.0299438095 -0.08610924871" rpy="0 0 0" />
      <mass value="0.501647567223975" />
      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
    </inertial>
    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
  </link>
  <joint name="fr_hip_pitch" type="revolute">
    <parent link="fr_roll_link" />
    <child link="fr_thigh_link" />
    <origin xyz="0 -0.03 -0.062" rpy="0 0 0" />
    <axis xyz="0 1 0" />
    <limit lower="-1.5" upper="0.1" effort="6.270126843750001" velocity="4.869468613064179" />
    <dynamics damping="0.015" friction="0.018" />
  </joint>
  <link name="fr_shin_link">
    <inertial>
      <origin xyz="0.0003512824803 0.01936330535 -0.03812178854" rpy="0 0 0" />
      <mass value="0.19139004831777717" />
      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
    </inertial>
    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
  </link>
  <joint name="fr_knee" type="revolute">
    <parent link="fr_thigh_link" />
    <child link="fr_shin_link" />
    <origin xyz="0 0 -0.115" rpy="0 0 0" />
    <axis xyz="0 1 0" />
    <limit lower="0.1" upper="2.1" effort="6.270126843750001" velocity="4.869468613064179" />
    <dynamics damping="0.015" friction="0.018" />
  </joint>
  <link name="rl_roll_link">
    <inertial>
      <origin xyz="-0.00285964076 -6.969887005e-05 -0.05586058649" rpy="0 0 0" />
      <mass value="0.47405973381100697" />
      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
    </inertial>
    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
  </link>
  <joint name="rl_hip_roll" type="revolute">
    <parent link="torso_link" />
    <child link="rl_roll_link" />
    <origin xyz="-0.099 0.07 0" rpy="0 0 0" />
    <axis xyz="1 0 0" />
    <limit lower="-0.10471975511965978" upper="0.7853981633974483" effort="6.270126843750001" velocity="4.869468613064179" />
    <dynamics damping="0.015" friction="0.018" />
  </joint>
  <link name="rl_thigh_link">
    <inertial>
      <origin xyz="-0.001121229198 -0.0299438095 -0.08610924871" rpy="0 0 0" />
      <mass value="0.501647567223665" />
      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
    </inertial>
    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
  </link>
  <joint name="rl_hip_pitch" type="revolute">
    <parent link="rl_roll_link" />
    <child link="rl_thigh_link" />
    <origin xyz="0 0.03 -0.062" rpy="0 0 0" />
    <axis xyz="0 -1 0" />
    <limit lower="-1.5" upper="0.1" effort="6.270126843750001" velocity="4.869468613064179" />
    <dynamics damping="0.015" friction="0.018" />
  </joint>
  <link name="rl_shin_link">
    <inertial>
      <origin xyz="-0.0003512824803 -0.01971797885 -0.03812178854" rpy="0 0 0" />
      <mass value="0.19139004831765596" />
      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
    </inertial>
    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
  </link>
  <joint name="rl_knee" type="revolute">
    <parent link="rl_thigh_link" />
    <child link="rl_shin_link" />
    <origin xyz="0 0 -0.115" rpy="0 0 0" />
    <axis xyz="0 -1 0" />
    <limit lower="0.1" upper="2.1" effort="6.270126843750001" velocity="4.869468613064179" />
    <dynamics damping="0.015" friction="0.018" />
  </joint>
  <link name="rr_roll_link">
    <inertial>
      <origin xyz="-0.005232598678 6.969887005e-05 -0.05586058649" rpy="0 0 0" />
      <mass value="0.47405973381100724" />
      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
    </inertial>
    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
  </link>
  <joint name="rr_hip_roll" type="revolute">
    <parent link="torso_link" />
    <child link="rr_roll_link" />
    <origin xyz="-0.099 -0.07 0" rpy="0 0 0" />
    <axis xyz="1 0 0" />
    <limit lower="-0.7853981633974483" upper="0.10471975511965978" effort="6.270126843750001" velocity="4.869468613064179" />
    <dynamics damping="0.015" friction="0.018" />
  </joint>
  <link name="rr_thigh_link">
    <inertial>
      <origin xyz="0.001121229198 0.0299438095 -0.08610924871" rpy="0 0 0" />
      <mass value="0.501647567223977" />
      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
    </inertial>
    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
  </link>
  <joint name="rr_hip_pitch" type="revolute">
    <parent link="rr_roll_link" />
    <child link="rr_thigh_link" />
    <origin xyz="0 -0.03 -0.062" rpy="0 0 0" />
    <axis xyz="0 -1 0" />
    <limit lower="-1.5" upper="0.1" effort="6.270126843750001" velocity="4.869468613064179" />
    <dynamics damping="0.015" friction="0.018" />
  </joint>
  <link name="rr_shin_link">
    <inertial>
      <origin xyz="-0.0003512824803 0.01936330535 -0.03812178854" rpy="0 0 0" />
      <mass value="0.1913900483216966" />
      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
    </inertial>
    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
  </link>
  <joint name="rr_knee" type="revolute">
    <parent link="rr_thigh_link" />
    <child link="rr_shin_link" />
    <origin xyz="0 0 -0.115" rpy="0 0 0" />
    <axis xyz="0 -1 0" />
    <limit lower="0.1" upper="2.1" effort="6.270126843750001" velocity="4.869468613064179" />
    <dynamics damping="0.015" friction="0.018" />
  </joint>
  <link name="neck_yaw_link">
    <inertial>
      <origin xyz="-0.001446067681 -0.0005264871065 0.03296927699" rpy="0 0 0" />
      <mass value="0.17546671484734536" />
      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
    </inertial>
    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
  </link>
  <joint name="head_yaw" type="revolute">
    <parent link="torso_link" />
    <child link="neck_yaw_link" />
    <origin xyz="0.096 0 0.03" rpy="0 0 0" />
    <axis xyz="0 0 1" />
    <limit lower="-0.8" upper="0.8" effort="2.090031625" velocity="6.08685" />
    <dynamics damping="0.015" friction="0.018" />
  </joint>
  <link name="head_link">
    <inertial>
      <origin xyz="0.02440351932 -0.000155039275 0.06273621823" rpy="0 0 0" />
      <mass value="0.26072589018361814" />
      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
    </inertial>
    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
  </link>
  <joint name="head_pitch" type="revolute">
    <parent link="neck_yaw_link" />
    <child link="head_link" />
    <origin xyz="0 0 0.048" rpy="0 0 0" />
    <axis xyz="0 1 0" />
    <limit lower="-0.35" upper="0.35" effort="2.090031625" velocity="6.08685" />
    <dynamics damping="0.015" friction="0.018" />
  </joint>
  <link name="ear_left_link">
    <inertial>
      <origin xyz="-0.001350289324 0.01158709958 0.02323892112" rpy="0 0 0" />
      <mass value="0.014175350073357743" />
      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
    </inertial>
    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
  </link>
  <joint name="ear_left" type="revolute">
    <parent link="head_link" />
    <child link="ear_left_link" />
    <origin xyz="0.045 0.012 0.102" rpy="0 0 0" />
    <axis xyz="1 0 0" />
    <limit lower="-0.25" upper="0.25" effort="0.24271500000000004" velocity="11.635" />
    <dynamics damping="0.015" friction="0.018" />
  </joint>
  <link name="ear_right_link">
    <inertial>
      <origin xyz="-0.001350288654 -0.0115870859 0.02323889465" rpy="0 0 0" />
      <mass value="0.014175365078113157" />
      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
    </inertial>
    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
  </link>
  <joint name="ear_right" type="revolute">
    <parent link="head_link" />
    <child link="ear_right_link" />
    <origin xyz="0.045 -0.012 0.102" rpy="0 0 0" />
    <axis xyz="1 0 0" />
    <limit lower="-0.25" upper="0.25" effort="0.24271500000000004" velocity="11.635" />
    <dynamics damping="0.015" friction="0.018" />
  </joint>
  <link name="torso_imu_frame" />
  <joint name="torso_imu_mount" type="fixed">
    <parent link="torso_link" />
    <child link="torso_imu_frame" />
    <origin xyz="0.01 0 0.029" rpy="0 0 0" />
  </joint>
  <link name="chest_tof_frame" />
  <joint name="chest_tof_mount" type="fixed">
    <parent link="torso_link" />
    <child link="chest_tof_frame" />
    <origin xyz="0.135 0 -0.01" rpy="0 0.3490658504 0" />
  </joint>
  <link name="forehead_rgb_frame" />
  <joint name="forehead_rgb_mount" type="fixed">
    <parent link="head_link" />
    <child link="forehead_rgb_frame" />
    <origin xyz="0.078 0 0.091" rpy="0 0 0" />
  </joint>
</robot>
