AlexWortega/Sweetybot2/config/robot.yaml

name: sweetie_mini
revision: digital-prototype-05-mechanical-redesign
units:
  cad: mm
  dynamics: SI
  angles: rad
geometry:
  body:
  - 240
  - 136
  - 88
  hip_x: 99
  hip_y: 70
  abduction_offset: 30
  hip_drop: 62
  thigh: 115
  shin: 110
  foot_radius: 21
  stance_height: 275
  head_origin:
  - 96
  - 0
  - 30
  neck_pitch_rise: 48
  head_center:
  - 30
  - 0
  - 38
  head_radii:
  - 59
  - 50
  - 59
  muzzle_center:
  - 68
  - 0
  - 14
  muzzle_radii:
  - 23
  - 27
  - 20
  ear_origin:
  - 45
  - 12
  - 102
  ear_size:
  - 16
  - 26
  - 78
  shell_wall: 1.8
  structural_wall: 3.2
  fastener_clearance: 3.3
  bearing_od: 10
  bearing_bore: 3
  bearing_width: 4
  fit_allowance: 0.2
mass:
  torso_without_servos: 1.3572896365177398
  roll_link_without_servo: 0.274059733811006
  thigh_without_servo: 0.30164756722397773
  shin_and_foot: 0.19139004832181278
  head_yaw_without_servo: 0.10096671484734536
  head_without_servos: 0.22072589018361813
  ear_without_servo: 0.014175350073357743
  uncertainty_fraction: 0.2
  method: placed CAD BRep volume/inertia, 6061/PETG/TPU; catalogue motor masses and
    unweighed electronics/fastener allowances
actuator_candidates:
  XL330-M288:
    voltage: 5.0
    mass: 0.018
    stall_torque: 0.52
    no_load_speed: 10.786
    stall_current: 1.47
    envelope:
    - 20
    - 34
    - 26
    unit_usd: 27.49
    price_status: manufacturer_snapshot
    source: https://emanual.robotis.com/docs/en/dxl/x/xl330-m288/
  XC330-M288:
    voltage: 5.0
    mass: 0.023
    stall_torque: 0.93
    no_load_speed: 8.482
    stall_current: 1.8
    envelope:
    - 20
    - 34
    - 26
    unit_usd: 103.39
    price_status: manufacturer_snapshot
    source: https://emanual.robotis.com/docs/en/dxl/x/xc330-m288/
  ST3215-12V:
    voltage: 12.0
    voltage_range:
    - 6.0
    - 12.6
    mass: 0.055
    stall_torque: 2.942
    no_load_speed: 4.77
    stall_current: 2.7
    envelope:
    - 45.22
    - 24.72
    - 35
    unit_usd: 19.99
    price_status: planning_allowance_not_quote
    source: https://www.waveshare.com/wiki/ST3215_Servo
  STS3250-12V:
    voltage: 12.0
    voltage_range:
    - 6.0
    - 12.0
    mass: 0.0745
    stall_torque: 4.9033
    rated_torque: 1.5691
    no_load_speed: 7.854
    stall_current: 4.2
    envelope:
    - 45.22
    - 24.72
    - 35.0
    unit_usd: 44.99
    price_status: planning_allowance_not_quote
    source: https://www.feetechrc.com/sts_ttl_series%20servo.html
    specification: references/STS3250-manufacturer.pdf
  SM105BL-C001:
    voltage: 12.0
    voltage_range:
    - 9.0
    - 12.6
    mass: 0.2
    stall_torque: 14.709975
    rated_torque: 4.903325
    no_load_speed: 6.283185307179586
    stall_current: 6.3
    envelope:
    - 58.5
    - 33.5
    - 44.0
    unit_usd: 120.0
    price_status: planning_allowance_not_quote
    source: https://ftservo.github.io/ftservo-wiki/products/models/sm-105b-c001/main/
    specification: references/v04/SM105BL-C001.pdf
    interface: RS485
    case_x_min_mm: -19.75
    case_z_width_mm: 33.5
    case_y_min_mm: -46.55
  SM80BL-C001:
    voltage: 12.0
    voltage_range:
    - 9.0
    - 12.6
    mass: 0.0975
    stall_torque: 7.84532
    rated_torque: 1.96133
    no_load_speed: 6.492624817418905
    stall_current: 5.9
    envelope:
    - 46.5
    - 28.5
    - 34.0
    unit_usd: 85.0
    price_status: planning_allowance_not_quote
    source: https://ftservo.github.io/ftservo-wiki/products/models/sm-80bl-c001/main/
    specification: references/v04/SM80BL-C001.pdf
    interface: RS485
    case_x_min_mm: -11.5
    case_z_width_mm: 28.5
    case_y_min_mm: -36.5
selection:
  sustained_fraction_of_stall: 0.25
  transient_fraction_of_stall: 0.55
  torque_margin: 1.5
  required_joint_speed: 0.8
  max_head_pitch: 0.35
  load_share_worst: 0.5
  selected: SM105BL-C001
joints:
  hip_roll:
    axis:
    - 1
    - 0
    - 0
    limits:
    - -0.10471975511965978
    - 0.7853981633974483
    # Canonical left leg: 6 degrees inward, 45 outward; right legs mirror.
    mirror_limits_by_side: true
    home: 0.0
  hip_pitch:
    axis:
    - 0
    - 1
    - 0
    limits:
    - -1.5
    - 0.1
    home: -0.55
  knee:
    axis:
    - 0
    - 1
    - 0
    limits:
    - 0.1
    - 2.1
    home: 1.05
  head_yaw:
    axis:
    - 0
    - 0
    - 1
    limits:
    - -0.8
    - 0.8
    home: 0.0
  head_pitch:
    axis:
    - 0
    - 1
    - 0
    limits:
    - -0.35
    - 0.35
    home: 0.0
  ear:
    axis:
    - 1
    - 0
    - 0
    limits:
    - -0.25
    - 0.25
    home: 0.0
legs:
  fl:
    x_sign: 1
    y_sign: 1
    ids:
    - 1
    - 2
    - 3
  fr:
    x_sign: 1
    y_sign: -1
    ids:
    - 4
    - 5
    - 6
  rl:
    x_sign: -1
    y_sign: 1
    ids:
    - 7
    - 8
    - 9
  rr:
    x_sign: -1
    y_sign: -1
    ids:
    - 10
    - 11
    - 12
expression_ids:
  head_yaw: 13
  head_pitch: 14
  ear_left: 15
  ear_right: 16
power:
  battery:
    chemistry: LiFePO4
    cells: 3
    nominal_voltage: 9.9
    max_voltage: 10.8
    cutoff_voltage: 9.3
    capacity_ah: 2.5
    c_rating: 20
    pack_mass_kg: 0.28
    envelope_mm:
    - 82
    - 70
    - 30
    source: https://lithiumwerks.com/products/lithium-ion-26650-cells/
  main_fuse_a: 40
  leg_branch_fuse_a: 10
  head_branch_fuse_a: 5
  logic_voltage: 5.0
  logic_regulator_a: 5
  usable_energy_fraction: 0.75
  assumed_average_servo_current_a: 0.25
  electronics_w: 7.5
  main_cable_awg: 12
  leg_cable_awg: 16
  bms_continuous_a: 40
control:
  policy_hz: 50
  physics_hz: 500
  kp: 12.0
  kd: 0.45
  command_timeout_s: 0.25
  initial_delay_ticks: 1
  friction_coefficient: 0.9
  backlash_rad: 0.0174533
  joint_viscous_friction: 0.015
  joint_coulomb_friction: 0.018
sensing:
  revision: 1
  status: hardware design candidate; physical integration unverified
  leg_imus: false
  torso_imu:
    model: SparkFun SEN-21325 LSM6DSV16X Qwiic
    i2c_7bit: 107
    board_mm:
    - 25.4
    - 25.4
    - 1.6
    keepout_mm:
    - 25.4
    - 25.4
    - 6
    center_torso_mm:
    - 10
    - 0
    - 29
    mount_quaternion_wxyz:
    - 1
    - 0
    - 0
    - 0
    target_output_hz: 120
    source: https://docs.sparkfun.com/SparkFun_6DoF_LSM6DSV16X/single_page/
    sample_hz: 120
    noise_gyro_rad_s: 0.007
    noise_accel_m_s2: 0.08
  collector:
    model: Seeed XIAO RP2040
    board_mm:
    - 21
    - 17.8
    - 1.6
    keepout_mm:
    - 21
    - 17.8
    - 7
    center_torso_mm:
    - -30
    - 0
    - 29
    contact_scan_hz: 200
    uart_baud: 460800
    source: https://wiki.seeedstudio.com/XIAO-RP2040/
  camera:
    model: Raspberry Pi Camera Module 3 Wide, visible-light IMX708
    board_mm:
    - 25
    - 24
    - 1.6
    keepout_mm:
    - 25
    - 24
    - 12.4
    pcb_center_head_mm:
    - 65.6
    - 0
    - 64.5
    lens_axis_head_mm:
    - 78
    - 0
    - 91
    fov_horizontal_deg: 102
    fov_vertical_deg: 67
    opening_diameter_mm: 20
    csi_cable: 22-pin 0.5mm Pi Zero to 15-pin 1mm camera; 300mm service-loop allowance,
      verify bend radius
    source: https://datasheets.raspberrypi.com/camera/camera-module-3-product-brief.pdf
  depth:
    model: SparkFun SEN-18642 VL53L5CX
    board_mm:
    - 25.4
    - 25.4
    - 1.6
    keepout_mm:
    - 25.4
    - 25.4
    - 5
    downward_pitch_deg: 20
    i2c_7bit: 41
    resolution:
    - 8
    - 8
    target_hz: 15
    diagonal_fov_deg: 65
    opening_yz_mm:
    - 22
    - 16
    source: https://www.sparkfun.com/sparkfun-qwiic-tof-imager-vl53l5cx.html
    pcb_center_torso_mm:
    - 128
    - 0
    - -7
    opening_torso_mm:
    - 135
    - 0
    - -10
    mount_status: external chest pod; tilted board mount requires shims/coupon
    power: dedicated 3.3V >=0.5A buck from logic 5V; never parallel its output with
      Pi 3V3
  feet:
    model: Omron B3SE-1002P on 12x12mm replaceable PCB
    order:
    - fl
    - fr
    - rl
    - rr
    count: 4
    switch_body_mm:
    - 6.2
    - 6.2
    - 2
    nominal_operating_force_n: 1.96
    nominal_pretravel_mm: 0.3
    carrier_hard_stop_stroke_mm: 0.8
    adjustable_actuator: true
    return_springs_per_foot: 4
    spring_spec: OD 3.5mm; ID >=2.2mm; free length 4mm; select <=0.1N preload each
      on bench
    contact_only_not_force_sensor: true
    eol_ohm: 10000
    closed_branch_ohm: 1000
    pullup_ohm: 10000
    source: https://omronfs.omron.com/en_US/ecb/products/pdf/en-b3se.pdf
    sole_travel_mm: 0.8
    actuator_gap_mm: 0.2
    pretravel_mm: 0.3
    effective_stiffness_n_m: 6500.0
    damping_n_s_m: 0.3
    sole_moving_mass_kg: 0.006
    scan_hz: 200
    debounce_s: 0.01
  power_allowance_w: 2.5
  mass_allowances_kg:
    camera_with_fpc: 0.01
    depth_with_harness: 0.008
    imu_breakout: 0.004
    collector_with_connector: 0.005
    foot_pcb_switch_wire_each: 0.004
    foot_guides_springs_each: 0.003
    extra_torso_wiring_fasteners: 0.012
    depth_3v3_buck: 0.004
  pi_gpio_bcm:
    uart_tx: 14
    uart_rx: 15
    tof_sda: 2
    tof_scl: 3
    tof_lpn: 17
    tof_interrupt: 27
    lcd_spi_mosi: 10
    lcd_spi_sclk: 11
    lcd_left_cs: 8
    lcd_right_cs: 7
    lcd_dc: 22
    lcd_reset: 23
  xiao_gpio:
    foot_adc_fl: 26
    foot_adc_fr: 27
    foot_adc_rl: 28
    foot_adc_rr: 29
    imu_sda: 6
    imu_scl: 7
    uart_tx: 0
    uart_rx: 1
    imu_interrupt: 2
  gait_policy: v04 actor consumes IMU, binary contact health and 8x8 ToF. RGB is available
    for rendering and later perception; v02 weights are incompatible. New policies
    require training and independent evaluation.
ear_actuator:
  model: STS3032-C001-6V
  mass: 0.02
  voltage: 6
  voltage_range:
  - 4.8
  - 6.0
  stall_torque: 0.4413
  no_load_speed: 11.635
  stall_current: 1.2
  envelope_mm:
  - 23.2
  - 12.1
  - 28.5
  source: https://www.feetechrc.com/Data/feetechrc/upload/file/20200611/6372749220559698399729459.pdf
  mount_status: envelope-only; horn datum requires manufacturer drawing or physical
    fit coupon
  power: separate regulated 6V >=3A rail; never 12V
  regulator:
    model: Pololu D30V30F6
    source: https://www.pololu.com/product/4893/specs
    nominal_output_v: 6
    typical_max_current_a: 3.3
    note: 3.3A is typical at 30V input; verify available current and heating at 3S
      LiFePO4 input
    keepout_mm:
    - 22
    - 18.5
    - 9.5
displays:
  model: Waveshare 1.28inch LCD Module GC9A01
  count: 2
  board_mm:
  - 40.4
  - 37.5
  active_diameter_mm: 32.4
  resolution:
  - 240
  - 240
  interface: SPI with separate CS; shared DC/reset
  source: https://www.waveshare.com/wiki/1.28inch_LCD_Module
  fit_status: 6mm depth budget provisional; board revision must be checked before
    fabrication
actuation:
  assignment:
    fl_hip_roll: SM105BL-C001
    fl_hip_pitch: SM105BL-C001
    fl_knee: SM105BL-C001
    fr_hip_roll: SM105BL-C001
    fr_hip_pitch: SM105BL-C001
    fr_knee: SM105BL-C001
    rl_hip_roll: SM105BL-C001
    rl_hip_pitch: SM105BL-C001
    rl_knee: SM105BL-C001
    rr_hip_roll: SM105BL-C001
    rr_hip_pitch: SM105BL-C001
    rr_knee: SM105BL-C001
    head_yaw: STS3250-12V
    head_pitch: STS3250-12V
    ear_left: STS3032-C001-6V
    ear_right: STS3032-C001-6V
  thermal_time_constant_s: 10.0
  peak_fraction_of_stall: 0.55
  model_status: uncalibrated voltage-speed and I2t thermal surrogate; loaded bench
    identification pending
learning:
  observation_contract: v05-sensor-suite-1
  history_frames: 3
  reward_version: v05-contact-energy-recovery-1
  actor_depth: true
  actor_rgb: false
  depth_resolution:
  - 8
  - 8
  imu_orientation_reset: noisy fused-IMU prior at reset; gyro/accel propagation thereafter;
    no global yaw input
  notes: No world position, root linear velocity, terrain truth, foot forces or true
    body rotation in actor observations.
link_mass_properties:
  torso:
    mass: 2.23178963651774
    com:
    - 0.004778390617013346
    - -0.0001366712221293829
    - -0.002007668505601862
    inertia_matrix:
    - - 0.006282779494014286
      - 2.11835442340433e-05
      - -0.00016094363025062023
    - - 2.11835442340433e-05
      - 0.010200158982151975
      - 2.9128934208523277e-06
    - - -0.00016094363025062023
      - 2.9128934208523277e-06
      - 0.015475640326989516
  fl_roll:
    mass: 0.474059733811006
    com:
    - 0.002859640759884455
    - -6.969887004836332e-05
    - -0.055860586488115954
    inertia_matrix:
    - - 0.0006311824976637611
      - 4.652599048130976e-06
      - -8.697367940983236e-05
    - - 4.652599048130976e-06
      - 0.0006169216532771126
      - 1.5065345941296946e-05
    - - -8.697367940983236e-05
      - 1.5065345941296946e-05
      - 0.00022088292859905682
  fl_thigh:
    mass: 0.5016475672239777
    com:
    - 0.0011212291978539744
    - -0.029943809500431483
    - -0.08610924871461659
    inertia_matrix:
    - - 0.0011296536949100867
      - -3.0338123330645145e-06
      - 1.0188250648857092e-05
    - - -3.0338123330645145e-06
      - 0.0009643656192468918
      - 7.636465633425935e-06
    - - 1.0188250648857092e-05
      - 7.636465633425935e-06
      - 0.0003299361803127838
  fl_shin:
    mass: 0.19139004832181278
    com:
    - 0.000351282480327934
    - -0.019717978847077662
    - -0.03812178853919374
    inertia_matrix:
    - - 0.000511137803407024
      - -1.2084460171950095e-06
      - 5.212169141329712e-06
    - - -1.2084460171950095e-06
      - 0.00034382121070282055
      - 0.00010104937186109628
    - - 5.212169141329712e-06
      - 0.00010104937186109628
      - 0.000198904457499637
  fr_roll:
    mass: 0.4740597338110091
    com:
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
  thigh_front_y_mm: 5.0
  thigh_rear_y_mm: -65.0
  shin_front_y_mm: 11.0
  shin_rear_y_mm: -67.0
  knee_rear_bearing_y_mm: -56.5
  hip_rear_bearing_y_roll_mm: -24.5
  bearing: 6807-2RS 35x47x7
  minimum_design_clearance_mm: 3.0
  status: redesign in progress; no mechanical or physical acceptance
