AlexWortega/Sweetybot2/learning/driver.py

"""Persisted, bounded SweetieMini PPO curriculum orchestration.

Runs only its own sequential children, never manages other host jobs. Every
second since the persisted start (training, evaluation, setup and downtime) is
charged to the budget. Development chooses champions; final held-out seeds are
used exactly once at the end. A champion can still be below the quality gate.
"""
from __future__ import annotations
import argparse
import csv
from datetime import datetime, timezone
import hashlib
import fcntl
import json
import math
import os
from pathlib import Path
import signal
import subprocess
import sys
import time
from typing import Any

TASKS=("locomotion","recovery","running")

def training_surface(task,task_round,profile='baseline',champion=None):
    if task=='recovery':
        from learning.curriculum import recovery_terrain
        return recovery_terrain(task_round,champion)
    cycle=('stairs','flat','mixed','stairs','mixed','slope','steps','mixed') if profile=='navigation-v1' and task=='locomotion' else ('flat','mixed','slope','mixed','steps','mixed')
    terrain=cycle[task_round%len(cycle)]
    return terrain,min(1.,.12+.04*max(0,task_round-1)) if terrain!='flat' else 0.
POLICY_FILES={"locomotion":"walk.pt","recovery":"recover.pt","running":"run.pt"}
MAX_CAMPAIGN_HOURS=200.


def validate_budget(hours: float, chunk_seconds: float):
    """Bound each authorized cycle, including setup, evaluation and GPU waits."""
    if not math.isfinite(hours) or not 0 < hours <= MAX_CAMPAIGN_HOURS:
        raise ValueError(f"Budget must be finite, >0 and <={MAX_CAMPAIGN_HOURS:g}h")
    if not math.isfinite(chunk_seconds) or chunk_seconds <= 0:
        raise ValueError("Chunk seconds must be finite and positive")


def campaign_window(hours, now, prior_seconds=0., start_epoch=None):
    validate_budget(hours,1.)
    if not math.isfinite(prior_seconds) or prior_seconds<0:
        raise ValueError('Prior seconds must be finite and nonnegative')
    if start_epoch is not None and (not math.isfinite(start_epoch) or start_epoch>now or prior_seconds):
        raise ValueError('Campaign start must be finite, in the past, and cannot combine with prior seconds')
    started=start_epoch if start_epoch is not None else now-prior_seconds
    return started,started+hours*3600


def migrate_schedule(state):
    """Extend an existing run without resetting time, checkpoints or history."""
    if state.get('schedule_version',1)<2:
        counts={task:sum(row.get('kind')=='training' and row.get('task')==task
                        and row.get('status')=='completed' for row in state.get('children',[])) for task in TASKS}
        state['completed_chunks_by_task']=counts
        state['schedule_index']=2  # The requested new specialist gets the next slot.
        state['schedule_version']=2
        state.setdefault('migration_log',[]).append({'epoch':time.time(),'reason':'user_requested_running_mode',
            'preserved_deadline_epoch':state['deadline_epoch'],'source_snapshot':str(Path(__file__).resolve().parents[1])})
    for task in TASKS:state.setdefault('consecutive_failures',{}).setdefault(task,0)
    return state


def atomic_json(path: Path, value: Any):
    path.parent.mkdir(parents=True, exist_ok=True)
    temporary = path.with_suffix(path.suffix + ".tmp")
    temporary.write_text(json.dumps(value, indent=2, allow_nan=False) + "\n")
    os.replace(temporary, path)


def sha256(path: Path):
    digest = hashlib.sha256()
    with path.open("rb") as source:
        for block in iter(lambda: source.read(1024 * 1024), b""):
            digest.update(block)
    return digest.hexdigest()


def run_child(command: list[str], log: Path, deadline: float,
              per_child_seconds: float, environment: dict[str, str]):
    """Kill a timed-out process group created by this invocation only."""
    remaining = min(deadline - time.time(), per_child_seconds)
    if remaining <= 0:
        return {"returncode": None, "status": "budget_exhausted", "wall_seconds": 0.0}
    log.parent.mkdir(parents=True, exist_ok=True)
    started = time.monotonic()
    with log.open("a", buffering=1) as stream:
        stream.write(json.dumps({"command": command, "started": datetime.now(timezone.utc).isoformat()}) + "\n")
        child = subprocess.Popen(command, stdout=stream, stderr=subprocess.STDOUT,
                                 env=environment, start_new_session=True)
        try:
            returncode = child.wait(timeout=remaining)
            status = "completed" if returncode == 0 else "failed"
        except (subprocess.TimeoutExpired, KeyboardInterrupt) as exception:
            # child.pid identifies a fresh session/group created immediately above.
            try:
                os.killpg(child.pid, signal.SIGTERM)
            except ProcessLookupError:
                pass
            try:
                child.wait(timeout=min(5.0, max(.01, deadline-time.time())))
            except subprocess.TimeoutExpired:
                try:
                    os.killpg(child.pid, signal.SIGKILL)
                except ProcessLookupError:
                    pass
                child.wait(timeout=5)
            if isinstance(exception, KeyboardInterrupt):
                raise
            returncode, status = child.returncode, "timed_out"
    return {"returncode": returncode, "status": status,
            "wall_seconds": time.monotonic()-started, "log": str(log)}


def _finite(value):
    return isinstance(value, (int, float)) and math.isfinite(value)


def score_development(task: str, results: list[dict[str, Any]]):
    """Fixed ranking; never treat shaped training return as task success."""
    if not results:
        raise ValueError("No development evaluations")
    if task not in TASKS:raise ValueError(f'Unknown task {task}')
    if task == "running":
        survival,linear,yaw,rates,minima,speeds=[],[],[],[],[],[]
        command_survivals=[]
        coverage=True
        for result in results:
            for key in ('survival_fraction','linear_command_rmse','yaw_command_rmse','running_success_rate'):
                if not _finite(result.get(key)):raise ValueError(f'Missing finite running metric {key}')
            survival.append(result['survival_fraction']);linear.append(result['linear_command_rmse'])
            yaw.append(result['yaw_command_rmse']);rates.append(result['running_success_rate'])
            conditions=result.get('per_command',{})
            expected=('forward','fast_forward','run_turn')
            coverage &= all(name in conditions for name in expected)
            for name in expected:
                row=conditions.get(name,{})
                values=(row.get('running_success_rate'),row.get('survival_fraction'),row.get('mean_local_vx'))
                if not all(_finite(v) for v in values):coverage=False;continue
                minima.append(values[0]);speeds.append(values[2]);command_survivals.append(values[1])
                coverage &= values[1]>=.8
        aggregate={'running_success_rate':sum(rates)/len(rates),'worst_command_running_success_rate':min(minima) if minima else None,
            'survival_fraction':sum(survival)/len(survival),'linear_command_rmse':sum(linear)/len(linear),
            'yaw_command_rmse':sum(yaw)/len(yaw),'worst_command_mean_forward_velocity_mps':min(speeds) if speeds else None,
            'command_coverage_complete':bool(coverage),'running_evidence_requires_repeated_flight':True,
            'worst_command_running_survival_fraction':min(command_survivals) if command_survivals else 0.}
        score=2*aggregate['survival_fraction']+2*aggregate['running_success_rate']+(min(minima) if minima else 0)-aggregate['linear_command_rmse']-.1*aggregate['yaw_command_rmse']
        qualified=bool(coverage and minima and speeds and min(survival)>=.8 and min(minima)>=.5
                       and min(speeds)>=.35 and max(linear)<=.20 and max(yaw)<=.5)
    elif task == "locomotion":
        survival, linear, yaw = [], [], []
        nontrivial_motion = False
        command_survivals = []
        command_coverage_complete = True
        expected_commands = {"stand", "forward", "fast_forward", "backward", "sideways", "turn"}
        for result in results:
            for key in ("survival_fraction", "linear_command_rmse", "yaw_command_rmse"):
                if not _finite(result.get(key)):
                    raise ValueError(f"Missing finite development metric {key}")
            survival.append(result["survival_fraction"])
            linear.append(result["linear_command_rmse"])
            yaw.append(result["yaw_command_rmse"])
            conditions = result.get("per_command", {})
            if not isinstance(conditions, dict) or not expected_commands.issubset(conditions):
                command_coverage_complete = False
                conditions = conditions if isinstance(conditions, dict) else {}
            for condition in conditions.values():
                command_survival = condition.get("survival_fraction")
                if _finite(command_survival):
                    command_survivals.append(command_survival)
                else:
                    command_coverage_complete = False
                # Evaluator emits actual body-frame velocity independently of PPO.
                velocity = condition.get("mean_linear_velocity")
                measured_speed = condition.get("measured_speed_mps", condition.get("mean_speed_mps"))
                if isinstance(velocity, (list, tuple)) and len(velocity) >= 2:
                    measured_speed = math.hypot(float(velocity[0]), float(velocity[1]))
                if (_finite(measured_speed) and measured_speed >= .06
                        and _finite(condition.get("command_speed_mps"))
                        and condition["command_speed_mps"] >= .1):
                    nontrivial_motion = True
        aggregate = {"survival_fraction": sum(survival)/len(survival),
                     "linear_command_rmse": sum(linear)/len(linear),
                     "yaw_command_rmse": sum(yaw)/len(yaw),
                     "nontrivial_motion": nontrivial_motion,
                     "command_coverage_complete": command_coverage_complete,
                     "worst_command_survival_fraction": min(command_survivals) if command_survivals else None}
        score = 2*aggregate["survival_fraction"]-aggregate["linear_command_rmse"]-.1*aggregate["yaw_command_rmse"]
        qualified = (min(survival) >= .6 and max(linear) <= .25 and max(yaw) <= .5
                     and nontrivial_motion and command_coverage_complete
                     and bool(command_survivals) and min(command_survivals) >= .6)
    else:
        rates, minima = [], []
        for result in results:
            if not _finite(result.get("recovery_success_rate")):
                raise ValueError("Missing recovery_success_rate")
            rates.append(result["recovery_success_rate"])
            orientations = result.get("per_orientation", {})
            expected = [orientations.get(name, {}).get("success_rate") for name in ("folded_crouch", "left", "right", "supine")]
            if not all(_finite(x) for x in expected):
                raise ValueError("Recovery evaluation must report all four orientations")
            minima.append(min(expected))
        aggregate = {"recovery_success_rate": sum(rates)/len(rates),
                     "worst_orientation_success_rate": min(minima),
                     "per_orientation_success_rate":{name:sum(r['per_orientation'][name]['success_rate'] for r in results)/len(results)
                        for name in ('folded_crouch','left','right','supine')}}
        score = aggregate["recovery_success_rate"]+aggregate["worst_orientation_success_rate"]
        qualified = min(minima) >= .5
    # Manufacturer rated torque is a continuous-load engineering screen,
    # not a calibrated thermal model or evidence of physical validation.
    torque_values = []
    torque_complete = True
    normalized_torque=[]
    for result in results:
        reported = result.get("rms_joint_torque_nm")
        values = reported if isinstance(reported, (list, tuple)) else [reported]
        if not values or not all(_finite(value) and value >= 0 for value in values):
            torque_complete = False
        else:
            torque_values.extend(values)
            limits=result.get("continuous_torque_limits_nm",[])
            if len(limits)!=len(values) or not all(_finite(x) and x>0 for x in limits):torque_complete=False
            else:normalized_torque.extend(v/limit for v,limit in zip(values,limits))
    observed_max = max(torque_values) if torque_values else None
    torque_gate = torque_complete and observed_max is not None and bool(normalized_torque) and max(normalized_torque)<=1.
    aggregate.update(max_observed_rms_joint_torque_nm=observed_max,
                     max_normalized_rms_joint_torque=max(normalized_torque) if normalized_torque else None,
                     torque_screen="per-joint rated point, conservatively low-voltage derated; thermal surrogate separately enforced",
                     torque_gate_passed=bool(torque_gate),
                     torque_screen_physical_thermal_validation=False)
    collision_gate=all(_finite(r.get('self_contact_fraction')) and r['self_contact_fraction']==0 for r in results)
    aggregate['self_collision_gate_passed']=bool(collision_gate)
    qualified = qualified and torque_gate and collision_gate
    return float(score), bool(qualified), aggregate


def regresses(score: float, qualified: bool, champion: dict[str, Any] | None):
    """Historical regression diagnostic; never used to rewind training."""
    return champion is not None and (
        score < champion["score"]-.10
        or (champion["quality_gate_passed"] and not qualified))


def apply_selection(state,task,selection):
    """Continue the valid training chain independently of champion promotion."""
    old=state['champions'].get(task)
    qualified=selection['quality_gate_passed']
    promote_candidate=(old is None or
        (qualified and not old['quality_gate_passed']) or
        (qualified==old['quality_gate_passed'] and selection['score']>old['score']))
    state['latest_training'][task]=selection['checkpoint']
    selection.update(discarded_for_resume=False,continued_training=True,
                     promoted_to_champion=promote_candidate,
                     regressed_against_champion=regresses(selection['score'],qualified,old))
    if promote_candidate:state['champions'][task]=selection
    return promote_candidate


def promote(checkpoint: Path, link: Path):
    """Point the playback entry to the scored champion, never the latest run."""
    temporary = link.with_name(link.name + ".tmp")
    if temporary.exists() or temporary.is_symlink():
        temporary.unlink()
    temporary.symlink_to(checkpoint.resolve())
    os.replace(temporary, link)


def select_gpu(gpus: list[dict[str, Any]], preferred: str, minimum_free_mib: float = 3072.):
    """Pure capacity selection: preserve other jobs and fall back to CPU."""
    available = [gpu for gpu in gpus
                 if _finite(gpu.get("memory_free_mib"))
                 and gpu["memory_free_mib"] >= minimum_free_mib
                 and _finite(gpu.get("utilization_percent"))]
    preferred = preferred.split(",")[0].strip()
    selected = next((gpu for gpu in available if str(gpu["index"]) == preferred), None)
    reason = "preferred_gpu_has_capacity"
    if selected is None and available:
        selected = min(available, key=lambda gpu: (gpu["utilization_percent"],
                       -gpu["memory_free_mib"], str(gpu["index"])))
        reason = "alternate_gpu_has_capacity"
    if selected is None:
        return {"device": "cpu", "physical_gpu": None,
                "reason": "no_gpu_with_3072_mib_free", "capacity_snapshot": gpus}
    return {"device": "cuda:0", "physical_gpu": str(selected["index"]),
            "reason": reason, "capacity_snapshot": gpus}


def capacity_guard(preferred: str, requested_device: str, environment: dict[str, str]):
    if requested_device == "cpu":
        return {"device": "cpu", "physical_gpu": None,
                "reason": "explicit_cpu_requested", "capacity_snapshot": []}
    try:
        response = subprocess.run(["nvidia-smi", "--query-gpu=index,memory.free,utilization.gpu",
                                   "--format=csv,noheader,nounits"],
                                  capture_output=True, text=True, timeout=10, env=environment)
        if response.returncode:
            raise RuntimeError(f"nvidia-smi return code {response.returncode}: {response.stderr.strip()}")
        gpus = []
        for row in csv.reader(response.stdout.splitlines()):
            if not row:
                continue
            if len(row) != 3:
                raise ValueError("Malformed nvidia-smi capacity response")
            gpus.append({"index": row[0].strip(), "memory_free_mib": float(row[1]),
                         "utilization_percent": float(row[2])})
        return select_gpu(gpus, preferred)
    except (OSError, ValueError, RuntimeError, subprocess.TimeoutExpired) as error:
        return {"device": "cpu", "physical_gpu": None,
                "reason": "gpu_capacity_query_failed", "error": str(error), "capacity_snapshot": []}


def preflight(environment: dict[str, str]):
    result = {"timestamp": datetime.now(timezone.utc).isoformat(),
              "hostname": os.uname().nodename, "pid": os.getpid(),
              "cuda_visible_devices": environment["CUDA_VISIBLE_DEVICES"],
              "task_local_caches": {name: environment.get(name) for name in
                                    ("TMPDIR", "XDG_CACHE_HOME", "CUDA_CACHE_PATH", "TORCH_HOME")},
              "python": sys.executable, "other_processes_preserved": True}
    for name, command in (
        ("gpus", ["nvidia-smi", "--query-gpu=index,uuid,name,driver_version,memory.total,memory.used,utilization.gpu", "--format=csv"]),
        ("compute_processes", ["nvidia-smi", "--query-compute-apps=gpu_uuid,pid,process_name,used_memory", "--format=csv"]),
    ):
        try:
            check = subprocess.run(command, capture_output=True, text=True, timeout=10, env=environment)
            result[name] = {"returncode": check.returncode, "stdout": check.stdout, "stderr": check.stderr}
        except (OSError, subprocess.TimeoutExpired) as error:
            result[name] = {"error": str(error)}
    return result


def main():
    parser = argparse.ArgumentParser(description=__doc__)
    parser.add_argument("--out", required=True)
    parser.add_argument("--hours", type=float, default=24)
    parser.add_argument("--prior-seconds", type=float, default=0,
                        help="Charge preceding pilot/setup/evaluation wall time to the same total budget")
    parser.add_argument('--budget-start-epoch',type=float,help='Preserve an already authorized campaign start/deadline across a recipe handoff')
    parser.add_argument('--start-task',choices=TASKS,default='locomotion')
    parser.add_argument('--recovery-teacher',help='Matching v05 walking checkpoint; near-upright recovery anchor only')
    parser.add_argument('--curriculum-horizon-steps',type=int,default=50_000)
    parser.add_argument("--initial-walk", help="Own pilot checkpoint for locomotion warm start; not automatically a champion")
    parser.add_argument("--initial-recover", help="Own pilot checkpoint for recovery warm start; not automatically a champion")
    parser.add_argument('--initial-run',help='Matching running bootstrap checkpoint; evaluated before training')
    parser.add_argument("--chunk-seconds", type=float, default=1200)
    parser.add_argument("--eval-seconds", type=float, default=12)
    parser.add_argument("--eval-timeout", type=float, default=300)
    parser.add_argument("--final-reserve-seconds", type=float, default=1200)
    parser.add_argument("--nenvs", type=int, default=128)
    parser.add_argument("--threads", type=int, default=16)
    parser.add_argument("--cuda-visible-devices", default="1")
    parser.add_argument("--device", default="cuda:0")
    parser.add_argument("--require-gpu", action="store_true", help="Wait for an idle GPU instead of silently falling back to CPU; wait counts against wall budget")
    parser.add_argument("--seed", type=int, default=37)
    parser.add_argument('--observation-mode',choices=('compact','legacy'),default='compact')
    parser.add_argument('--teacher-source',help='Verified source for a frozen legacy walking teacher')
    parser.add_argument('--bootstrap-episodes',type=int,default=8,
                        help='Replicates per fixed condition for the initial baseline only; training development/final remain 8')
    parser.add_argument('--speed-profile',choices=('baseline','higher-v1','navigation-v1'),default='baseline')
    parser.add_argument('--initial-speed-stage',type=int,choices=(0,1,2),default=0,help='Carry an already unlocked ceiling across an explicit recipe handoff')
    args = parser.parse_args()
    if not 1<=args.bootstrap_episodes<=8:raise ValueError('Bootstrap replicates must be between 1 and 8')
    from learning.readiness import require_training_ready,dynamics_signature
    require_training_ready()
    if args.require_gpu and args.device=='cpu':raise ValueError('--require-gpu cannot be combined with --device cpu')
    validate_budget(args.hours, args.chunk_seconds)
    campaign_started,campaign_deadline=campaign_window(args.hours,time.time(),args.prior_seconds,args.budget_start_epoch)
    if not 1 <= args.threads <= 16:
        raise ValueError("CPU worker cap is 16")
    out = Path(args.out).resolve()
    out.mkdir(parents=True, exist_ok=True)
    # Keep one orchestrator per output tree, including across accidental launches.
    lock = (out / "driver.lock").open("a+")
    try:
        fcntl.flock(lock, fcntl.LOCK_EX | fcntl.LOCK_NB)
    except BlockingIOError:
        raise RuntimeError("Another driver already owns this output directory")
    def handle_termination(signum, frame):
        raise KeyboardInterrupt(f"Driver received signal {signum}")
    signal.signal(signal.SIGTERM, handle_termination)
    state_path = out / "status.json"
    from hardware.policy_observation import CONTRACT as COMPACT_CONTRACT
    expected_contract=COMPACT_CONTRACT if args.observation_mode=='compact' else 'v05-sensor-suite-1'
    if state_path.exists():
        state = json.loads(state_path.read_text())
        if state.get("observation_contract")!=expected_contract:raise ValueError("Actor contract changed; use a fresh output directory")
        if state.get('dynamics_signature')!=dynamics_signature():raise ValueError('Recipe changed; use a fresh output and explicit weights-only transfer')
        if state.get("complete"):
            print("This driver already completed; choose another output for another authorized run.")
            return
        if abs(state["budget_hours"]-args.hours) > 1e-9:
            raise ValueError("A persisted run cannot silently change its budget")
        if args.budget_start_epoch is not None and abs(state['started_epoch']-args.budget_start_epoch)>.001:
            raise ValueError('A persisted campaign cannot change its start/deadline')
    else:
        started = campaign_started
        warm_starts={}
        for task,checkpoint in (("locomotion",args.initial_walk),("recovery",args.initial_recover),('running',args.initial_run)):
            if checkpoint:
                path=Path(checkpoint).resolve()
                if not path.is_file():raise FileNotFoundError(path)
                from learning.ppo import _safe_load
                seed_metadata=_safe_load(path,'cpu').get('environment_metadata',{})
                if seed_metadata.get('observation_contract')!=expected_contract:
                    raise ValueError('Bootstrap actor contract differs; distill into the compact policy first')
                if seed_metadata.get('dynamics_signature')!=dynamics_signature():
                    raise ValueError('Bootstrap source differs; use explicit verified transfer first')
                warm_starts[task]=str(path)
        from learning.env import SweetieVecEnv
        state = {"dynamics_signature":dynamics_signature(), "observation_contract":expected_contract, "reward_version":SweetieVecEnv.reward_version, "started_epoch": started, "deadline_epoch": campaign_deadline,
                 "initial_prior_seconds": args.prior_seconds,
                 "budget_hours": args.hours, "complete": False,
                 "round": 0, "children": [], "latest_training": warm_starts,
                 'final_seed_base':5_000_000 if args.observation_mode=='compact' else 4_000_000,
                 "champions": {}, "consecutive_failures": {"locomotion": 0, "recovery": 0},
                 "final_started": False, "config": vars(args)}
        state.update(schedule_version=2,schedule_index=TASKS.index(args.start_task),completed_chunks_by_task={task:0 for task in TASKS})
        atomic_json(state_path, state)
    migrate_schedule(state)
    state['runtime_config']=vars(args)
    state['runtime_source_snapshot']=str(Path(__file__).resolve().parents[1])
    state['selection_policy']='independent_latest_and_champion_v1'
    if state.get('speed_profile','baseline')!=args.speed_profile:
        state.setdefault('migration_log',[]).append({'epoch':time.time(),'reason':'user_requested_higher_target_speed','profile':args.speed_profile})
    state['speed_profile']=args.speed_profile
    state.setdefault('speed_stage',args.initial_speed_stage)
    state.pop('stop_reason',None)
    deadline = state["deadline_epoch"]
    environment = dict(os.environ)
    environment.update(CUDA_VISIBLE_DEVICES=args.cuda_visible_devices,
                       OMP_NUM_THREADS=str(args.threads), OPENBLAS_NUM_THREADS="2",
                       MKL_NUM_THREADS="2", MUJOCO_GL="egl", PYTHONUNBUFFERED="1")
    cache_root = Path(__file__).resolve().parents[1] / ".run-cache"
    for variable, relative in (("TMPDIR", "tmp"), ("XDG_CACHE_HOME", "xdg"),
                               ("CUDA_CACHE_PATH", "cuda"), ("TORCH_HOME", "torch")):
        directory = cache_root / relative
        directory.mkdir(parents=True, exist_ok=True)
        environment[variable] = str(directory)
    atomic_json(out / f"preflight_{int(time.time())}.json", preflight(environment))

    def persist(phase):
        now = time.time()
        state["phase"] = phase
        state["updated_epoch"] = now
        state["charged_wall_seconds"] = max(0, now-state["started_epoch"])
        state["remaining_seconds"] = max(0, deadline-now)
        atomic_json(state_path, state)
        atomic_json(out / "budget.json", {key: state[key] for key in (
            "budget_hours", "started_epoch", "deadline_epoch", "charged_wall_seconds", "remaining_seconds")})

    def evaluate(task, checkpoint, directory, terrain, seed, final=False,episodes=8,speed_challenge=None):
        directory.mkdir(parents=True, exist_ok=True)
        command = [sys.executable, "-m", "learning.evaluate", "--checkpoint", str(checkpoint),
                   "--out", str(directory), "--task", task, "--terrain", terrain,
                   "--difficulty", "1.0" if final else ".2", "--episodes", str(episodes),
                   "--seconds", str(min(8.,args.eval_seconds) if speed_challenge is not None else args.eval_seconds), "--seed", str(seed),
                   "--threads", str(min(8, args.threads))]
        if speed_challenge is not None:command.extend(('--speed-challenge',str(speed_challenge)))
        result = run_child(command, directory / "process.log", deadline,
                           args.eval_timeout, environment)
        state["children"].append({"kind": "final" if final else "development", "task": task, "terrain": terrain, **result})
        persist("final_evaluation" if final else "development_evaluation")
        output = directory / "result.json"
        if result["status"] != "completed" or not output.exists():
            raise RuntimeError(f"{task}/{terrain} evaluation {result['status']}")
        return json.loads(output.read_text())

    def evaluate_navigation(checkpoint,directory,seed,final=False,episodes=2):
        directory.mkdir(parents=True,exist_ok=True)
        output=directory/'result.json'
        command=[sys.executable,'-m','learning.evaluate_navigation','--checkpoint',str(checkpoint),
                 '--out',str(output),'--episodes',str(episodes),'--seconds','12',
                 '--difficulty','1.' if final else '.2','--seed',str(seed)]
        result=run_child(command,directory/'process.log',deadline,args.eval_timeout,environment)
        state['children'].append({'kind':'navigation_final' if final else 'navigation_development',**result})
        persist('navigation_evaluation')
        if result['status']!='completed' or not output.exists():raise RuntimeError('Navigation evaluation '+result['status'])
        return json.loads(output.read_text())

    def run_final_once():
        if state.get("final_started"):
            # Never repeatedly query the independent held-out set on restart.
            return
        state["final_started"] = True
        persist("final_evaluation")
        finals = {}
        atomic_json(out / "final_results.json", finals)
        for task, champion in state["champions"].items():
            finals[task] = {}
            for index, terrain in enumerate(("flat", "rough", "slope", "steps")):
                if time.time() >= deadline:
                    finals[task][terrain] = {"status": "budget_exhausted"}
                    continue
                try:
                    finals[task][terrain] = evaluate(task, Path(champion["checkpoint"]), out / "final" / task / terrain,
                                                     terrain, state.get('final_seed_base',4_000_000)+index, final=True)
                except Exception as error:
                    finals[task][terrain] = {"status": "failed", "error": str(error)}
                atomic_json(out / "final_results.json", finals)
        if args.speed_profile=='navigation-v1' and state['latest_training'].get('locomotion'):
            checkpoint=state.get('navigation_champion',{}).get('checkpoint',state['latest_training']['locomotion'])
            try:finals['navigation']=evaluate_navigation(checkpoint,out/'final/navigation',5_500_000,final=True,episodes=8)
            except Exception as error:finals['navigation']={'status':'failed','error':str(error)}
            atomic_json(out/'final_results.json',finals)
        state["final_results"] = str(out / "final_results.json")

    persist("starting")
    try:
        # Score transferred policies under the CURRENT recipe before training.
        # This retains a qualified walking baseline in the same promotion gate.
        if not state.get('bootstrap_evaluated'):
            for task,checkpoint in state['latest_training'].items():
                directory=out/'baseline'/task
                evaluations=[evaluate(task,Path(checkpoint),directory/surface,surface,1_000_000+offset,episodes=args.bootstrap_episodes)
                             for offset,surface in enumerate(('flat','rough','slope','steps'))]
                score,qualified,metrics=score_development(task,evaluations)
                selection={'score':score,'quality_gate_passed':qualified,'metrics':metrics,
                           'checkpoint':checkpoint,'checkpoint_sha256':sha256(Path(checkpoint)),
                           'round':-1,'baseline':True}
                state['champions'][task]=selection
                atomic_json(directory/'selection.json',selection)
                promote(Path(checkpoint),out/POLICY_FILES[task])
                persist('bootstrap_evaluation')
            if args.speed_profile=='navigation-v1' and state['latest_training'].get('locomotion'):
                state['navigation_baseline']=evaluate_navigation(state['latest_training']['locomotion'],out/'baseline/navigation',1_700_000,episodes=args.bootstrap_episodes)
            state['bootstrap_evaluated']=True
            persist('between_chunks')
        while True:
            # Reserve independent final evaluation plus all development surfaces.
            remaining = deadline-time.time()
            spare = remaining-args.final_reserve_seconds-(5 if args.speed_profile=='navigation-v1' else 4)*args.eval_timeout-30
            if spare < 30:
                state["stop_reason"] = "reserved_final_evaluation_budget"
                break
            selection_device = capacity_guard(args.cuda_visible_devices, args.device, environment)
            if args.require_gpu and selection_device['physical_gpu'] is None:
                state['gpu_wait']=selection_device
                persist('waiting_for_gpu')
                time.sleep(min(30.,max(.01,deadline-time.time())))
                continue
            round_index = state["round"]
            available=[TASKS[(state['schedule_index']+offset)%len(TASKS)] for offset in range(len(TASKS))
                       if state['consecutive_failures'][TASKS[(state['schedule_index']+offset)%len(TASKS)]]<3]
            if not available:
                state['stop_reason']='all_tasks_failed_three_consecutive_chunks';break
            task=available[0]
            # Both specialists bootstrap on flat, then visit every procedural
            # surface with flat consolidation between successive terrain cycles.
            task_round = state['completed_chunks_by_task'][task]
            terrain,difficulty=training_surface(task,task_round,args.speed_profile,state['champions'].get(task))
            seed = (args.seed+round_index*7919) % 1_000_000
            directory = out / "runs" / f"{round_index:04d}_{task}_{terrain}"
            if directory.exists():
                # Preserve artifacts left by an interrupted attempt at this round.
                directory = directory.with_name(directory.name + f"_retry_{time.time_ns()}")
            directory.mkdir(parents=True, exist_ok=True)
            seconds = min(args.chunk_seconds, spare)
            chunk_environment = dict(environment)
            chunk_environment["CUDA_VISIBLE_DEVICES"] = selection_device["physical_gpu"] or ""
            command = [sys.executable, "-m", "learning.ppo", "--task", task,
                       "--out", str(directory), "--nenvs", str(args.nenvs),
                       "--threads", str(args.threads), "--seconds", str(seconds),
                       "--seed", str(seed), "--device", selection_device["device"],
                       "--terrain", terrain, "--difficulty", str(difficulty),
                       '--observation-mode',args.observation_mode,
                       '--curriculum-horizon-steps',str(args.curriculum_horizon_steps),
                       "--gpu-memory-gib", "2", "--save-interval", "60"]
            command.extend(('--speed-profile',args.speed_profile,'--speed-stage',str(state['speed_stage'])))
            if task=='recovery' and args.recovery_teacher:
                command.extend(('--recovery-teacher',args.recovery_teacher))
                if args.teacher_source:command.extend(('--teacher-source',args.teacher_source))
            if task=='recovery':
                from learning.curriculum import recovery_progress_cap
                command.extend(('--curriculum-progress-cap',str(recovery_progress_cap(state['champions'].get(task)))))
            if task in state["latest_training"]:
                command.extend(("--resume", state["latest_training"][task]))
            elif task=='running':
                donor=state['champions'].get('locomotion',{}).get('checkpoint') or state['latest_training'].get('locomotion')
                if donor:command.extend(('--initialize-from',donor))
            resume_before_chunk=state['latest_training'].get(task)
            state["active_run"] = {"round": round_index, "task": task, "terrain": terrain,
                                   "directory": str(directory), "seconds": seconds,
                                   'resume_checkpoint':resume_before_chunk,
                                   "selected_device": selection_device}
            state['active_run'].update(speed_profile=args.speed_profile,speed_stage=state['speed_stage'])
            persist("training")
            result = run_child(command, directory / "process.log", deadline,
                               seconds+300, chunk_environment)
            state["children"].append({"kind": "training", "round": round_index, "task": task,
                                      "selected_device": selection_device, **result})
            checkpoint = directory / "latest.pt"
            valid_training=False
            try:
                if result["status"] != "completed" or not checkpoint.exists():
                    raise RuntimeError(f"Training {result['status']}")
                state['completed_chunks_by_task'][task]+=1
                valid_training=True
                state['consecutive_failures'][task]=0
                # Latest may be resumed even if it does not beat the champion.
                state["latest_training"][task] = str(checkpoint)
                evaluations = [evaluate(task, checkpoint, directory / "development" / surface,
                                         surface, 1_000_000+offset)
                               for offset, surface in enumerate(("flat", "rough", "slope", "steps"))]
                score, qualified, metrics = score_development(task, evaluations)
                if task=='running' and args.speed_profile in ('higher-v1','navigation-v1'):
                    from learning.speed_profile import run_ceiling,speed_stage_ready
                    ceiling=run_ceiling(state['speed_stage'])
                    probe=evaluate(task,checkpoint,directory/'speed_challenge','flat',1_500_000+round_index,speed_challenge=ceiling)
                    ready=speed_stage_ready(metrics,probe)
                    state.setdefault('speed_progress',[]).append({'round':round_index,'ceiling_mps':ceiling,'passed':ready,'probe':str(directory/'speed_challenge/result.json')})
                    if ready:state['speed_stage']=min(2,state['speed_stage']+1)
                selection = {"score": score, "quality_gate_passed": qualified,
                             "metrics": metrics, "checkpoint": str(checkpoint),
                             "checkpoint_sha256": sha256(checkpoint), "round": round_index}
                if task=='locomotion' and args.speed_profile=='navigation-v1':
                    navigation=evaluate_navigation(checkpoint,directory/'navigation',1_700_000+round_index*16)
                    selection['navigation_quality_gate_passed']=navigation['all_passed']
                    entry=dict(checkpoint=str(checkpoint),round=round_index,all_passed=navigation['all_passed'],
                               success_rate=sum(r['success_rate'] for r in navigation['cases'])/len(navigation['cases']))
                    state['navigation_latest']=entry
                    if entry['success_rate']>state.get('navigation_champion',{}).get('success_rate',-1):state['navigation_champion']=entry
                atomic_json(directory / "selection.json", selection)
                if apply_selection(state,task,selection):
                    promote(checkpoint, out / POLICY_FILES[task])
                atomic_json(directory / "selection.json", selection)
                state["consecutive_failures"][task] = 0
            except Exception as error:
                # Failed evaluation does not invalidate a successful PPO chunk.
                # Only failed workers rewind to the previous training checkpoint.
                rollback=None
                if not valid_training:
                    state["consecutive_failures"][task] += 1
                    rollback=resume_before_chunk
                    if rollback:state["latest_training"][task]=rollback
                    else:state["latest_training"].pop(task,None)
                atomic_json(directory / "failure.json", {"error": str(error), "training": result,
                            "discarded_for_resume":not valid_training,
                            'stage':'evaluation' if valid_training else 'training',
                            "resume_rollback_checkpoint": rollback})
            state["round"] += 1
            state['schedule_index']=(TASKS.index(task)+1)%len(TASKS)
            persist("between_chunks")
        run_final_once()
        state["complete"] = True
        persist("complete")
    except KeyboardInterrupt:
        state["stop_reason"] = "user_interrupted"
        persist("interrupted")
        raise
    finally:
        persist(state.get("phase", "stopped"))
    print(json.dumps({"status": state["phase"], "rounds": state["round"],
                      "champions": state["champions"], "out": str(out)}, indent=2))


if __name__ == "__main__":
    main()
