AlexWortega/Sweetybot2/simulation/model.py

"""Shared SI link graph for CAD placements, URDF and MuJoCo. +X muzzle, +Y left, +Z up."""
from __future__ import annotations
import math
import numpy as np
from scripts.common import load, joint_names,actuator

COLORS={'body':[0.93,0.94,0.98,1], 'mane':[0.60,0.36,0.76,1], 'hoof':[0.25,0.20,0.36,1],
        'frame':[0.25,0.32,0.40,1], 'servo':[0.14,0.17,0.20,1], 'eye':[0.1,0.08,0.19,1], 'iris':[0.22,0.88,0.32,1], 'pink':[0.91,0.57,0.74,1]}

def geometry(kind, size, pos=(0,0,0), color='body', collision=True, **kwargs):
    return dict(kind=kind,size=list(size),pos=list(pos),color=color,collision=collision,**kwargs)

def graph(c=None):
    c=c or load(); g=c['geometry']; mass=c['mass']; a=c['actuator_candidates'][c['selection']['selected']]; s=a['mass']
    mm=lambda v:[x/1000 for x in v]
    links=[]
    def link(name,parent,origin,joint,m,com,size,geoms):
        # Box-envelope inertias with explicit COM; conservative mass allocations.
        x,y,z=size; inertia=[m*(y*y+z*z)/12,m*(x*x+z*z)/12,m*(x*x+y*y)/12]
        p=c.get('link_mass_properties',{}).get(name)
        if p:
            m=p['mass'];com=p['com'];I=p['inertia_matrix'];inertia=[I[i][i] for i in range(3)]
        else:I=np.diag(inertia).tolist()
        d=dict(name=name,parent=parent,origin=origin,joint=joint,mass=m,com=com,inertia=inertia,inertia_matrix=I,geoms=geoms)
        links.append(d);return d
    torso=link('torso',None,[0,0,0],None,mass['torso_without_servos']+4*actuator(c,'fl_hip_roll')['mass']+actuator(c,'head_yaw')['mass'],[-.014,0,0],mm(g['body']),[
      geometry('ellipsoid',mm([v/2 for v in g['body']]),color='body'),
      geometry('ellipsoid',[.017,.018,.045],[-.108,0,.015],'mane',False),
      geometry('ellipsoid',[.013,.019,.020],[-.108,0,-.018],'mane',False)])
    for leg,sgn in c['legs'].items():
        sx=sgn['x_sign'];side=sgn['y_sign'];R=np.array([[0,sx,0],[-side,0,0],[0,0,side*sx]])
        torso['geoms'].append(geometry('box',mm((np.abs(R)@np.array([46.5,34,28.5])).tolist()),mm((np.array([sx*g['hip_x'],side*g['hip_y'],0])+R@np.array([11.75,-19.5,0])).tolist()),'servo'))
        side=sgn['y_sign']; origin=[sgn['x_sign']*g['hip_x']/1000,side*g['hip_y']/1000,0]
        link(leg+'_roll','torso',origin,leg+'_hip_roll',mass['roll_link_without_servo']+actuator(c,'fl_hip_pitch')['mass'],[0,0,-(g['hip_drop']+6)/1000],[.050,.065,(g['hip_drop']+50)/1000],[
          geometry('box',[.0335,.044,.0585],[0,side*(g['abduction_offset']-24.55)/1000,-(g['hip_drop']+9.5)/1000],'servo')])
        link(leg+'_thigh',leg+'_roll',[0,side*g['abduction_offset']/1000,-g['hip_drop']/1000],leg+'_hip_pitch',mass['thigh_without_servo']+actuator(c,'fl_knee')['mass'],[0,-side*.019,-g['thigh']/1000*.70],[.032,.054,(g['thigh']+24)/1000],[
          geometry('capsule',[.012,g['thigh']/1000],[0,0,0],'frame',True,end=[0,0,-g['thigh']/1000]),
          geometry('box',[.0335,.044,.0585],[0,-side*.02455,(-g['thigh']+9.5)/1000],'servo')])
        link(leg+'_shin',leg+'_thigh',[0,0,-g['thigh']/1000],leg+'_knee',mass['shin_and_foot'],[0,-side*.004,-g['shin']/1000*.60],[.036,.058,(g['shin']+30)/1000],[
          geometry('capsule',[.010,g['shin']/1000],[0,0,0],'body',True,end=[0,0,-g['shin']/1000]),
          geometry('box',[.034,.034,.024],[0,0,-g['shin']/1000-.004],'body')])
    for leg,sgn in c['legs'].items():
        side=sgn['y_sign']
        thigh=next(l for l in links if l['name']==leg+'_thigh');thigh['geoms'].append(geometry('box',[.038,.003,(g['thigh']+36)/1000],[0,-side*.0601,-g['thigh']/2000],'frame'))
        shin=next(l for l in links if l['name']==leg+'_shin')
        for z1,z2,y1,y2 in [(18,-25,-54.1,-54.1),(-25,-70,-54.1,-5),(-70,-g['shin']-8,-5,-5)]:
            dy=side*(y2-y1);dz=z2-z1;angle=math.atan2(dy,-dz)
            shin['geoms'].append(geometry('box',[.016 if z1==-70 else .038,.003,math.hypot(dy,dz)/1000],[0,side*(y1+y2)/2000,(z1+z2)/2000],'frame',quat=[math.cos(angle/2),math.sin(angle/2),0,0]))
    link('neck_yaw','torso',mm(g['head_origin']),'head_yaw',mass['head_yaw_without_servo']+actuator(c,'head_pitch')['mass'],[0,0,.026],[.060,.064,.060],[geometry('box',[.050,.056,.054],[0,0,.027],'body')])
    link('head','neck_yaw',[0,0,g['neck_pitch_rise']/1000],'head_pitch',mass['head_without_servos']+2*c['ear_actuator']['mass'],[.030,0,.035],[.11,.09,.10],[
      geometry('ellipsoid',[.046,.043,.043],[.032,0,.052],'body'),
      geometry('ellipsoid',[.029,.030,.020],[.073,0,.030],'body'),
      geometry('ellipsoid',[.025,.017,.028],[.053,.037,.041],'eye',False),
      geometry('ellipsoid',[.025,.017,.028],[.053,-.037,.041],'eye',False),
      geometry('ellipsoid',[.014,.006,.020],[.058,.051,.041],'iris',False),
      geometry('ellipsoid',[.014,.006,.020],[.058,-.051,.041],'iris',False),
      geometry('ellipsoid',[.020,.036,.041],[-.004,0,.055],'mane',False),
      geometry('capsule',[.005,.022],[.040,0,.090],'body',True,end=[.040,0,.112])])
    for name,side in [('ear_left',1),('ear_right',-1)]:
        o=g['ear_origin']; origin=mm([o[0],side*o[1],o[2]])
        link(name,'head',origin,name,mass['ear_without_servo'],[0,side*.004,.040],mm(g['ear_size']),[
          geometry('ellipsoid',[.008,.013,.024],[0,side*.006,.051],'body'),
          geometry('ellipsoid',[.008,.003,.016],[.007,0,.021],'mane',False)])
    return links

def joint_spec(name,c):
    kind='ear' if name.startswith('ear_') else name.removeprefix(name.split('_')[0]+'_') if name.split('_')[0] in c['legs'] else name
    spec=dict(c['joints'][kind])
    if kind=='hip_roll' and spec.get('mirror_limits_by_side') and c['legs'][name.split('_')[0]]['y_sign']<0:
        spec['limits']=[-spec['limits'][1],-spec['limits'][0]]
    if kind in ('hip_pitch','knee') and c['legs'][name.split('_')[0]]['x_sign']<0:spec['axis']=[0,-1,0]
    return spec

def rotation(axis,angle):
    a=np.array(axis,dtype=float);a/=np.linalg.norm(a)
    K=np.array([[0,-a[2],a[1]],[a[2],0,-a[0]],[-a[1],a[0],0]])
    return np.eye(3)+math.sin(angle)*K+(1-math.cos(angle))*(K@K)

def fk(links,q=None,c=None):
    c=c or load();q=q or {}; mats={}
    for l in links:
        t=np.eye(4);t[:3,3]=l['origin']
        if l['joint']:t[:3,:3]=rotation(joint_spec(l['joint'],c)['axis'],q.get(l['joint'],0))
        mats[l['name']]=(mats[l['parent']]@t) if l['parent'] else t
    return mats

def ik(foot,side,c=None):
    c=c or load();g=c['geometry']; x,y,z=foot
    a=side*g['abduction_offset']/1000; l1=g['thigh']/1000;l2=g['shin']/1000
    h2=y*y+z*z-a*a
    if h2<=0:raise ValueError('Foot inside roll-offset cylinder')
    htotal=math.sqrt(h2);roll=math.atan2(y,-z)-math.atan2(a,htotal);h=htotal-g['hip_drop']/1000
    v=(x*x+h*h-l1*l1-l2*l2)/(2*l1*l2)
    if not -1-1e-8<=v<=1+1e-8:raise ValueError(f'Unreachable foot {foot}: cosine={v}')
    knee=math.acos(float(np.clip(v,-1,1)));hip=math.atan2(-x,h)-math.atan2(l2*math.sin(knee),l1+l2*math.cos(knee))
    return np.array([roll,hip,knee])

def home(c=None):
    c=c or load();g=c['geometry'];q={n:0.0 for n in joint_names(c)}
    for leg,s in c['legs'].items():
        qs=ik([0,s['y_sign']*g['abduction_offset']/1000,-g['stance_height']/1000],s['y_sign'],c)
        q.update(zip([leg+'_'+j for j in ('hip_roll','hip_pitch','knee')],qs))
    return q
