AlexWortega/Sweetybot2/(commit log)

2026-10-17 Publish Sweetybot2 v02 CAD, MuJoCo policies and training previews
2026-10-17 Clarify that the full CAD release includes the assembled GLB
2026-10-17 Preview a narrower, shorter lower muzzle as a separate CAD candidate
2026-10-17 Add v03 face and sensor hardware candidate with compact ear servos
2026-10-18 Build v04 stronger servo chassis with sampled sensors and revised policy rewards
2026-10-18 Keep release assets current and ignore runtime diagnostics
2026-10-19 Add labelled uninterrupted CAD policy GIF previews
2026-10-21 Raise command speed targets with measured stage gates and correct arena scoring
2026-10-22 Require grounded controlled completion of stair trials
